nickvonklemp/Masters-Report/thesis.tex

%=====================================================================
%	UCT MECHATRONICS GROUP TEMPLATE
%---------------------------------------------------------------------
%	Template made by:		R.A. Verrinder
% 	Written  by:	N.R. Von Klemperer
%	Date Modified:	June 2016
%---------------------------------------------------------------------
%	Compile with:	TexMaker 
%=====================================================================
%	Document properties:
%---------------------------------------------------------------------
%	Paper size:			A4
%	Margins:			1 inch margins(top,bottom,left,right)
%	Printing:			Double sided (twoside book)
%	Base font size:		11pt
%	Line spacing:		
%	Paragraph spacing:	10pt
%	Paragraph indent:	0pt
%=====================================================================

\documentclass[a4paper, 11pt, oneside, openright, parskip=full]{book}
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
\newcommand{\city}{Rondebosch, Cape Town}				% City
\newcommand{\country}{South Africa}						% Country
\newcommand{\degre}{Masters of Science}				% Degree (Doctor of Philosophy 
														% or Master of Science)
\newcommand{\degreeabv}{MSc}							% Degree abbreviation (PhD or MSc.)			
\newcommand{\aemail}{Nicholas.VonKlemperer@alumni.uct.ac.za}			% Author email address
\newcommand{\supervisor}{Supervisor}					% Supervisor
\newcommand{\hod}{Prof. E. Boje}						% Head of Department

\newcommand{\logo}										% UCT Logo
{	
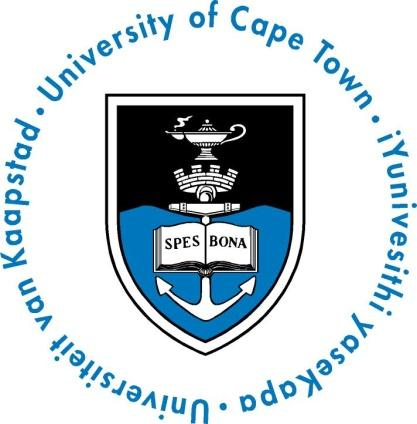
[picture p1: figs/uctLogo.png]
	
}

\newdateformat{mydate}{\monthname[\THEMONTH] \THEYEAR} % Month Year date
\newcommand{\key}{Nonlinear Control, Control Allocation, Quadrotor, UAV}					   % Keywords (add logical keywords)
\newcommand{\norm}[1]{\left\lVert#1\right\rVert}
%---------------------------------------------------------------------
%	MACROS
%---------------------------------------------------------------------
% Signature box
%---------------------------------------------------------------------
\newcommand*{\signature}[1]
{
	\par\noindent\makebox [5cm]{\hrulefill}
	\par\noindent\makebox [5cm][1]{#1}
}
\newtheorem{theorem}{Theorem}[section]
\newtheorem{corollary}{Corollary}[theorem]
\newtheorem{axiom}{Axiom}[theorem]
\newtheorem{lemma}[theorem]{Lemma}
%---------------------------------------------------------------------
% Macro to select font style
% phv = helvetica (sans serif)
% pcr = courier	  (typewritter font)
%---------------------------------------------------------------------
\def\nfont#1#2
{
	{\fontfamily{#1}\selectfont #2}
}					
%---------------------------------------------------------------------
% Creates an block for a block diagram
%---------------------------------------------------------------------
\tikzstyle{arrow}=[->,shorten <=1pt,>=stealth',semithick]
%---------------------------------------------------------------------
%block 1
%---------------------------------------------------------------------
\tikzstyle{block}=[rectangle,
				   draw=black,
				   fill=gray!10,
				   thick, 
				   minimum height = 2cm, 
				   text width=0.15*\columnwidth,]
\tikzstyle{input}  		= [coordinate]
\tikzstyle{output} 		= [coordinate]
\tikzstyle{pinstyle} 	= [pin edge={to-,thin,black}]
\tikzstyle{sum} 		= [draw, fill=blue!20, circle, node distance=1cm]
%---------------------------------------------------------------------
%block 2
%---------------------------------------------------------------------
\tikzstyle{block2}=[rectangle,
				   draw=black,
				   fill=gray!10,
				   thick, 
				   minimum height = 1.8cm, 
				   text width=0.1*\columnwidth,]
\tikzstyle{input}  		= [coordinate]
\tikzstyle{output} 		= [coordinate]
\tikzstyle{pinstyle} 	= [pin edge={to-,thin,black}]
\tikzstyle{sum} 		= [draw, fill=blue!20, circle, node distance=1cm]
%---------------------------------------------------------------------
%flow charts
%---------------------------------------------------------------------
\tikzstyle{state}     = 	[rectangle, 
							 text width=0.15*\columnwidth=2cm, 
							 minimum  height=1.5cm, 
							 text centered, 
							 draw=black]
							 
\tikzstyle{statement}  = 	[rectangle, 
							 text width=0.15*\columnwidth=2cm, 
							 minimum  height=0.5cm, 
							 text centered, 
							 draw=black]							 
							 
\tikzstyle{condition}  = 	[rectangle, 
							 text width=0.15*\columnwidth=2cm, 
							 minimum  height=1cm, 
							 rounded corners =10pt,
							 text centered, 
							 draw=black]
\tikzstyle{decision}  = 	[diamond, 
			                 minimum width=2cm, 
			                 minimum height=1cm, 
			                 text centered, 
			                 draw=black]
\tikzstyle{line} = [draw, -latex']

\definecolor{purp}{HTML}{6C42AA}
\definecolor{brn}{HTML}{939125}
%=====================================================================
%	Start of the document
%---------------------------------------------------------------------
\begin{document}
\setcounter{MaxMatrixCols}{20}
%=====================================================================
%	TITLE PAGE
%=====================================================================
\begin{titlepage}
	\centering
	\vspace*{1cm}

%---------------------------------------------------------------------
% Title
%---------------------------------------------------------------------	
	\begin{Huge}					
		\bfseries\titl\par
		\vskip 5mm
		%\hrule
		%\vskip 1.2cm
	\end{Huge}
%---------------------------------------------------------------------
% Subtitle	(optional)
%---------------------------------------------------------------------
	\begin{Large}					
		\subtitle\\*
		\vskip 3cm
	\end{Large}
%---------------------------------------------------------------------
% UCT logo
%---------------------------------------------------------------------	
	\logo							
	\vskip 1.5cm	
%---------------------------------------------------------------------
% Author	
%---------------------------------------------------------------------	
	\begin{Large}					
		\bfseries\auth\\
	\end{Large}
%---------------------------------------------------------------------
% Author's address	
%---------------------------------------------------------------------		
	\begin{normalsize}				
		\vskip 2mm	
		\dept\\*
		\uni\\*
		\city\\*
		\country\\*
		
		\vskip 15mm	
	\end{normalsize}
%---------------------------------------------------------------------
% Supervisor (optional)	
%---------------------------------------------------------------------		
%	\begin{large}					
%		{\itshape Supervisor: \\*}
%		\supervisor\\
%		\vskip 5mm
%	\end{large}
%---------------------------------------------------------------------
% Date	
%---------------------------------------------------------------------
	\begin{Large}					
		{\bfseries \mydate\today}
		\vskip 15mm	
	\end{Large}
%---------------------------------------------------------------------
% Degree	
%---------------------------------------------------------------------		
		\degreeabv\ dissertation submitted in fulfillment of the requirements for the degree of \degre\ in the \dept\ at the \uni
		
		\vskip 15mm	
%---------------------------------------------------------------------
% Keywords	
%---------------------------------------------------------------------		
	\begin{normalsize}				
		{\itshape Keywords:}
		\key			
	\end{normalsize}	
\end{titlepage}
\afterpage{\null\newpage}
%=====================================================================
%	FRONT MATTER
%=====================================================================
\frontmatter
\begin{center}
\begin{minipage}{0.7\textwidth}
\centering
``\emph{We're gonna have a superconductor turned up full blast and pointed at you for the duration of this next test. I'll be honest, we're throwing science at the wall here to see what sticks. No idea what it'll do. Probably nothing. Best-case scenario, you might get some superpowers\ldots}"
\\
Cave Johnson -Founder \& CEO of Aperture Science
\end{minipage}
\end{center}
%---------------------------------------------------------------------
%	Declaration
%---------------------------------------------------------------------
\chapter{Declaration}				
\label{ch:decl}
% Change name
I, \auth,  hereby:

\begin{enumerate}
	\item		grant the \uni\  free license to reproduce the above dissertation in whole or in part, for the purpose of research only;
	\item		declare that:
	
	\begin{enumerate}
		\item		This dissertation is my own unaided work, both in concept and execution, and apart from the normal guidance from my supervisor, I have received no assistance except as stated below:
				% Note any exceptions
		\item		Neither the substance nor any part of the above dissertation has been submitted in the past, or is being, or is to be submitted for a degree at this University or at any other university, except as stated below.
		\item		Unless otherwise stated or cited, any and all illustrations or diagrams demonstrated in this work are my own productions.
				% Note any exceptions
		\item 		All the content used to compile this report and complete the investigation revolving around the whole project is collectively hosted on the following GIT repositories:
		\begin{itemize}
			\item \LaTeX report: \url{https://github.com/nickvonklemp/Masters-Report}
			\item STM32F303 projects: \url{https://github.com/nickvonklemp/Code}
			\item Hardware Schematics: \url{https://github.com/nickvonklemp/visio} \&
			\item EagleCad Schematics \url{https://github.com/nickvonklemp/Eagle}
			\item MatLab Simulink Code: \url{https://github.com/nickvonklemp/Simulink}
			\item Results \& Simulation Data: \url{https://github.com/nickvonklemp/results}
			\item All CAD design files \& assemblies: \url{https://grabcad.com/nick.vk-1}
		\end{itemize}
	\end{enumerate}	
\end{enumerate}

\begin{flushright}	% Signature field
	\vskip 2cm
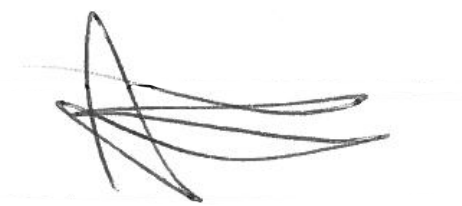
[picture p2: figs/sign.png]
	\noindent 
	\vspace{-20pt}
	\noindent \signature{x}
	\noindent \auth \\*
	\vskip 2mm
	\noindent \dept \\*
	\noindent \uni \\*
	\vskip 2mm
	\noindent \today
\end{flushright}
%---------------------------------------------------------------------
%	Abstract
%---------------------------------------------------------------------
\chapter{Abstract}				
\label{ch:abs}
%---------------------------------------------------------------------
\begin{center}
	\textbf{\Large \titl}\\
			\vskip 0.2cm
			\auth\\
			\vskip 0.2cm
	\textit{\footnotesize\today}
			\vskip 1cm
\end{center}
%---------------------------------------------------------------------
This dissertation aims to apply non-zero attitude and position setpoint tracking to a quadrotor aircraft, achieved by solving the problem of a quadrotor's inherent underactuation. The introduction of extra actuation aims to mechanically accommodate for stable tracking of non-zero state trajectories. The requirement of the project is to design, model, simulate and control a novel quadrotor platform which can articulate all six degrees of rotational and translational freedom (6-\emph{DOF}) by redirecting and vectoring each propeller's individually produced thrust. 
\par
Considering the extended articulation, the proposal is to add an additional two axes (degrees) of actuation to each propeller on a traditional quadrotor frame. Each lift propeller can be independently pitched or rolled relative to the body frame. Such an adaptation, to what is an otherwise well understood aircraft, produces an over-actuated control problem. Being first and foremost a control engineering project, the focus of this work is plant model identification and control solution of the proposed aircraft design. A higher-level setpoint tracking control loop designs a generalized plant input (net forces and torques) to act on the vehicle. An allocation rule then distributes that \emph{virtual} input in solving for explicit actuator servo positions and rotational propeller speeds.
\par
The dissertation is structured as follows: First a schedule of relevant existing works is reviewed in Ch:\ref{ch:intro} following an introduction to the project. Thereafter the prototype's design is detailed in Ch:\ref{ch:proto}, however only the final outcome of the design stage is presented. Following that, kinematics associated with generalized rigid body motion are derived in Ch:\ref{ch:dynamics} and subsequently expanded to incorporate any aerodynamic and multibody nonlinearities which may arise as a result of the aircraft's configuration (changes). Higher-level state tracking control design is applied in Ch:\ref{ch:control} whilst lower-level control allocation rules are then proposed in Ch:\ref{ch:allocation}. Next, a comprehensive simulation is constructed in Ch:\ref{ch:simulation}, based on the plant dynamics derived in order to test and compare the proposed controller techniques. Finally a conclusion on the design(s) proposed and results achieved is presented in Ch:\ref{ch:conclusion}.
\par
Throughout the research, physical tests and simulations are used to corroborate proposed models or theorems. It was decided to omit flight tests of the platform due to time constraints, those aspects of the project remain open to further investigation. The subsequent embedded systems design stemming from the proposed control plant is outlined in the latter of Ch:\ref{ch:proto}, Sec:\ref{sec:proto.layout}. Such implementations are not investigated here but design proposals are suggested. The primary outcome of the investigation is ascertaining the practicality and feasibility of such a design, most importantly whether or not the complexity of the mechanical design is an acceptable compromise for the additional degrees of control actuation introduced. Control derivations and the prototype design presented here are by no means optimal nor the most exhaustive solutions, focus is placed on the whole system and not just a single aspect of it.
\par
%---------------------------------------------------------------------
%	Acknowledgements
%---------------------------------------------------------------------
\chapter{Acknowledgements}		
\label{ch:ack}
%---------------------------------------------------------------------
Firstly, I would like to thank Prof Edward Boje for the supervision he provided throughout this research. Secondly, without the support of everyone in the Mechatronics Lab (Room 6.00) at the University of Cape Town, this project would not have been possible. And last, but certainly not least, I would like to thank my parents who supported and guided me throughout the tenure of my studies. 
%---------------------------------------------------------------------
%	Nomenclature
%---------------------------------------------------------------------
\chapter{Nomenclature}
\label{ch:nom}
%---------------------------------------------------------------------
\underline{In order of appearance:}
\par
3-D : Three-dimensional vector components in Cartesian XYZ axial
4-DOF : 4 Degrees of freedom, reduced attitude control\\
6-DOF : 6 Degrees of freedom, full attitude and position states\\
ABC - Adaptive backstepping control\\
BLDC : Brushless-DC, motor\\
BEM : Blade element theory, calculation for produced thrust from propeller\\
CMG : Control moment gyroscope, satellite actuator\\
CH: Channel, number of PWM lines or RC channels \\
DIY : Do it yourself, quadcopter assembly kit in context example\\
dOAT : Dual-axis opposed active tilting, two-axis birotor rotation\\
ESC : Electronic speed controller\\
FTC : Fault tolerant control\\
GCS : Ground control station, supplements onboard control loops for UAVs\\
IBC - Ideal backstepping control\\
IMU : Inertial measurement unit, an MEM 9-DOF accelerometer/gyroscope/magnetometer\\
ITAE : Integral time absolute error, cost function used for optimization\\
KV : Kilo-volt, thousand RPM per V applied, BLDC motor rating\\
LQR : Linear quadratic regulator control structure\\
LCF : Lyapunov candidate function\\
MPC : Model predictive control\\
MEMS : Micro-electromechanical system, accelerometer or gyroscopes\\
OAT : Opposed active tilting, single-axis birotor rotation\\
PD : Proportional + derivative controller\\
P.D : Positive definite\\
PWM : Pulse width modulation\\
PID : Proportional + integral + derivative controller\\
PSO : Particle swarm optimization\\
QFT : Quantitative feedback theory\\
RPM : Revolution per minute, units for propeller rotational 
velocity\\
RPS : Revolution per second, units for propeller speed when calculating BEM thrust\\
Rx : Receiver channel, comms line input\\
S.bus : Serial.Bus, proprietary encoding of UART comms\\
SISO : Single input single output, typical control loop\\
STP : Standard temperature and pressure\\
TSK : Takagi-Sugeno-Kang, fuzzy logic paradigm\\
Tx : Transmitter channel, comms line output
$\mu$C : Micro-controller\\
UAV : Unmanned aerial vehicle, any autonomous aircraft\\
USART : Universal synchronous/asynchronous receiver transmitter, 2 wire comms\\
VTOL : Vertical takeoff/landing. Helicopter or quad/bi-rotor\\
 directions\\
%---------------------------------------------------------------------
%	Symbols
%---------------------------------------------------------------------
\chapter{Symbols}
\label{ch:symbol}
%---------------------------------------------------------------------
An arrowed overbar implies vector quantity (column vector)\\
A vector with an $T$ superscript refers to that vector's transpose\\
A subscript $\mu$ denotes a control input quantity\\
A subscript $i$ refers to a quantity associated with the $i^{\text{th}}$ motor module\\
Any subscript numbered $1\rightarrow 4$ refer to quantities associated with a particular motor module\\
Axes are referred to with hat accents and described as an axis in context\\
Estimated quantities are also denoted with a hat accent but are similarly described as an estimate in context\\
Lowercase axis quantities are unit vectors in a particular axial direction\\
Uppercase axis quantities refer to the axes themselves\\
Bold faced vectors are lumped state variables\\
Dot accents denote derivatives of vectors or quantities\\
Subscripts $M_i$ imply reference to the $i^{\text{th}}$ motor module's frame\\
The frame $\mathcal{F}^i$ refers to the $i^{\text{th}}$ reference frame\\
An origin of a frame is given by $\vec{\mathbf{O}}_i$\\
Lowercase body vectors imply state trajectories\\
Uppercase bold vectors represent Euler-Lagrange generalized forces acting as a result of the same case's lowercase trajectory
\par
Where possible, typical conventions for quantities and notations have been adhered to
\par
$\alpha_i$ motor module rotation about the $\hat{Y}_{M_i'}$ axis\\
$\delta (\varepsilon)$ stable trajectory's maximum bound\\
$\varepsilon$ stable trajectory initial bounding manifold\\
$\vec{\eta}=[\phi~\theta~\psi]^T~~\in\mathcal{F}^{I,v_1,v_2}$ Euler angle set\\
$\vec{\eta}_b \in\mathcal{F}^b$ transformed Euler angles in common shared body frame\\
$\theta$ pitch rotation about $\hat{Y}$ axis in [rad] \\
$\lambda_i$ motor module rotation about the $\hat{X}_{M_i}$ axis\\
$\vec{\nu}_d=[\vec{F}_d~\vec{\tau}_d\hspace{2pt}]^T\in\mathcal{F}^b$ generalized virtual control input\\
$\vec{\xi}$ generalized position coordinate\\
$\rho$ STP airdensity\\
$\sigma_i$ motor module rotation about the $\hat{Z}_{M_i''}$ axis\\
$\vec{\tau}_\mu = [\tau_\phi~\tau_\theta~\tau_\psi]^T~~\in\mathcal{F}^b$ input torque in [Nm]\\
$\vec{\tau}_d = h(\vec{\eta}_e,~\dot{\vec{\eta}}_e,~t)~~\in\mathcal{F}^b$ attitude controller generated torque input in [Nm]\\
$\phi$ roll rotation about $\hat{X}$ axis in [rad] \\
$\psi$ yaw rotation about $\hat{Z}$ axis in [rad]\\
$\vec{\omega}_b=[p~q~r]^T~~\in\mathcal{F}^b$ angular velocity in body frame with units $[\text{rad.s}^{-1}]$\\
$\Omega_i$ rotational velocity of $i^{\text{th}}$ propeller, in [RPM] or [RPS] specified\\
\par
$\mathbf{AS}$ asymptotic stability\\
$b$ subscript for net multibody assembly\\
$c$ propeller chord length\\
$\vec{C}_x$ center of mass for body x, relative to origin $\vec{\mathbf{O}}_b$\\
$C_T(J)$ aerodynamic thrust coefficient, varies as function of the advance ratio\\
$C_P(J)$ aerodynamic power coefficient, varies as function of the advance ratio\\
$D$ propeller diameter\\
$\vec{D}(\vec{v}_b)$ aerodynamic drag as a function of the vehicle's net translational velocity\\
$\vec{\mathcal{E}}_I=[x~y~z]^T~~\in\mathcal{F}^{I}$ inertial position in [m]\\
$\mathbf{ES}$ exponential stability\\
$\vec{F}_d=g(\vec{\mathcal{E}}_e,~\dot{\vec{\mathcal{E}}}_e,~t)~~\in\mathcal{F}^b$ position controller generated force input in [N]\\
$\vec{F}_\mu=[F_x~F_y~F_z]^T~~\in\mathcal{F}^b$ input force in [N]\\
$\mathbf{GUAS}$ global uniform asymptotic stability\\
$\mathbf{GUES}$ global uniform exponential stability\\
$\vec{H}$ generalized attitude coordinate\\
$in$ subscript for inner ring assembly \emph{without} rotor body contribution\\
$J$ aerodynamic advance ratio, inflow velocity relative to propeller's rotational speed\\
$J_x$ moment of inertia for body x, relative to the frame provided in context measured in $[\text{kg.m}^{2}]$\\
$\vec{L}_i$ vector arm length from $\vec{\mathbf{O}}_b$ origin in $[\text{m}]$\\
$\mathcal{L}_x$ Lagrangian scalar with respect to body x\\
$m$ subscript for middle ring assembly\\
$m_x$ mass for body x in $[\text{kg}]$\\
$\vec{\mathbf{M}}_i$ $i^\text{th}$ motor module center of rotation\\
$n$ subscript for inner ring assembly\\
$\vec{\mathbf{O}}_b$ body frame origin of motion\\
$p$ subscript for net motor module assembly\\
$q_0$ and vector $\vec{q}$ components\\
$Q_b=[q_0~\vec{q}\hspace{2pt}]^T$ attitude quaternion with scalar 
$r$ subscript for rotor body\\
$\vec{r}(t)$ generalized path trajectory for Euler-Lagrange equation\\
$\mathbf{S}$ general stability\\
$T$ Kinetic energy\\
$T(\Omega_i)$ scalar propeller thrust as a function of rotational speed\\
$\vec{u}=[\Omega_1~...~\alpha_4]^T$ actuator plant input matrix, $\in\mathbb{R}^{12}$\\
$U$ Potential energy
$\mathbf{UAS}$ uniform asymptotic stability\\
$\mathbf{US}$ uniform stability\\
$\vec{v}_b=[u~v~w]^T~~\in\mathcal{F}^b$ translational velocity in body frame with units $[\text{m.s}^{-1}]$\\
$V(\vec{\mathbf{r}})$ Lyapunov function of some trajectory $\vec{\mathbf{r}}(t)$\\
$x$ translational position in the $\hat{X}_I$ axis direction\\
$\vec{\mathbf{x}}_b$ full 6-DOF state for combined attitude and position\\
$\vec{\mathbf{x}}_d$ desired state setpoint\\
$\vec{\mathbf{x}}_e$ error state, not necessarily subtractive, quaternion errors are multiplicative\\
$y$ subscript for constant body frame structure\\
$y$ translational position in the $\hat{Y}_I$ axis direction\\
$z$ translational height in the $\hat{Z}_I$ axis direction\\

%---------------------------------------------------------------------
%	Dedication (optional)
%---------------------------------------------------------------------
%\begin{flushright}
%	\vspace*{10cm}
%	{\itshape dedication .....}
%\end{flushright}
%---------------------------------------------------------------------
%	Table of Contents
%---------------------------------------------------------------------
\tableofcontents

%---------------------------------------------------------------------
%	List of Figures
%---------------------------------------------------------------------
\listoffigures

%---------------------------------------------------------------------
%	List of Tables
%---------------------------------------------------------------------
\listoftables

%---------------------------------------------------------------------
%	List of Symbols/Document conventions (optional)
%---------------------------------------------------------------------

%---------------------------------------------------------------------
%	Glossary (optional)
%---------------------------------------------------------------------

%=====================================================================
%	MAIN MATTER
%=====================================================================
% Create a separate file for each chapter. You may chose to rename these
% chapters as needed.
%---------------------------------------------------------------------
\mainmatter
\include{ch1}
\include{ch2}
\include{ch3}
\include{ch4}
\include{ch5}
\include{ch6}
\include{ch7}
\include{appendix}

%=====================================================================
%	BACK MATTER
%=====================================================================

\backmatter

%---------------------------------------------------------------------
%	BIBLIOGRAPHY
%---------------------------------------------------------------------

\raggedright
\bibliographystyle{plain}
\bibliography{thesis}

%---------------------------------------------------------------------
\end{document}
%---------------------------------------------------------------------
%	End of the document
%=====================================================================
