nickvonklemp/Masters-Report/ch6.tex

%====================================================
%	CHAPTER 6 - Control & Simulations
%====================================================
\chapter{Simulations and  Discussion of Results}
\label{ch:simulation}
%====================================================
\section{Simulator description}
\label{sec:simulation.block}
%====================================================
The proposed attitude and position control laws, together with the system's equations of motion including each actuator's transfer function, were all tested in simulation to determine a particular controller's efficacy. The rigid-body equations of motion from Sec:\ref{subsec:dynamics.rigidbody.lagrange}, with nonlinearities from Sec:\ref{sec:dynamics.aero} and multibody responses from Sec:\ref{sec:dynamics.nonlinearities}, were incorporated into a high-fidelity simulation environment. Closely matching the dynamics of the physical quadrotor prototype proposed in Sec:\ref{sec:proto.design}, where measurement data produced by tests in Sec:\ref{subsec:dynamics.nonlinearities.torque-tests} provides a degree of confidence in the simulation's accuracy. The consolidated quaternion dynamics in Sec:\ref{sec:dynamics.model} formed the basis of the simulation, building a loop extended from the control structure in Fig:\ref{fig:control-block}. Each control law is optimized first without the effect of the servo's $180$\textdegree ~saturation limit. Limiting the servos was a conscious design decision, and so its effects are investigated in Sec:\ref{sec:simulation.saturation}. For now, the servos are treated as continuous rotational actuators without saturation limits.
\par
\begin{figure}[htbp]
\centering
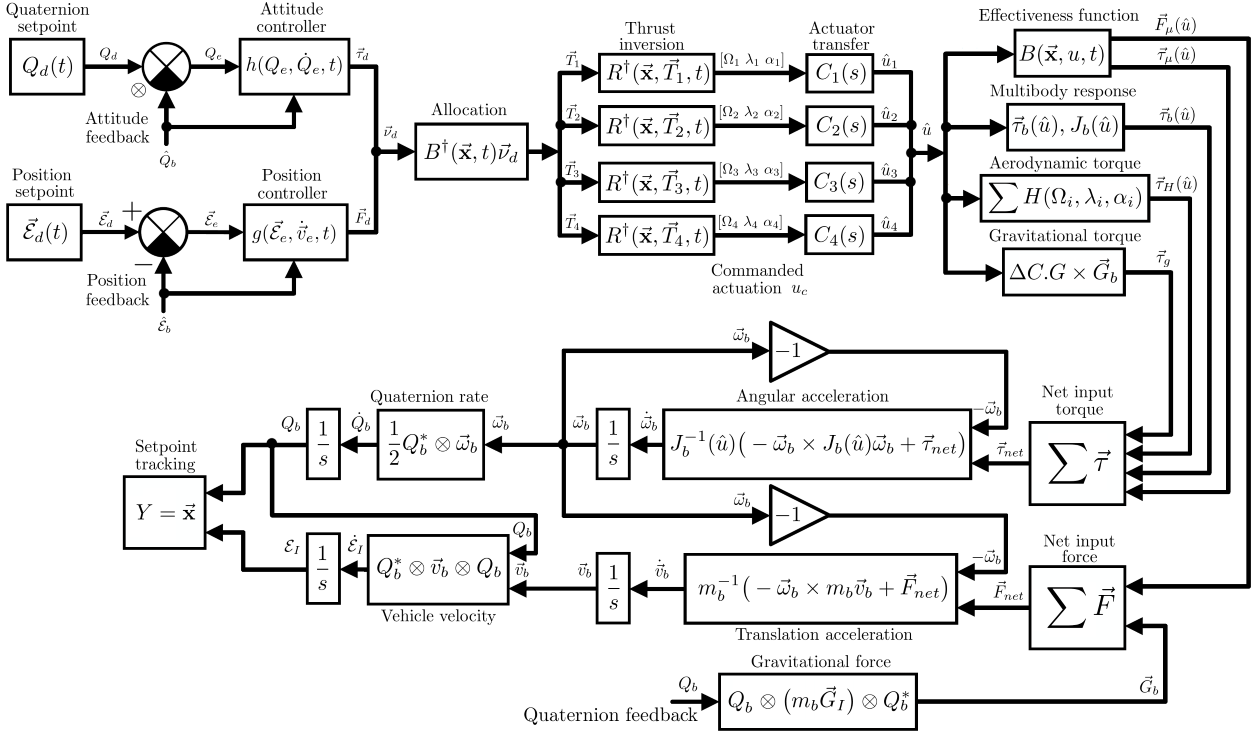
[picture p115: figs/simulation-block.png]

\vspace{-10pt}
\caption{Simulation loop}
\label{fig:simulation-block}
\end{figure}
\par
An abstracted simulation loop is illustrated in Fig:\ref{fig:simulation-block}, incorporating both attitude and position control loops together with the additive nonlinearities. Certain feedback elements were omitted to retain clarity in the diagram, both Coriolis and gyroscopic nonlinear cross-products were included to highlight the inherent coupling between attitude and position. Not shown, but implied, is some form of state-estimation or discretization between the state-tracking output $y=\vec{\mathbf{x}}=[\vec{\mathcal{E}}_I~Q_b\hspace{2pt}]^T$ and the feedback state estimate $\hat{\mathbf{x}}$ used for setpoint tracking. Discretized effects of state-estimators are discussed later in Sec:\ref{sec:simulation.state}. Initial conditions for each state's integrator, both position $\vec{\mathcal{E}}_I(0)$ and attitude $Q_b(0)$ origins, for their velocities $\dot{\mathcal{E}}_b$ and $\dot{Q}_b$ (and accelerations $\dot{\vec{v}}_b$ and $\dot{\vec{\omega}}_b$ in the body frame $\mathcal{F}^b$) are not illustrated but implied. Obviously starting conditions are important for each trajectory's simulation, but are specifically defined for each simulation in question. Actuator transfer functions from Sec:\ref{subsec:proto.design.transfer} are combined into a bundled $C_{i}(S)$ block, accounting for transfer functions and nonlinear saturation limits of each motor module. Each bundled input $\vec{u}_{[1:4]}$ is similarly the projected actuator matrix:
\begin{equation}
\vec{u}_i = \begin{bmatrix}
\Omega_i & \lambda_i & \alpha_i
\end{bmatrix}~~~~\text{for}~i\in[1:4]
\end{equation}
The resultant thrust vector $\vec{T}_i$ produced by each motor module has a net transfer function as a result of the propeller speed and servo rotation dynamics. Lastly, setpoints for both attitude and position states are either stepped or produced from an orbital trajectory. The former is used for controller optimization, whilst the latter is used for setpoint tracking performance evaluation. To discuss the question of non-zero setpoint tracking, an orbital trajectory with an increasing orbital (\emph{chirp}) frequency generates attitude and position setpoints, illustrated in Fig:\ref{fig:trajectory}.
\begin{figure}[htbp]
\vspace{-10pt}
\centering
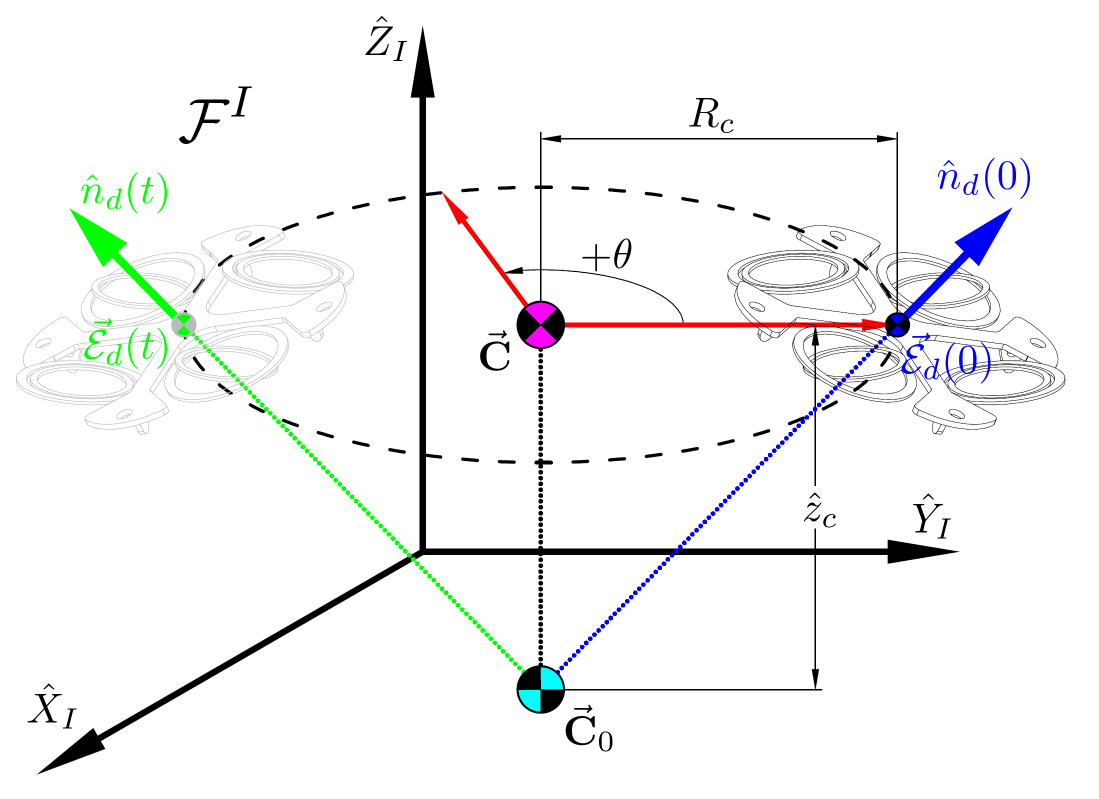
[picture p116: figs/trajectory.png]

\vspace{-12pt}
\caption{Orbital trajectory}
\label{fig:trajectory}
\vspace{-20pt}
\end{figure}
\par
The trajectory generates only first-order attitude and position setpoints. Furthermore, the trajectory setpoint is a body's attitude and inertial position, no actuator values for the aircraft's configuration are commanded by a trajectory. For a central point in the inertial frame $\vec{C}_0\in\mathcal{F}^I$, the trajectory orbits with a \emph{chirpiness} (frequency rate) of $\dot{\omega}~[\text{Hz.s}^{-1}]$ around that center. The orbit is at a height of $\hat{z}_c~[\text{m}]$ and at a radius $R_c~[\text{m}]$ from the center $\vec{C}$. The position setpoint then follows:
\begin{subequations}
\begin{equation}\label{eq:position-trajectory}
\vec{\mathcal{E}}_{d}(t)=\begin{bmatrix}
C_{0x}+R_c\cos\big(\dot{\omega}(t^2)\big)\\
C_{0y}+R_c\sin\big(\dot{\omega}(t^2)\big)\\
\hat{z}_c
\end{bmatrix}~~~~\in\mathcal{F}^I
\end{equation}
{\emph{\color{Gray}The frequency rate $\dot{\omega}$ used in Eq:\ref{eq:position-trajectory} describes the rate at which a chirp generated trajectory increases. It is not the same as a body's angular velocity $\vec{\omega}_b$. By convention, a signal's frequency is annotated by $\omega$.}}
\par
The time varying trajectory's attitude setpoint is aligned with a normal vector $\hat{n}_d(t)$, banking the vehicle away from the center point $\vec{C}_0$:
\begin{equation}
\hat{n}_d(t)\triangleq\frac{\vec{\mathcal{E}}_d(t)-\vec{C}_0}{\sqrt{\hat{z}_c^2+R_c^2}}
\end{equation}
The normal $\hat{n}_d$ is used to construct a quaternion setpoint $Q_d(t)$ which varies together with the orbital trajectory:
\begin{equation}
Q_d(t)=\begin{bmatrix}
\sin \frac{\theta(t)}{2} & \cos \frac{\theta(t)}{2}\hat{n}_d(t)
\end{bmatrix}^T
\end{equation}
\end{subequations}
Whilst the trajectory equation itself may have a non-zero time derivative, both attitude and position controllers still apply the respective rate setpoints to the state variables $\dot{\vec{\mathcal{E}}}_d(t)=\vec{0}$ and $\dot{Q}_d(t)=\vec{0}$ throughout the entire trajectory, as per Eq:\ref{eq:4.85a} and Eq:\ref{eq:4.27c}. The plot in Fig:\ref{fig:Trajectory_Plot} shows a chirp quaternion and attitude trajectory, $Q_d(t)$ and $\vec{\mathcal{E}}_d(t)$ respectively, over a time period of $240~[\text{s}]$. The trajectory starts at $\vec{\mathcal{E}}_d(t_0)=[6~6~5]^T~[\text{m}]$, which produces a non-zero starting attitude $Q_d(t_0)=[0.38~0.42~0.24~0.7]^T$, Eq:\ref{fig:Position_Trajectory}.
\begin{figure}[htbp]
\vspace{-6pt}
\centering
\begin{subfigure}{\textwidth}
\centering
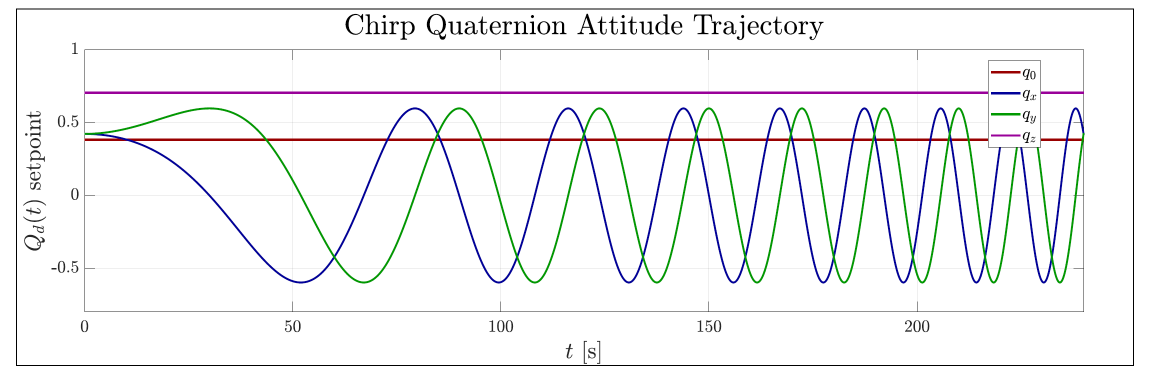
[picture p117: graphs/Attitude_Trajectory.png]

\vspace{-6pt}
\caption{Quaternion setpoints}
\label{fig:Attitude_Trajectory}
\end{subfigure}
\begin{subfigure}{\textwidth}
\centering
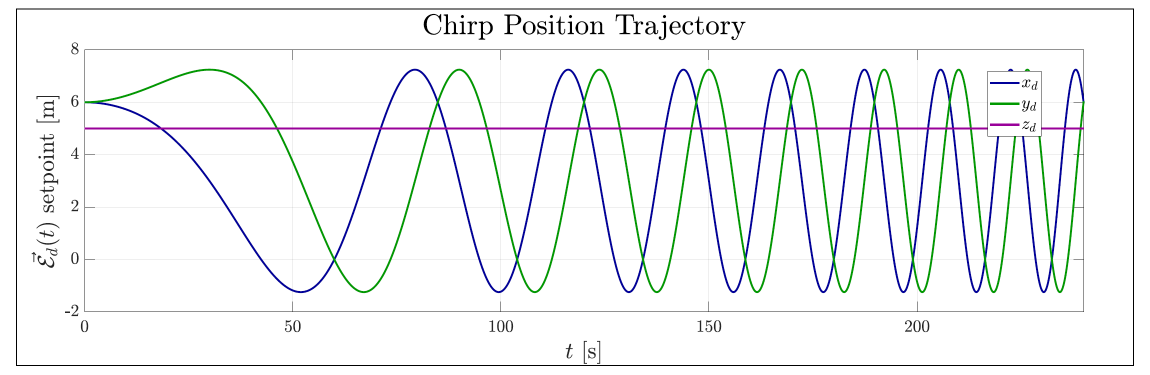
[picture p118: graphs/Position_Trajectory.png]

\vspace{-6pt}
\caption{Position setpoints}
\label{fig:Position_Trajectory}
\end{subfigure}
\vspace{-8pt}
\caption{Chirp trajectory plots}
\label{fig:Trajectory_Plot}
\vspace{-12pt}
\end{figure}
%====================================================
\section{Controller Tuning}
\label{sec:simulation.tuning}
%====================================================
Each proposed control law's proven stability (in Sec:\ref{sec:control.attitude} and Sec:\ref{sec:control.position} for attitude and postition controllers respectively) demonstrates only a control law's setpoint tracking (error stability) for a time $t\rightarrow\infty$. The caveat to Lyapunov's stability theorem is that a trajectory is shown to be stabilizing, however no further insight into the controller coefficient design is provided. Often at the coefficient selection stage, a \emph{Monte Carlo} approach is applied to select and optimize the controller coefficients.
%====================================================
\subsection{Particle Swarm Optimization Algorithm}
\label{subsec:simulation.tuning.pso}
%====================================================
Particle swarm based optimization (\emph{PSO}) has been shown in both \cite{adaptivepso} and \cite{autopilotPSO}, amongst others, to be an effective controller coefficient design tool. The algorithm treats a potential set of controller coefficients as a single \emph{particle} which exists within some defined search space. The collection or \emph{swarm} of possible particles explores the search space directed by both the swarm's previous performance as well as the relative performance of the swarm between each particle. In \cite{particletrajectories} the statistical nature of the swarm's trajectory is discussed, however such investigations are beyond the scope of this work.
\par
In general, the PSO algorithm applies a \emph{gradient-free} based search of solutions for a given optimization problem. The lack of a specified cost function gradient is an important distinction which differentiates PSO from other algorithms (note the swarm does update as per a pseudo-velocity function). Often a predefined cost function gradient is required to direct the optimization search at each interval, MatLab's fmincon\cite{fmincon} or Interior-Point optimizer\cite{ipopt} algorithms for example. Interval gradient calculations can be computationally exhaustive and reduce the rate of execution for the entire process. An optimizer's performance is directly proportional to the number of complete iterations it executes, and if an iteration has a high degree of complexity (simulation \emph{stiffness}) its solution time is then adversely affected. The PSO algorithm is defined as follows: if there exists a set $\vec{x}$ of $k$ variables, $\vec{x}\in\mathbb{R}^{k\times 1}$ to be optimized, the swarm of particles (starting at particle $\vec{x}_0$) has an $n^{\text{th}}$ interval position $\vec{x}_n$ which progresses through the search space as per a velocity $\vec{v}_n$:
\begin{subequations}
\begin{equation}
\vec{x}_{n+1}=\vec{v}_{n}+x_{n}
\end{equation}
\vspace{-18pt}
\begin{equation}\label{eq:swarm-velocity}
\vec{v}_{n+1}\triangleq w\ast \vec{v}_n+c_1\ast r_1\big(\vec{P}_{best}-\vec{x}_n\big)+c_2\ast r_2\big(\vec{G}_{best}-\vec{x}_n\big)
\end{equation}
\end{subequations}
where each $\ast$ operator in Eq:\ref{eq:swarm-velocity} applies an element-by-element matrix coefficient multiplication. Both $\vec{P}_{best}$ and $\vec{G}_{best}$ are previous swarm positions where local and global optima were respectively achieved. Performance of the swarm's current interval is evaluated as per some cost function, responding to a system's dynamics. Finally $r_1$ and $r_2$ are random seeded $\mathbb{R}^{1\times k}$ exploratory matrices which progress the search direction, biased by the two weighting coefficients $c_1$ and $c_2$. The search is prejudiced toward local optima by $c_1$, whilst $c_2$ directs the swarm toward global optima. Fig:\ref{fig:swarm-trajectory} illustrates how positions of both local and global optima influence subsequent velocities.
\begin{figure}[hbtp]
\centering
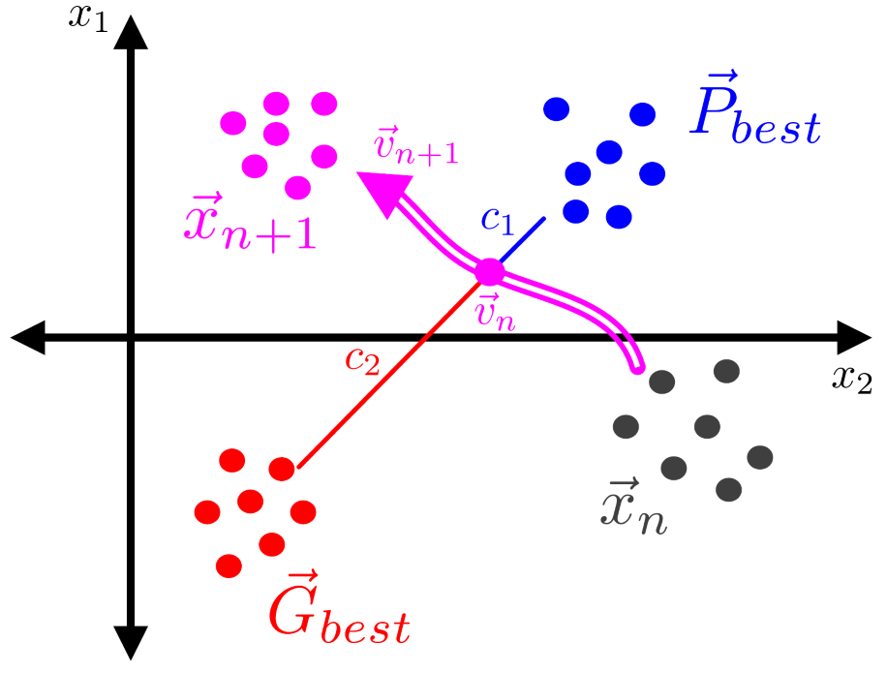
[picture p119: figs/swarm-trajectory.png]

\vspace{-10pt}
\caption{Swarm trajectory's velocity direction}
\label{fig:swarm-trajectory}
\vspace{-8pt}
\end{figure}
\par
The swarm's interval performance is evaluated by the response of some modelled system to the swarm's position, typically an error deviation away from some desired state. Here, the simulation described in Fig:\ref{fig:simulation-block}, is parsed a swarm of controller coefficients as an argument and the plant's setpoint response is simulated over a series of step tests. Particulars with regards to attitude controller optimization are discussed in Sec:\ref{sec:simulation.attitude}, thereafter position controller optimization is detailed in Sec:\ref{sec:simulation.position}. The objective is for zero-error setpoint tracking so each particle's coefficient performance metric calculates an integral-time-absolute-error (\emph{ITAE}) cost function, \cite{ITAE}.
\begin{equation}
\vec{\zeta}\triangleq\int_{t_0}^{t_\infty}t||\vec{e}(t)||_2.dt
\end{equation}
with an error $\vec{e}(t)$ deviating from the plant's given setpoint. The ITAE integral $\vec{\zeta}$ is calculated over the entire simulation time, or an effective $t_\infty$. The time multiplier ensures setpoint error \emph{and} settling time optimality, punishing overshoot and under-damped or oscillatory-like behavior. Generally a PSO algorithm progresses as in the flow diagram in Fig:\ref{fig:particle-diagram}. Seeing that each controller was empirically proven to be stable irrespective of its trajectory, the controller will settle irrespective of the proposed interval coefficient values. A consequence of this is that starting conditions $\vec{x}_0$ were chosen to be a rounded set of unity.
\\
\emph{\color{Gray} Note that $\vec{\mathbf{x}}$ is a state variable in the particle swarm flow diagram Fig:\ref{fig:particle-diagram}, $\vec{j}_n$ was chosen to represent the swarm of particles acted on by the optimization algorithm in order to differentiate between the two.}
\\
\begin{figure}[htbp]
\centering
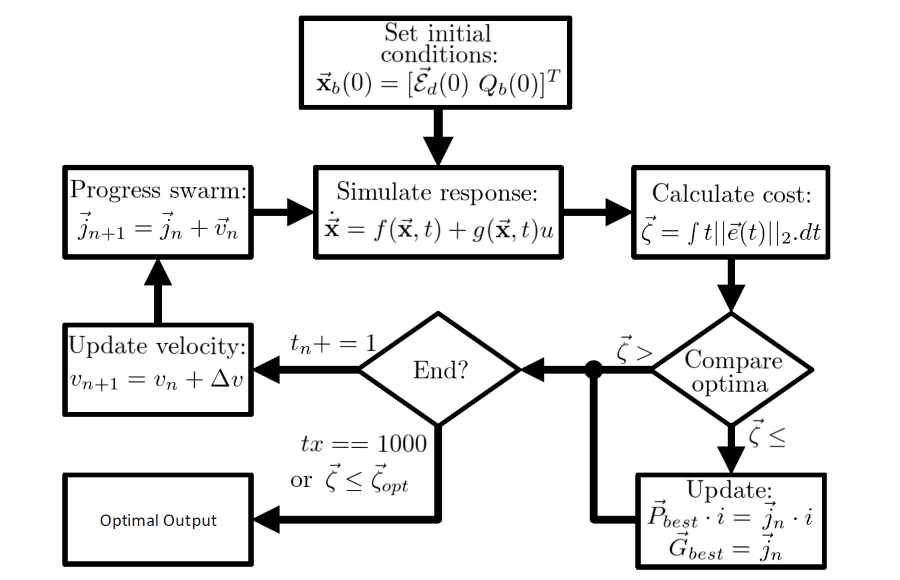
[picture p120: figs/particle-diagram.png]
\vspace{-12pt}
\caption{Particle swarm flow diagram}
\label{fig:particle-diagram}
\vspace{-18pt}
\end{figure}
\par
Termination conditions for the iterative optimization loop either limit the number of iteration cycles performed or break from the process once a result is regarded as sufficiently close to optimal. Each optimization loop was terminated only after a limited $tx=1000$ iterations, testing and evaluating one thousand different swarm values for a series of stepped setpoints. With control coefficients, it is difficult to quantify how close to optimal a particular proposed set of coefficients is. As the optimizer progressed through iterations, it adapted its bias coefficients $c_1$ and $c_2$ from focusing on global optima to local optima using fractions of the iteration number, refining the way in which it searched for potential controller coefficients.
\begin{equation}
\vec{v}_{n+1}=\vec{v}_n+\frac{tx}{1000}\ast r_1(\vec{P}_{best}-\vec{x}_n)+\frac{1000-tx}{1000}\ast r_2(\vec{G}_{best}-\vec{x}_n)~~~~\text{for}~~tx\in[1:1000]
\end{equation}
Each particle's progression was constrained such that it never violated the Lyapunov stability conditions of its respective control laws, ensuring that the coefficient matrices were kept positive definite and symmetrical.
%====================================================
\section{Attitude Controllers}
\label{sec:simulation.attitude}
%====================================================
Attitude controllers derived in Sec:\ref{sec:control.attitude} were optimized first because of their lack of coupling with the position loop. The position control loop was left in open loop with only a constant hovering force condition applied to control input $\vec{F}_d$ for each test. Pseudo-inverse allocation, Sec:\ref{subsec:allocation.allocators.inverse}, was applied to the control loop when testing each attitude controller. To evaluate an individual particle's performance, a number of step tests were performed. Each attitude setpoint was first defined in the Euler angle parametrization, being conceptually easier to visualize. Thereafter the attitude setpoints were converted to a desired quaternion attitude and applied to the simulation.
\begin{equation}
\vec{\eta}_d(t)\triangleq \begin{bmatrix}
\phi_d(t)&
\theta_d(t)&
\psi_d(t)
\end{bmatrix}^T\underset{Q}{\iff}Q_d(t)
\end{equation}
Each of the three Euler angles were stepped in the range $[-90\text{\textdegree}:+90\text{\textdegree}]$ at intervals of $30\text{\textdegree}$. This resulted in a test of three hundred and forty three possible attitude setpoints, making a test-space sphere as illustrated in Fig:\ref{fig:attitude-setpoint}. Each attitude step was simulated for $t=15~[\text{s}]$ to allow its settling point, with an initial attitude position always set to the origin $Q_b(t_0)=[1~\vec{0}\hspace{2pt}]$, with a \emph{positive} quaternion scalar. The quaternion error's scalar component was limited to $q_0\in[0:1]$, detailed in Eq:\ref{eq:constrained-quaternion-error} of Sec:\ref{subsec:control.attitude.problem}, to ensure positive definite compatibility of the proposed Lyapunov candidate functions in the control proofs. The effect of an unconstrained, negative quaternion error scalar is illustrated in Fig:\ref{fig:PD_Quaternion_Step}. 
\par
Performance for each attitude step test was evaluated by an ITAE integral for the quaternion error vector and angular velocity error. Note that each gain coefficient in a particle has its own local and global error, so the performance metric $\vec{\zeta}_{q}$ is a \emph{vector}, not a scalar quantity:
\begin{equation}\label{eq:attitude-performance}
\vec{\zeta}_{Q}=\int_{t=0}^{15}C_Q*t*q_0*||\vec{q}_e(t)||.dt+\int_{t=0}^{15}C_\omega*t*||\vec{\omega}_e(t)||.dt~~~~\in\mathbb{R}^{3}
\end{equation}
Weighting coefficients $C_Q$ and $Q_\omega$ balance priority of either quaternion or angular velocity tracking. However, tracking both were equally important and so those weights were kept at unit with respective scalar units. The cost integral in Eq:\ref{eq:attitude-performance} was averaged over all three hundred and forty three possible attitude steps to determine the overall performance of a proposed swarm of controller coefficients.
\begin{figure}[htbp]
\vspace{-6pt}
\centering
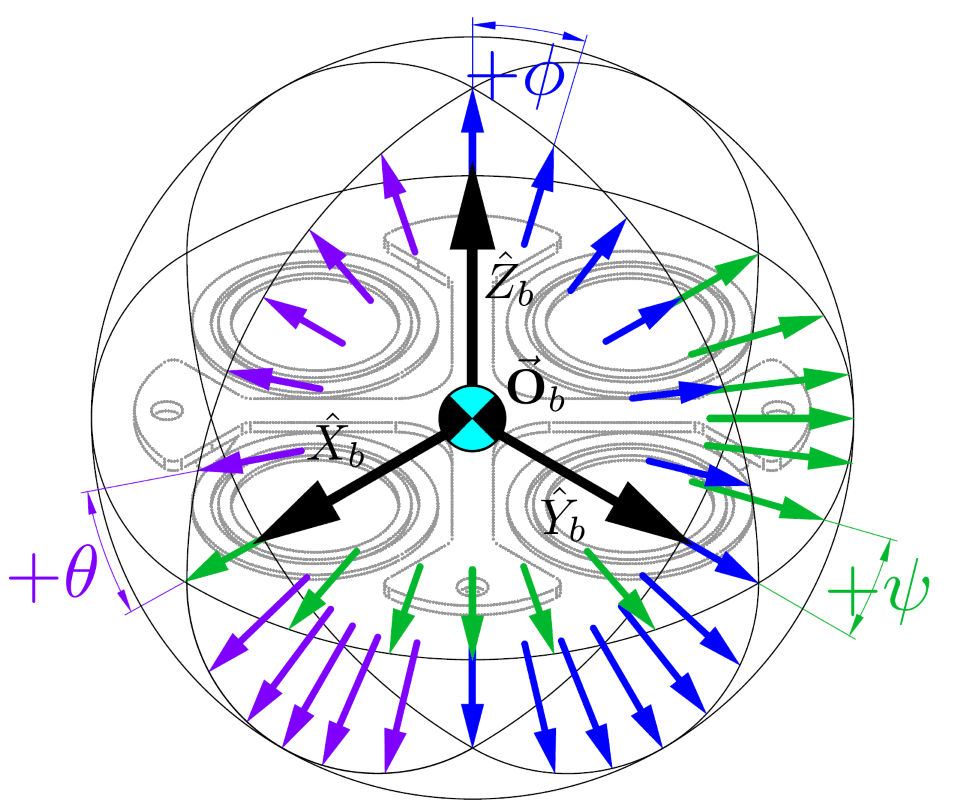
[picture p121: figs/attitude-setpoint.png]

\vspace{-6pt}
\caption{Attitude setpoint working space}
\vspace{-14pt}
\label{fig:attitude-setpoint}
\end{figure}
\par
The integral in Eq:\ref{eq:attitude-performance} produces a $\mathbb{R}^{3}$ vector result. Each coefficient in a particular controller contributes towards a local error in one of the $\hat{X},\hat{Y},\hat{Z}$ components, or in certain cases, a pair of axial components if the control coefficient is an off-diagonal element. A global error for the performance of each controller is simply the magnitude $||\vec{\zeta}_Q||$. The same global error is applicable to all controllers. 
\par
To compare the relative performance and effectiveness of each optimized control structure, a single attitude step was investigated. That attitude change was chosen to be a sizeable step in all three Euler angles to demonstrate the effect of the actuator's dynamics:
\begin{equation}\label{eq:attitude-step-position}
\vec{\eta}_d\triangleq\begin{bmatrix}
\phi_d\\
\theta_d\\
\psi_d\\
\end{bmatrix}
=
\begin{bmatrix*}[r]
-142\text{\textdegree}\\
167\text{\textdegree}\\
-45\text{\textdegree}
\end{bmatrix*}
\underset{Q}{\iff}
\begin{bmatrix}
-0.3254&
0.2226&
-0.2579&
0.8821
\end{bmatrix}^T
\end{equation}
Then each controller's settling time to $95$\% of its final value $t_{95}$ and its relative angular velocity (the setpoint $\vec{\omega}_d=\vec{0}$) for such a step is calculated. Settling time, overshoot and setpoint error are all factors to consider when discussing a controller's efficacy. Lastly, the commanded (virtual) and applied input torque to the actuator set are discussed too. A feasible controller should not induce torque saturation or unachievable input rate changes.
%====================================================
\subsection{PD}
\label{subsec:simulation.attitude.pd}
%====================================================
The first controller evaluated, the Proportional-Derivative structure, is investigated under three different circumstances. Before discussing each of the different scenarios, it is worth recalling that control structure from Sec:\ref{subsubsec:control.attitude.controllers.pd}. Control torque is designed by two coefficient matrices $K_p$ and $K_d$:
\begin{equation}\label{eq:simulation-attitde-pd}
\vec{\tau}_{_{PD}}=\underbrace{J_b(\hat{u})\big(K_p\vec{q}_e+K_d\vec{\omega}_e\big)}_{Independent}+\underbrace{\hat{\omega}_b\times J_b(\hat{u})\hat{\omega}_b+\vec{\tau}_b(\hat{u})-\vec{\tau}_g-\vec{\tau}_H}_{Compensation}~~~~\in\mathcal{F}^{b}
\end{equation}
The first two tests regard both coefficient matrices as purely diagonal, with no skew elements, testing the effect inclusion of plant-dependent compensation has on the controller's performance. Finally, a plant-dependent compensating PD controller is tested \emph{with} symmetrical coefficient matrices. The diagonal coefficient matrices are defined as follows:
\begin{equation}\label{eq:simulation-attitde-pd-diagonal-coefficients}
K_p\triangleq \begin{bmatrix}
K_p(1) & 0 & 0\\
0 & K_p(2) & 0\\
0 & 0 & K_p(3)
\end{bmatrix}
~~\text{and}~~K_d\triangleq \begin{bmatrix}
K_d(1) & 0 & 0\\
0 & K_d(2) & 0\\
0 & 0 & K_d(3)
\end{bmatrix}
\end{equation}
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
