nickvonklemp/Masters-Report/figs/body-frame.jpg

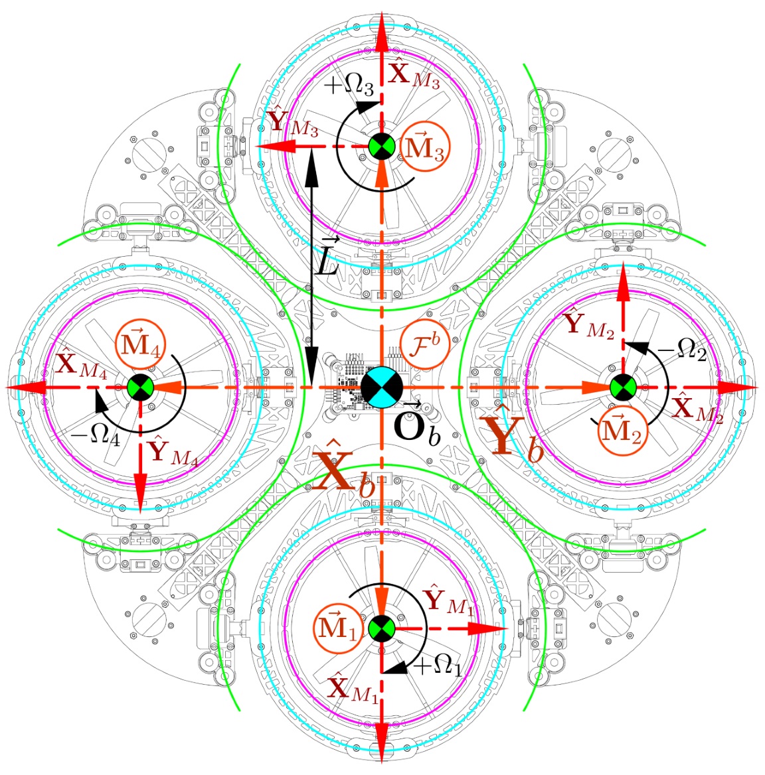
figs/body-frame.jpg
