nickvonklemp/Masters-Report/figs/cobra-motor.jpg

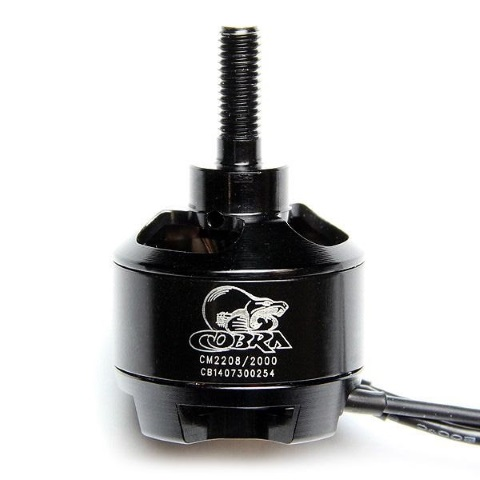
figs/cobra-motor.jpg
