nickvonklemp/Masters-Report/figs/gasco-mech.jpg

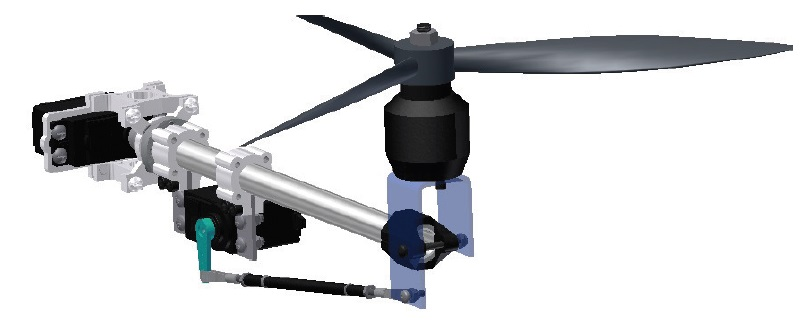
figs/gasco-mech.jpg
