nickvonklemp/Masters-Report/figs/gimbal-lock.jpg

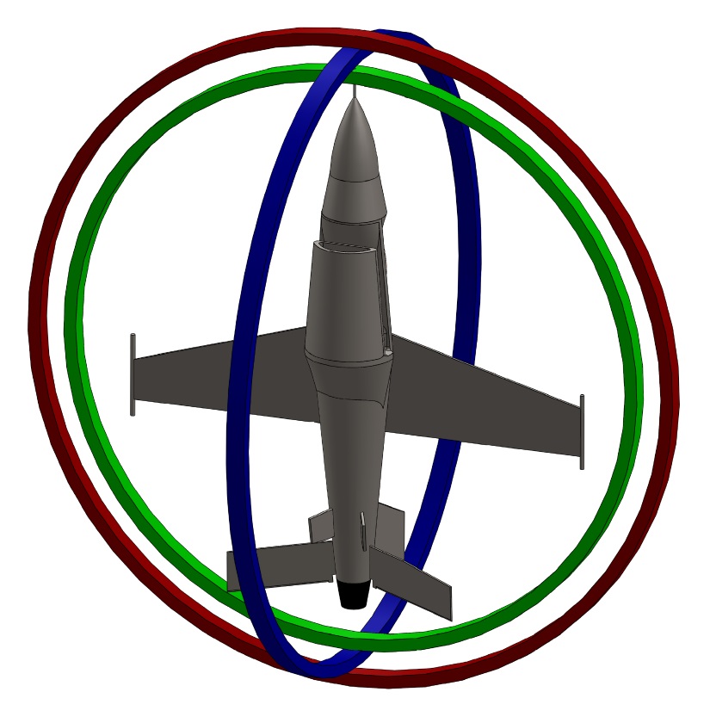
figs/gimbal-lock.jpg
