nickvonklemp/Masters-Report/figs/gimbal.jpg

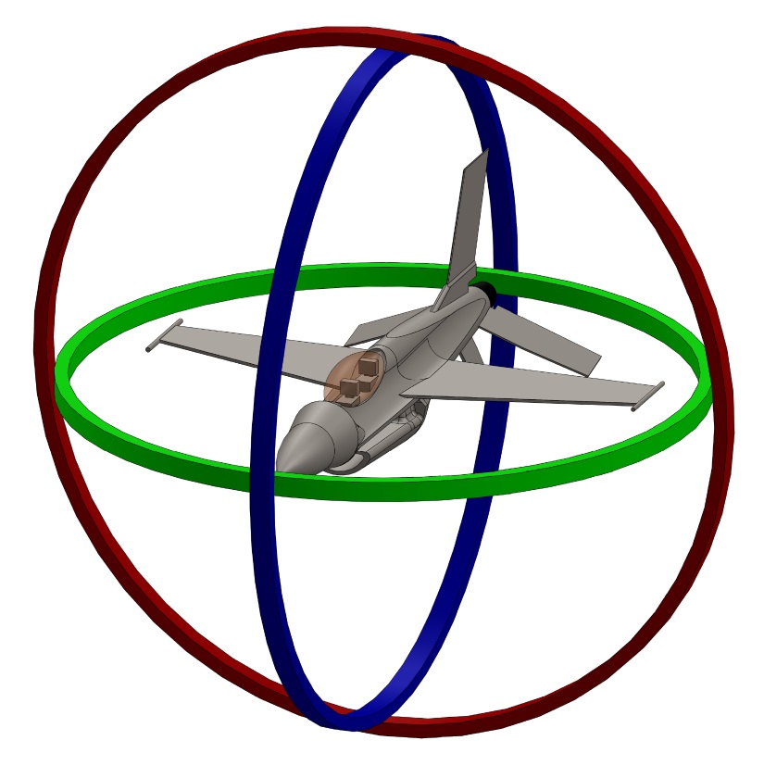
figs/gimbal.jpg
