nickvonklemp/Masters-Report/figs/hover-body.jpg

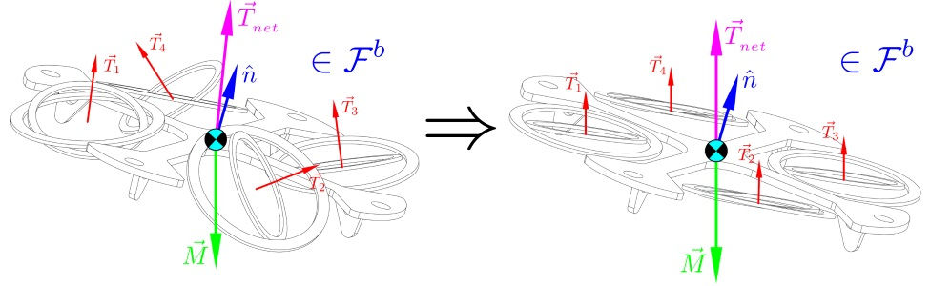
figs/hover-body.jpg
