nickvonklemp/Masters-Report/figs/hover-inertial.jpg

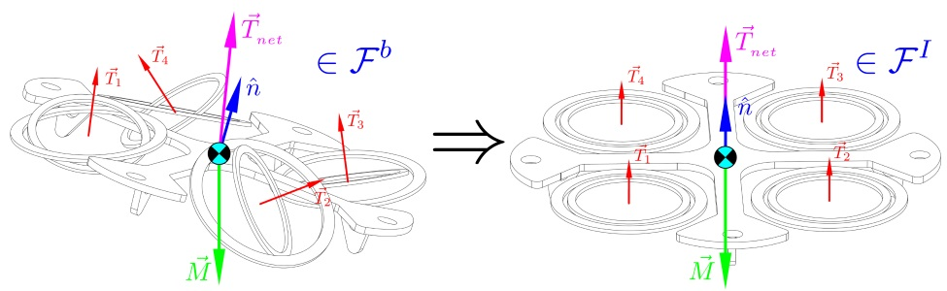
figs/hover-inertial.jpg
