nickvonklemp/Masters-Report/figs/inertia-center.jpg

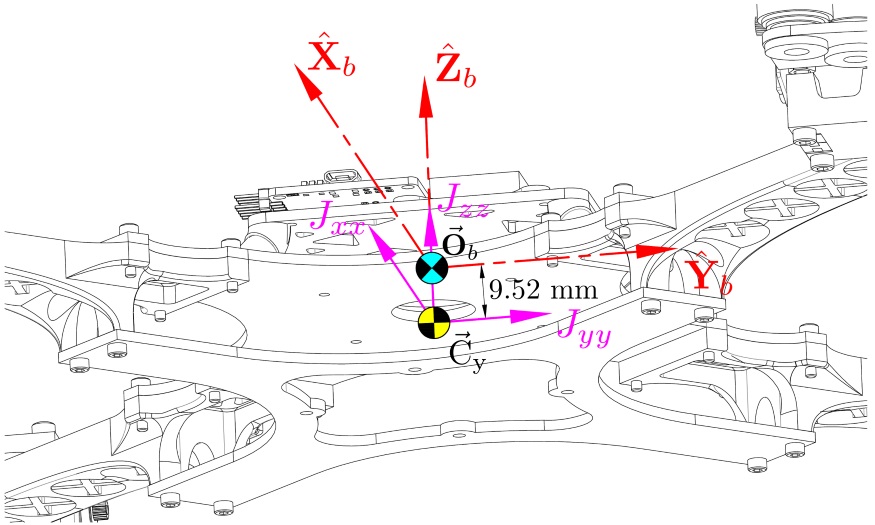
figs/inertia-center.jpg
