nickvonklemp/Masters-Report/figs/inertia-damping.jpg

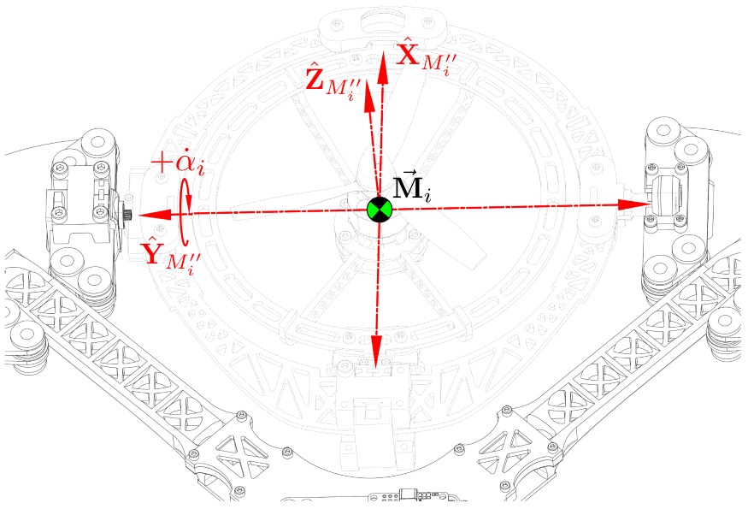
figs/inertia-damping.jpg
