nickvonklemp/Masters-Report/figs/inertia-frame.jpg

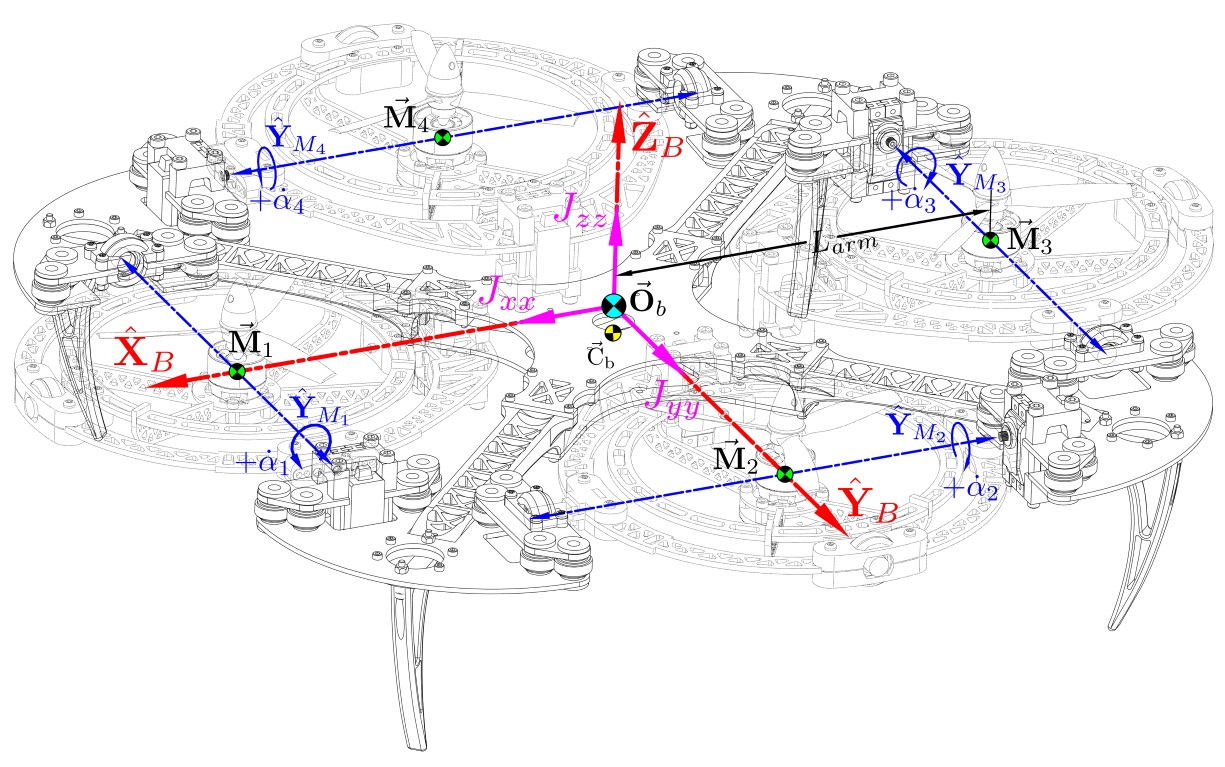
figs/inertia-frame.jpg
