nickvonklemp/Masters-Report/figs/inertia-inner.jpg

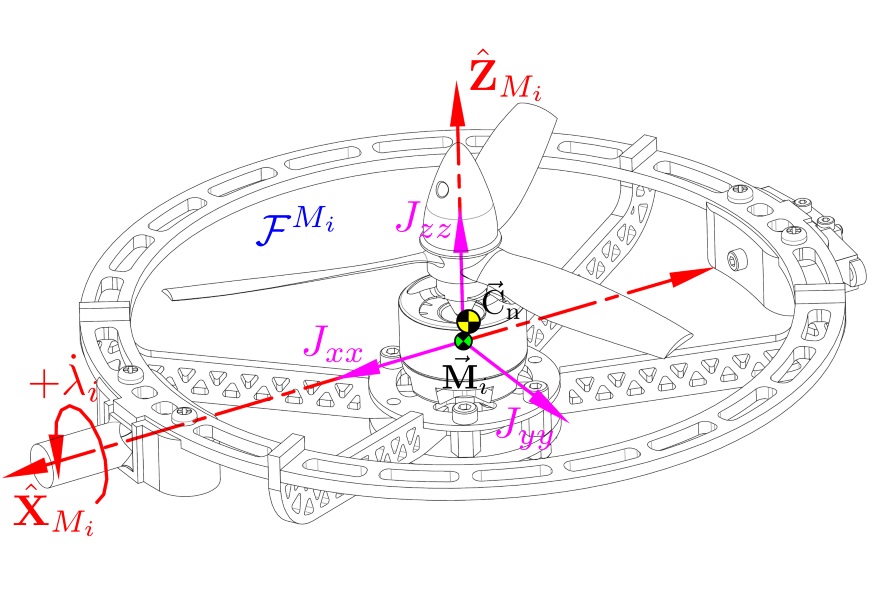
figs/inertia-inner.jpg
