nickvonklemp/Masters-Report/figs/inertia-middle.jpg

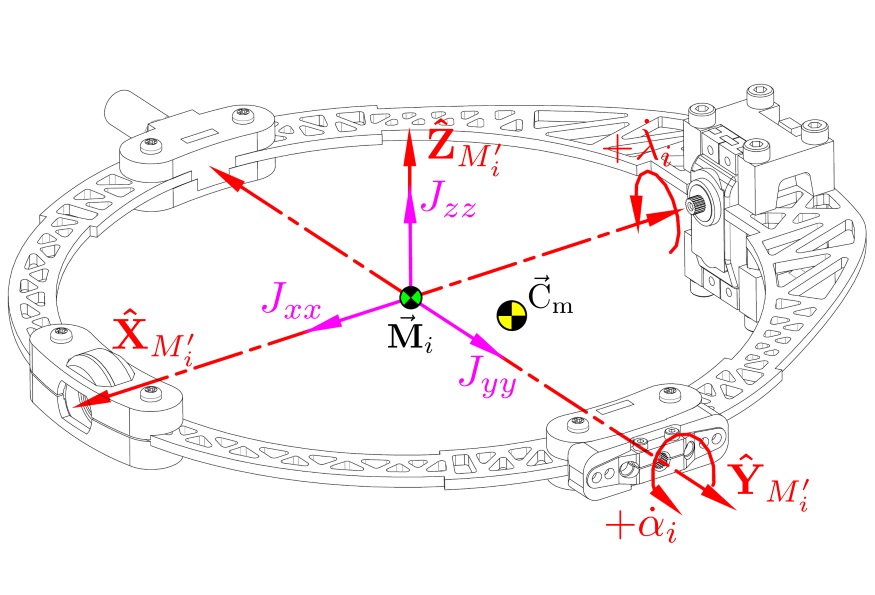
figs/inertia-middle.jpg
