nickvonklemp/Masters-Report/figs/inertia-module.jpg

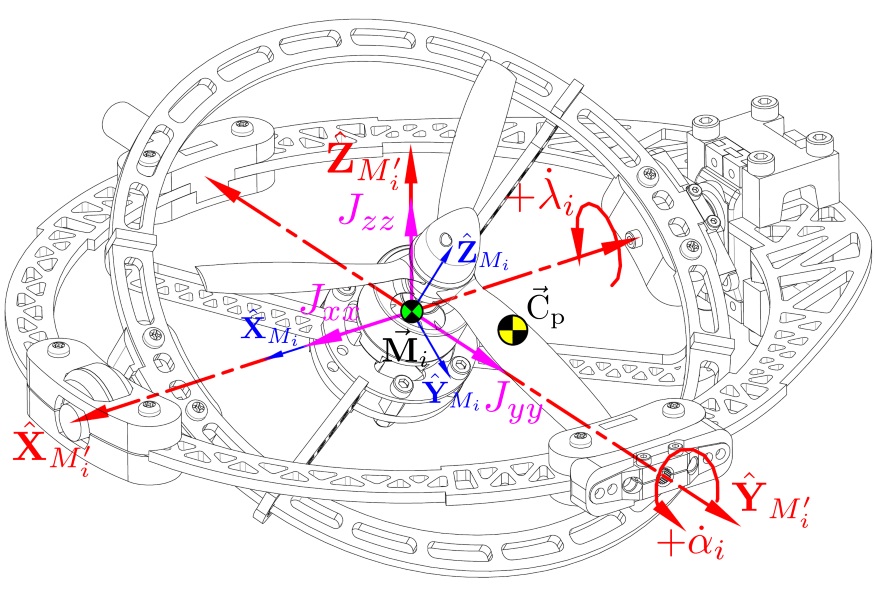
figs/inertia-module.jpg
