nickvonklemp/Masters-Report/figs/motor-axes.jpg

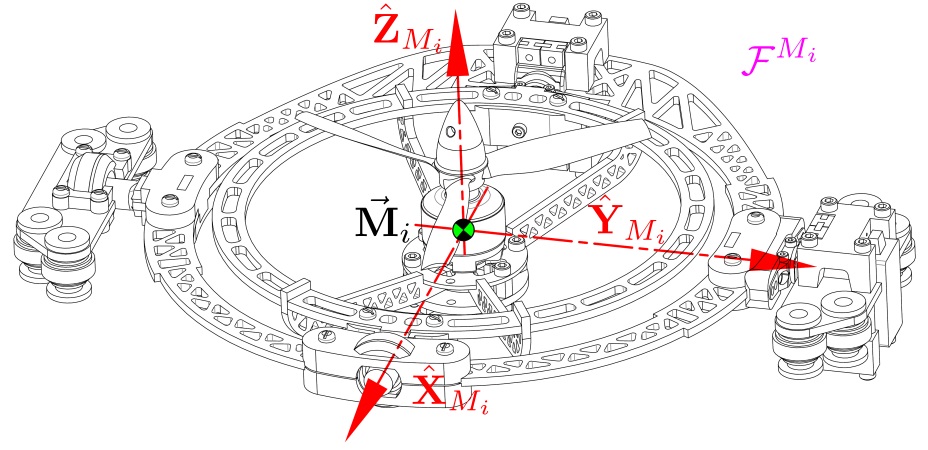
figs/motor-axes.jpg
