nickvonklemp/Masters-Report/figs/motor-prop.jpg

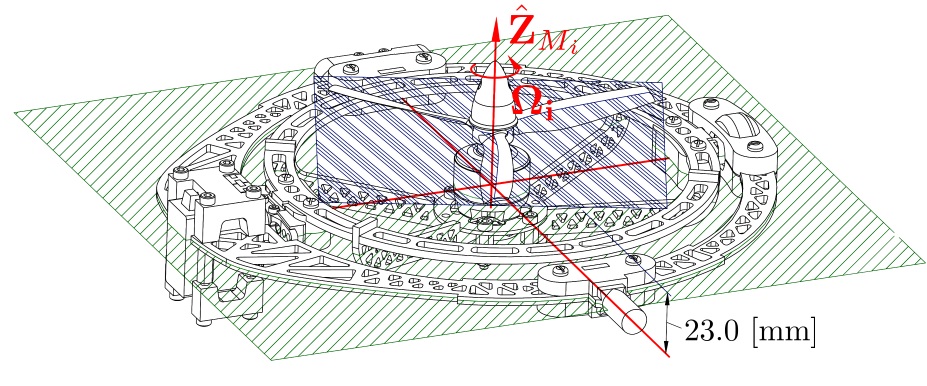
figs/motor-prop.jpg
