nickvonklemp/Masters-Report/figs/net-force.jpg

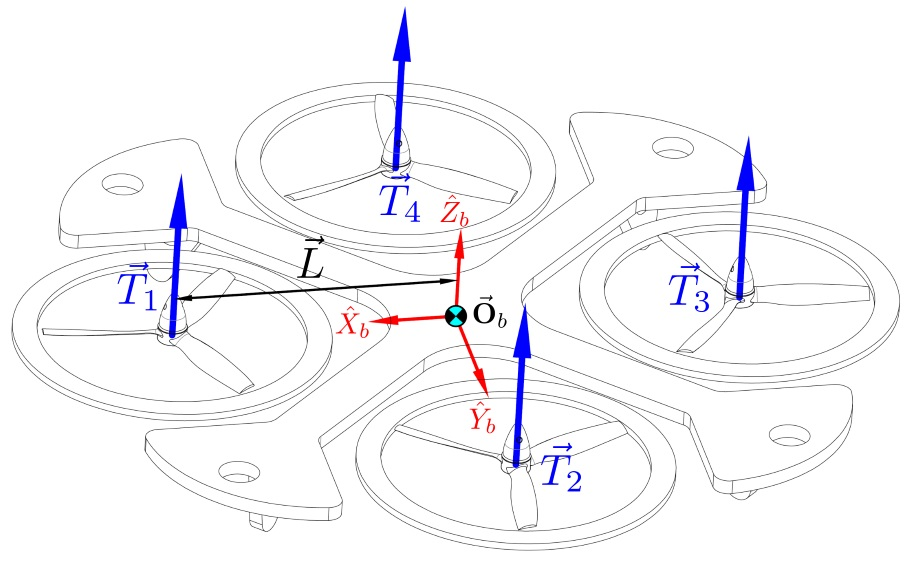
figs/net-force.jpg
