nickvonklemp/Masters-Report/figs/position-setpoint.jpg

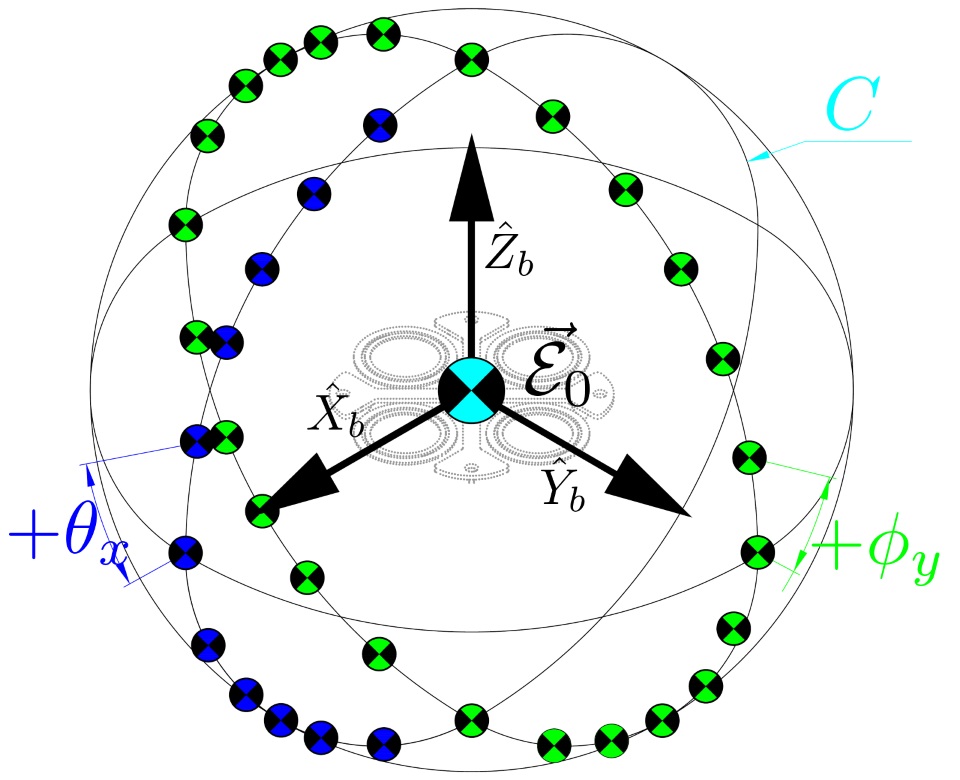
figs/position-setpoint.jpg
