nickvonklemp/Masters-Report/figs/reference-frame.jpg

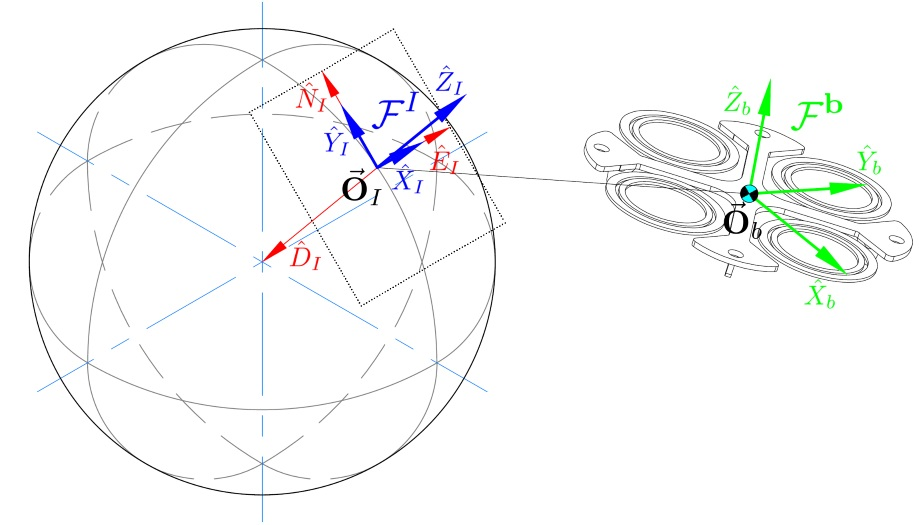
figs/reference-frame.jpg
