nickvonklemp/Masters-Report/figs/response-body.jpg

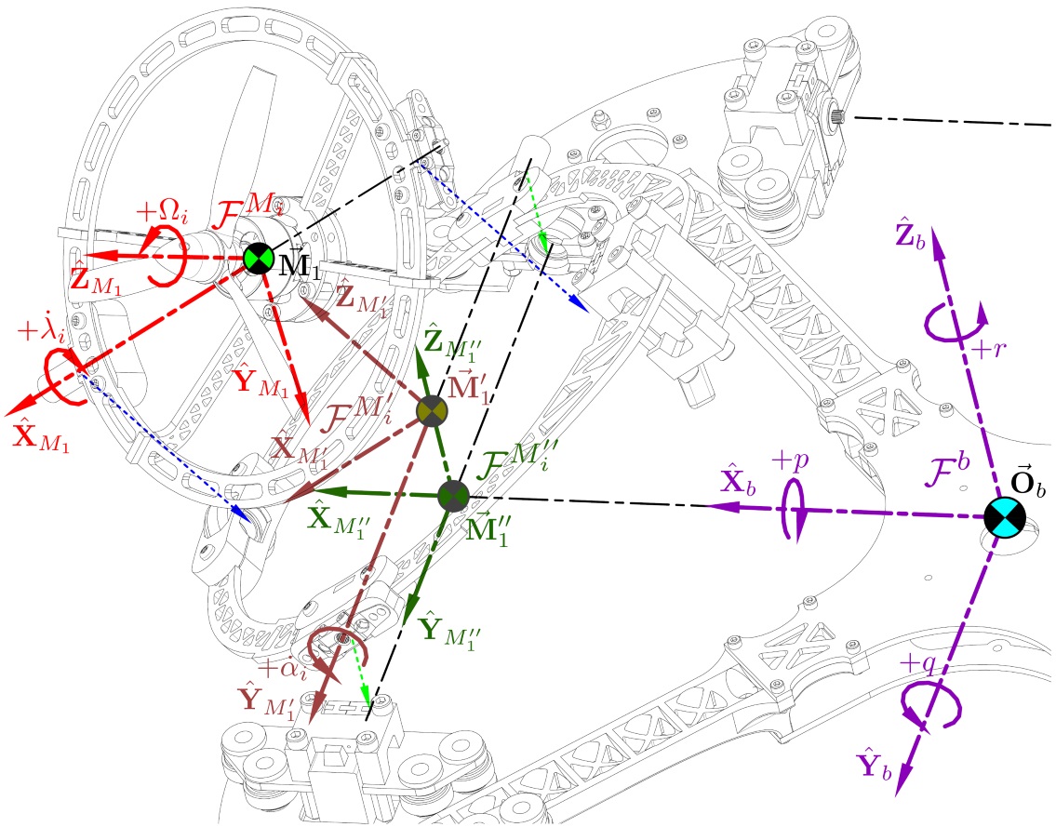
figs/response-body.jpg
