nickvonklemp/Masters-Report/figs/response-inner.jpg

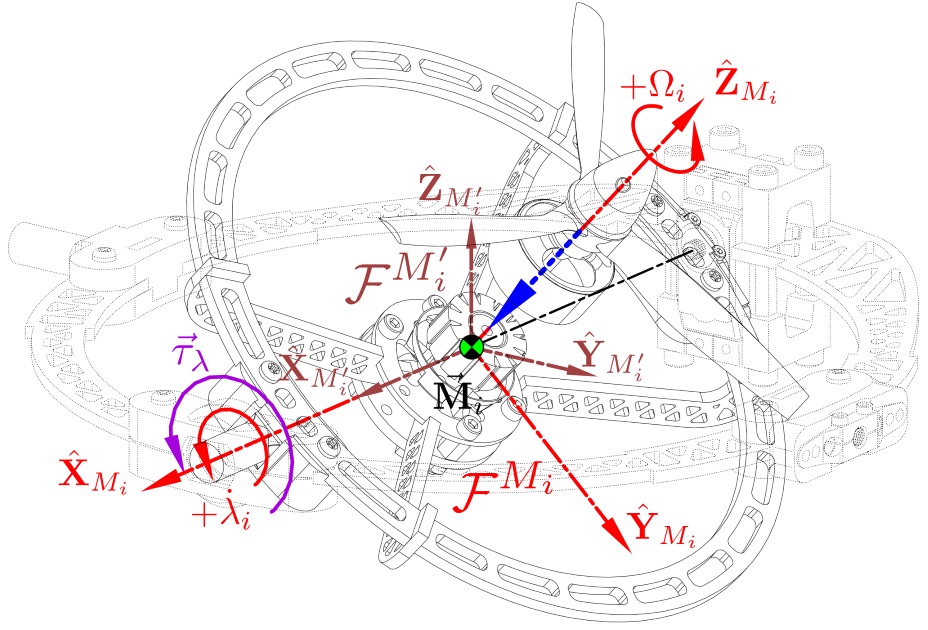
figs/response-inner.jpg
