nickvonklemp/Masters-Report/figs/response-middle.jpg

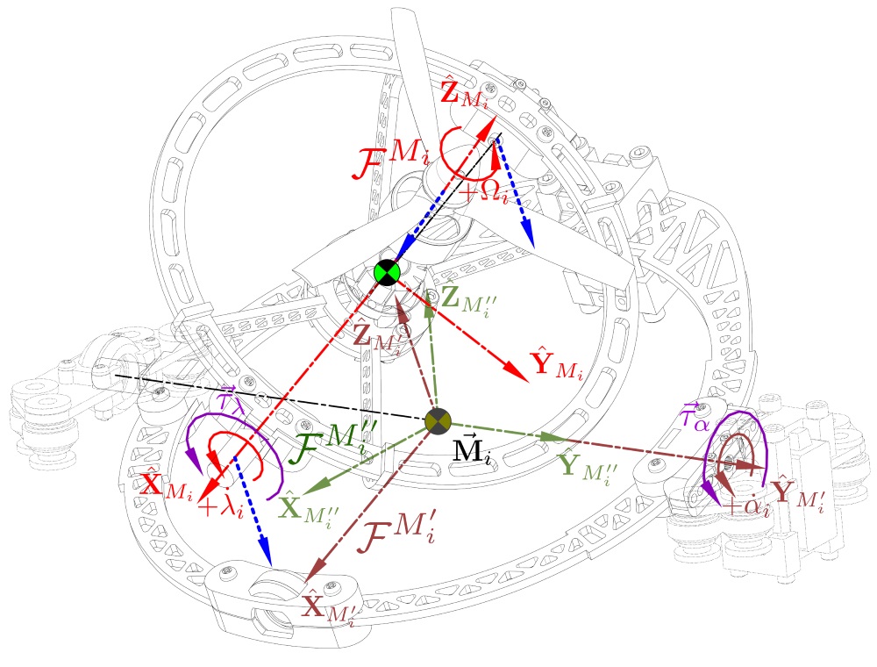
figs/response-middle.jpg
