nickvonklemp/Masters-Report/figs/torque-inner.jpg

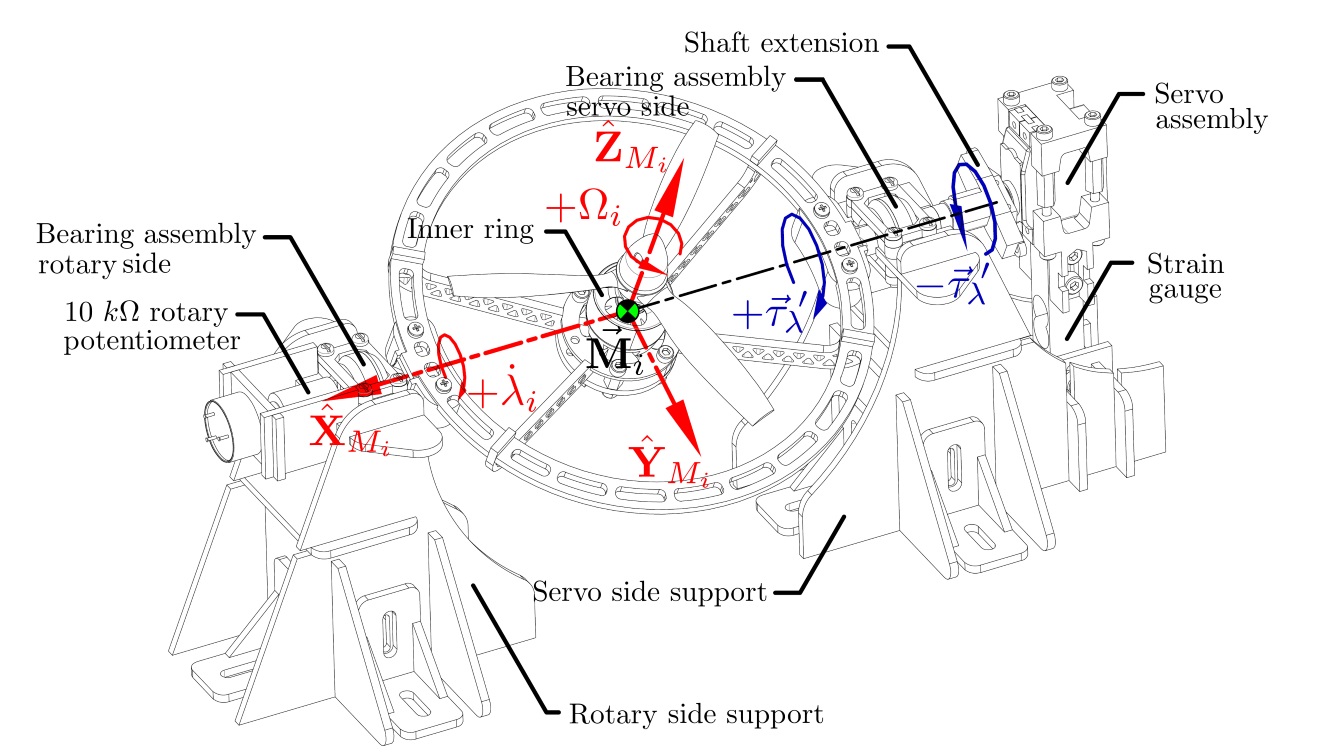
figs/torque-inner.jpg
