nickvonklemp/Masters-Report/figs/torque-middle.jpg

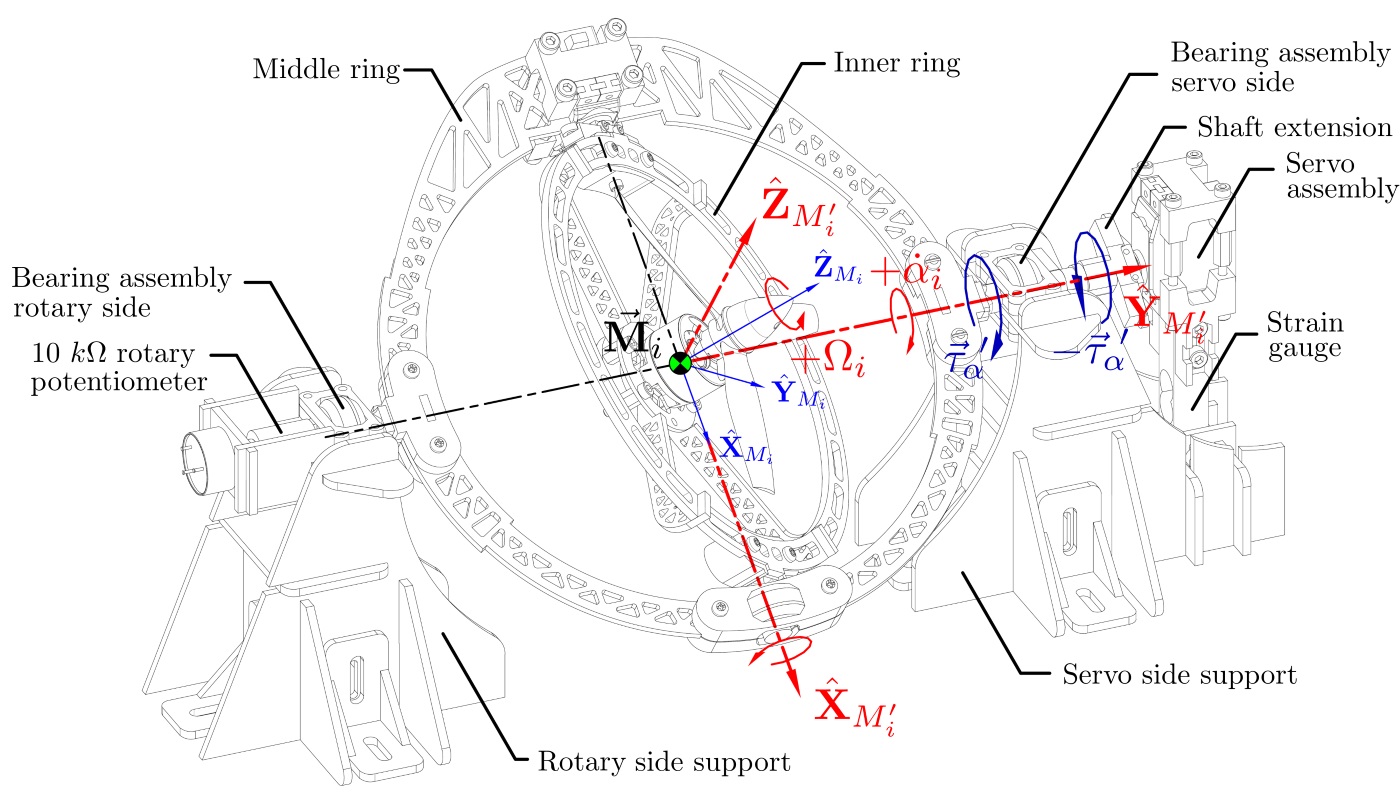
figs/torque-middle.jpg
