nickvonklemp/Masters-Report/figs/vector-diff.jpg

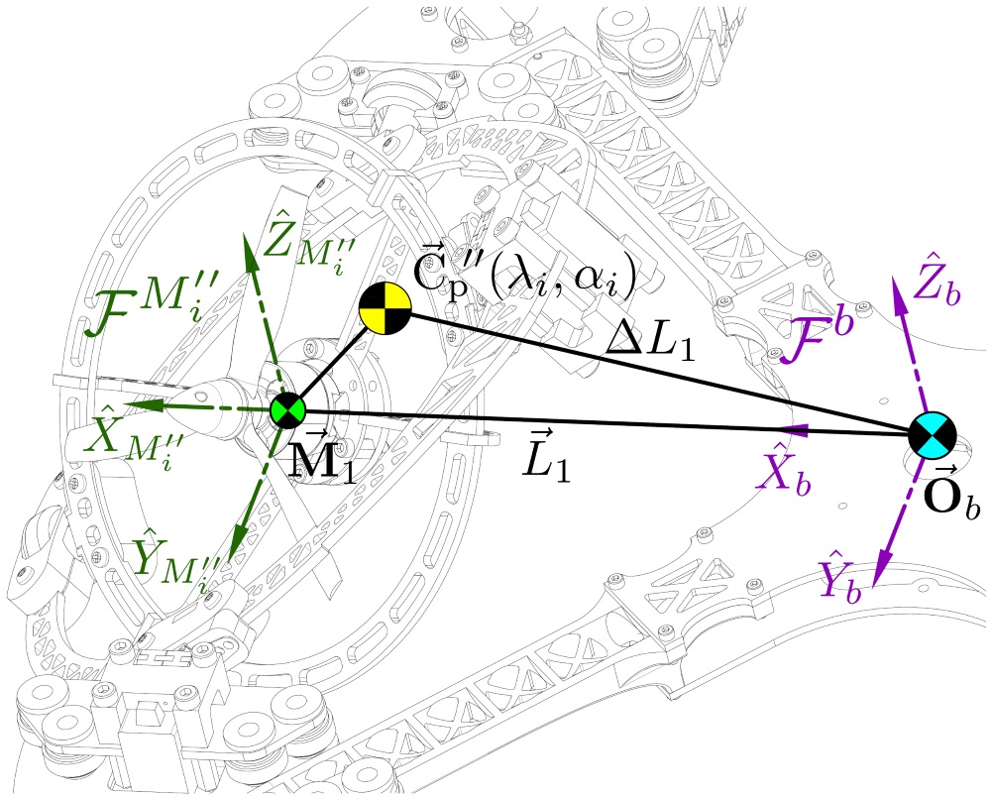
figs/vector-diff.jpg
