nickvonklemp/Masters-Report/graphs/ABC_Position_Trajectory.png

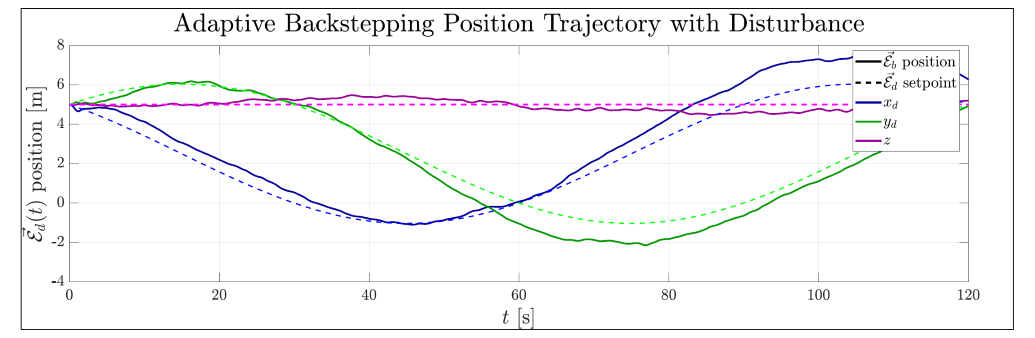
graphs/ABC_Position_Trajectory.png
