nickvonklemp/Masters-Report/graphs/ABC_Trajectory.png

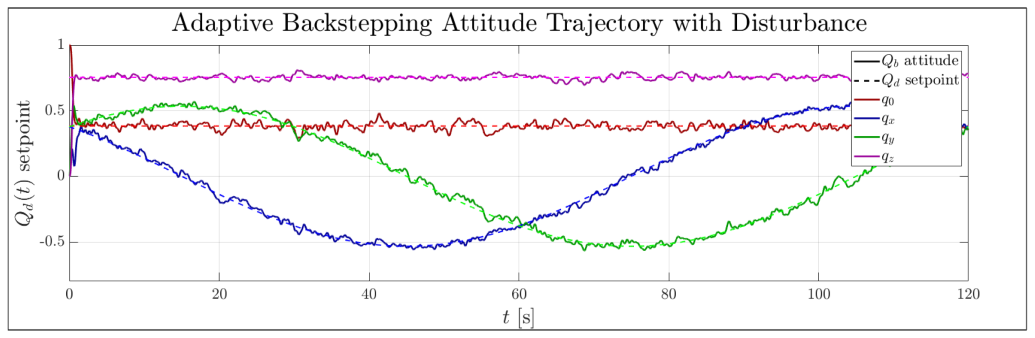
graphs/ABC_Trajectory.png
