nickvonklemp/Masters-Report/graphs/body_norm_attitude.png

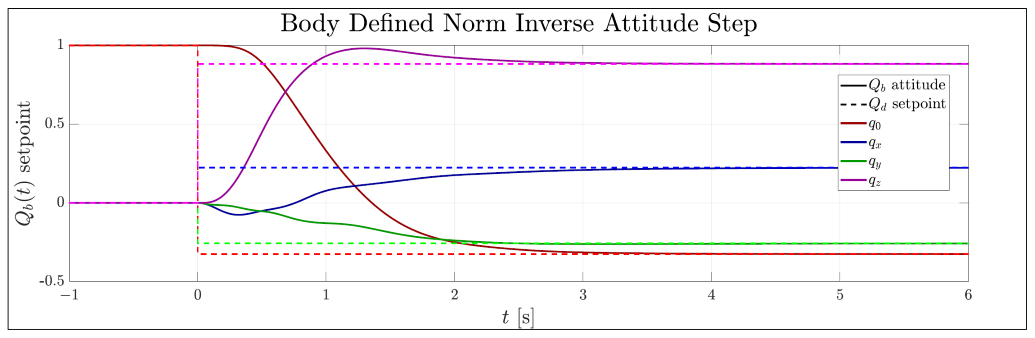
graphs/body_norm_attitude.png
