nickvonklemp/Masters-Report/graphs/body_norm_Input.png

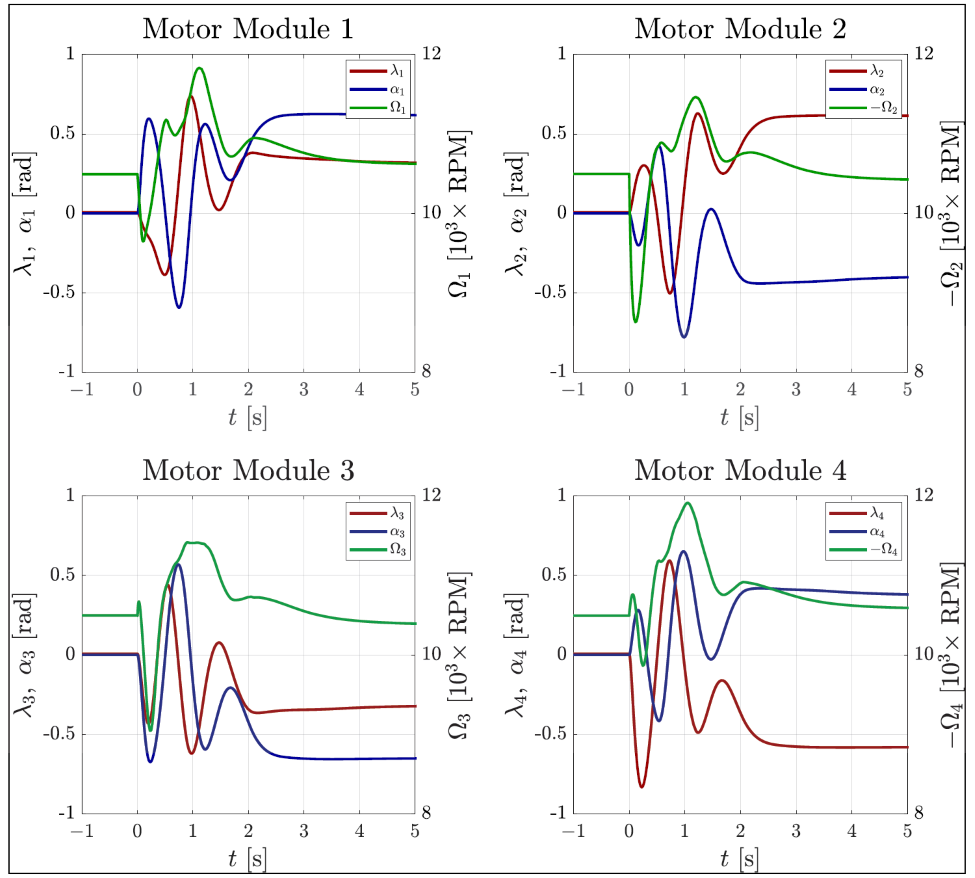
graphs/body_norm_Input.png
