nickvonklemp/Masters-Report/graphs/body_norm_position.png

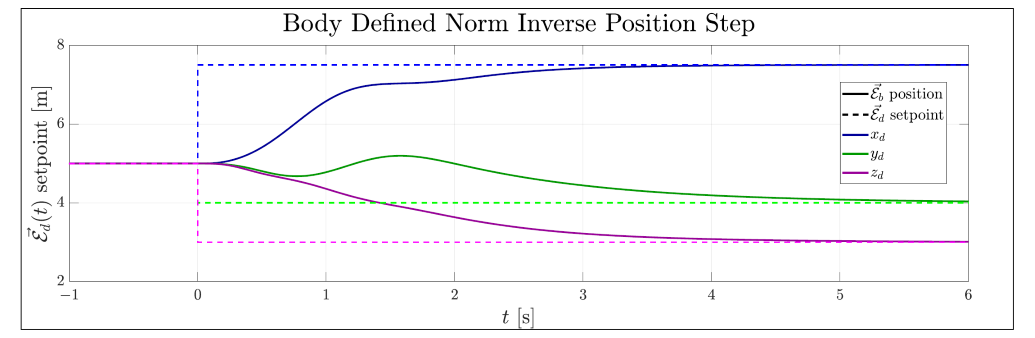
graphs/body_norm_position.png
