nickvonklemp/Masters-Report/graphs/force-observer.png

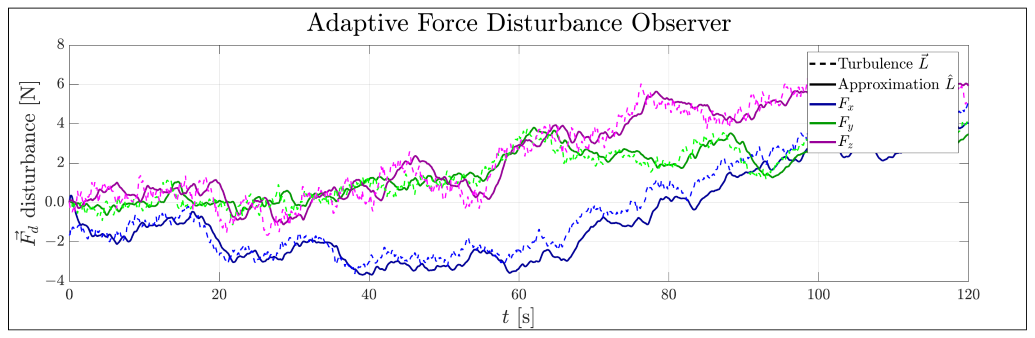
graphs/force-observer.png
