nickvonklemp/Masters-Report/graphs/IBC_Angular.png

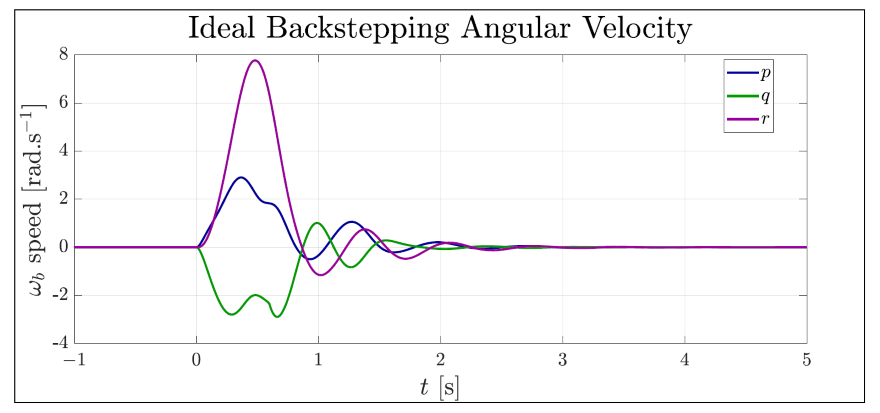
graphs/IBC_Angular.png
