nickvonklemp/Masters-Report/graphs/IBC_Error.png

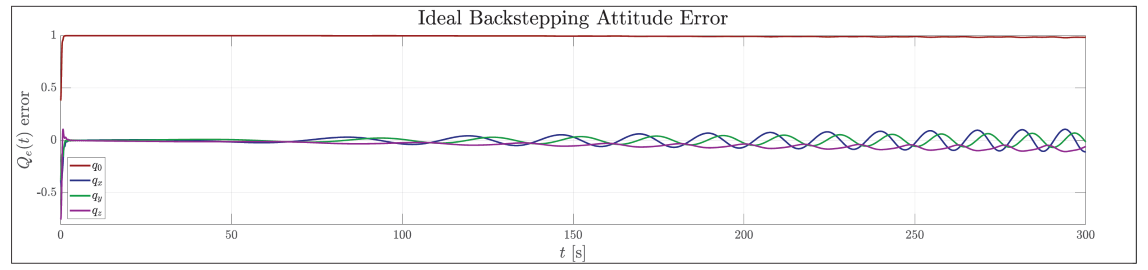
graphs/IBC_Error.png
