nickvonklemp/Masters-Report/graphs/IBC_Input.png

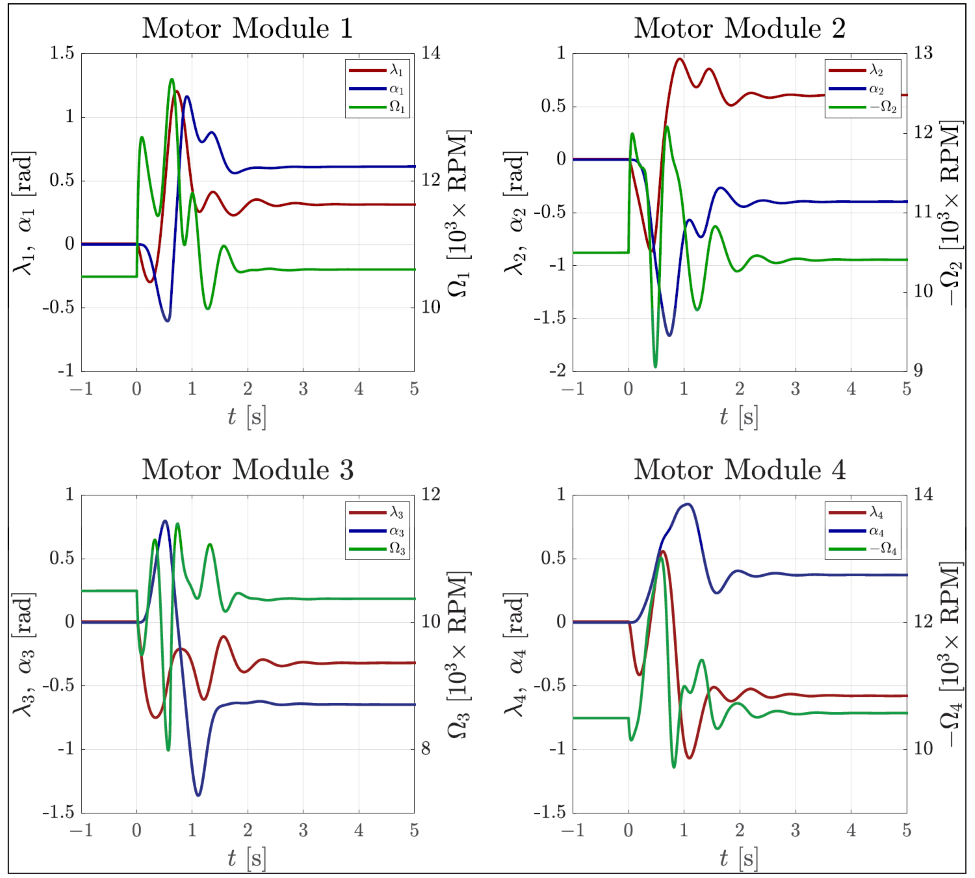
graphs/IBC_Input.png
