nickvonklemp/Masters-Report/graphs/IBC_Position_Error.png

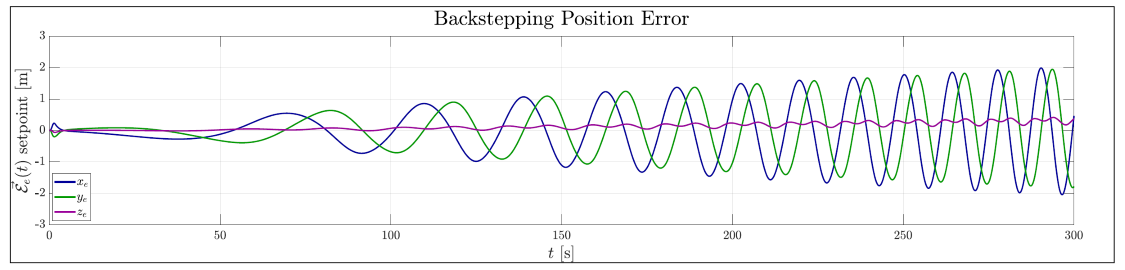
graphs/IBC_Position_Error.png
