nickvonklemp/Masters-Report/graphs/IBC_Position_Force.png

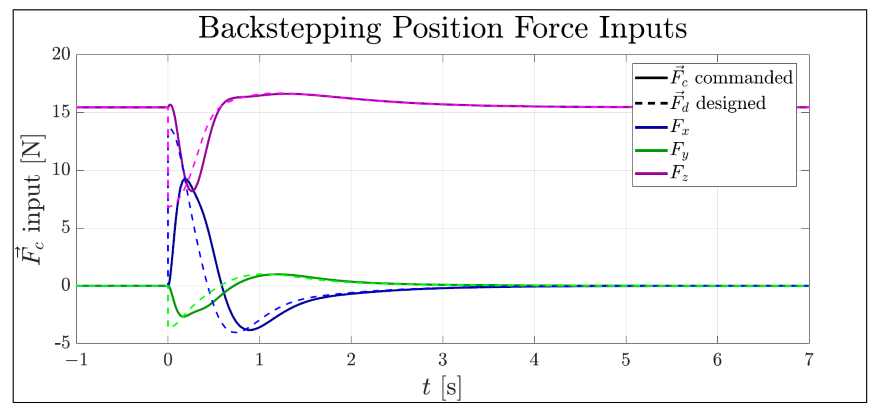
graphs/IBC_Position_Force.png
