nickvonklemp/Masters-Report/graphs/IBC_Position_Input.png

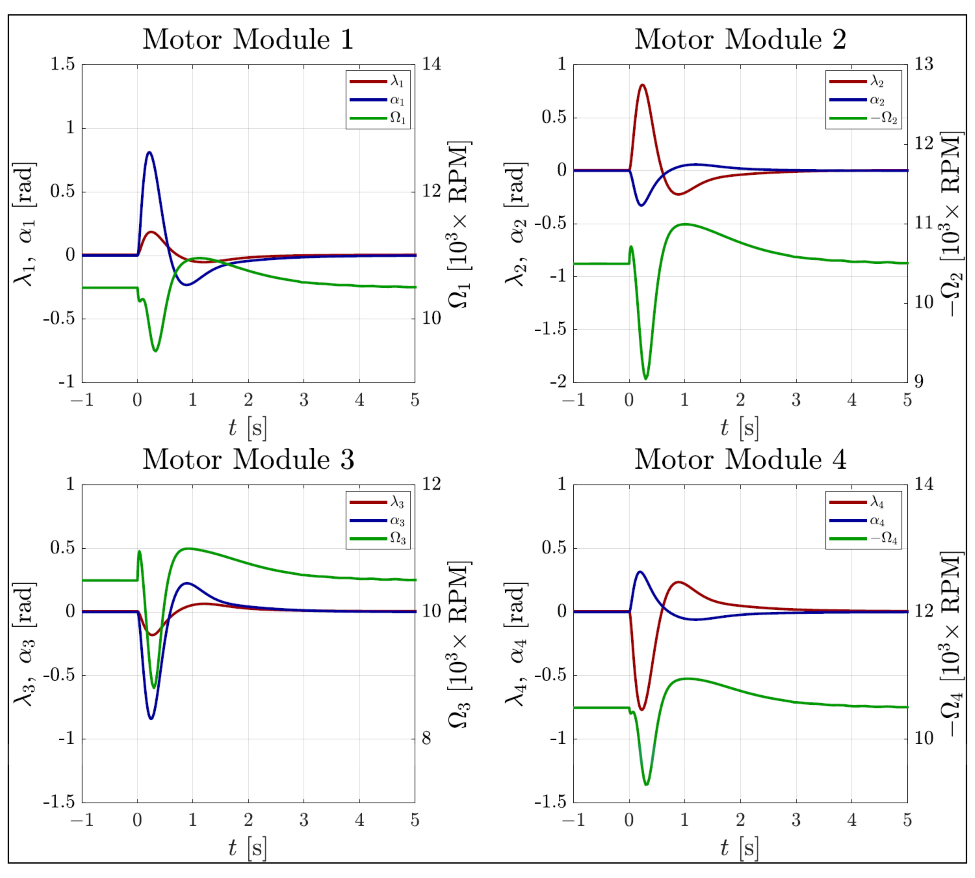
graphs/IBC_Position_Input.png
