nickvonklemp/Masters-Report/graphs/IBC_Position_Trajectory.png

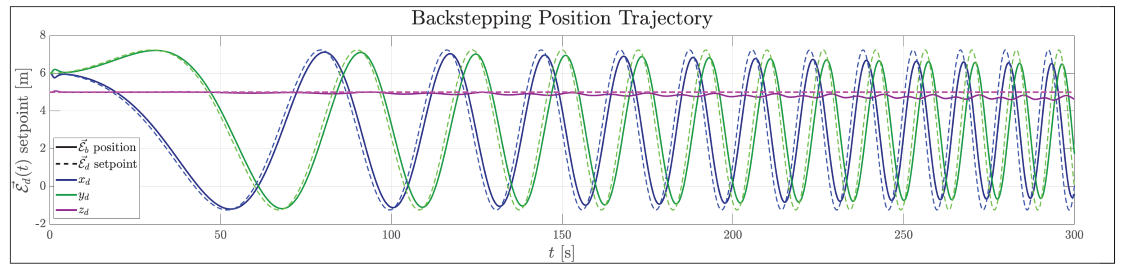
graphs/IBC_Position_Trajectory.png
