nickvonklemp/Masters-Report/graphs/IBC_Position_Velocity.png

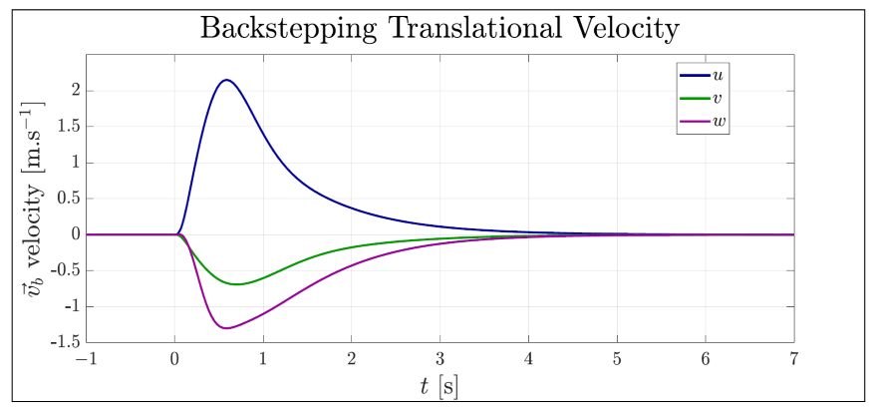
graphs/IBC_Position_Velocity.png
