nickvonklemp/Masters-Report/graphs/IBC_Torque.png

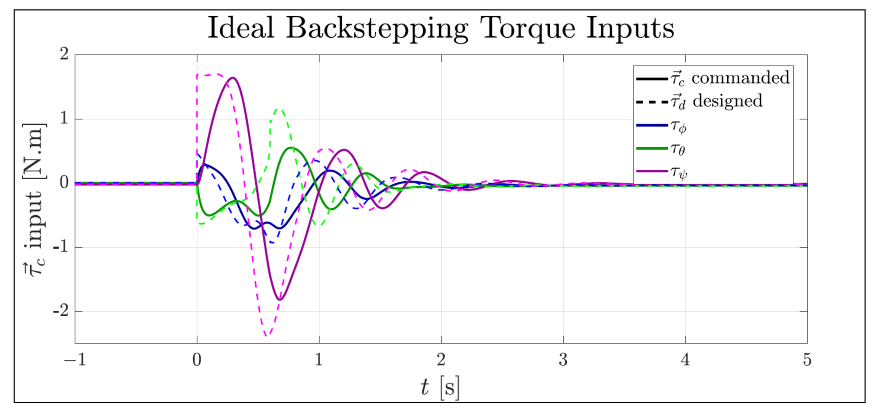
graphs/IBC_Torque.png
