nickvonklemp/Masters-Report/graphs/IBC_Trajectory.png

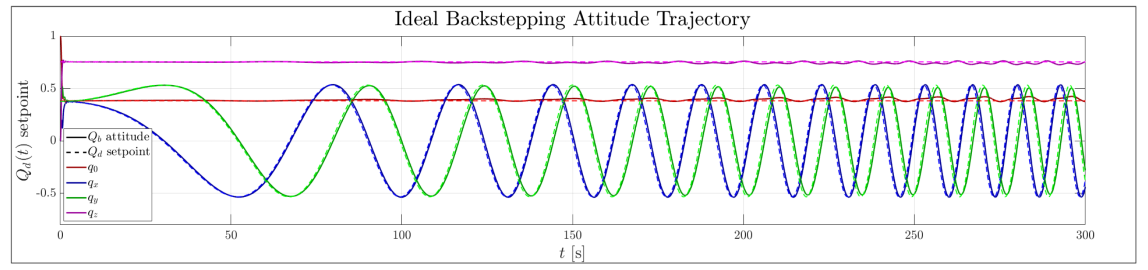
graphs/IBC_Trajectory.png
