nickvonklemp/Masters-Report/graphs/IBC_Trajectory_dist.jpg

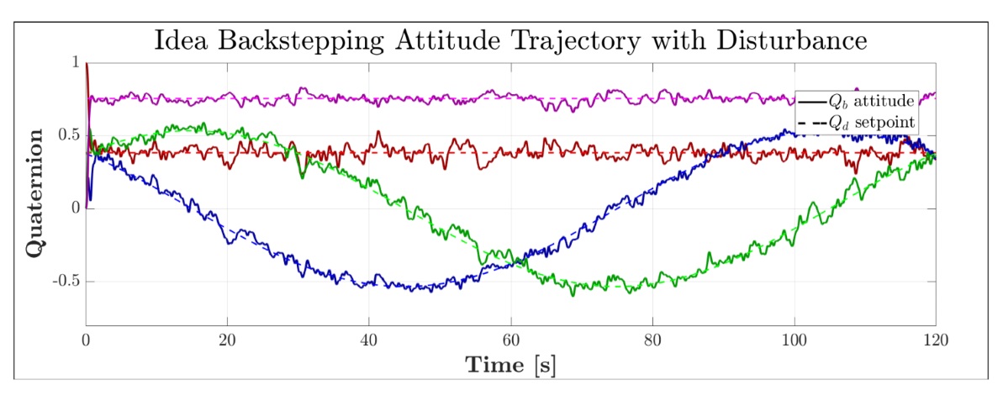
graphs/IBC_Trajectory_dist.jpg
