nickvonklemp/Masters-Report/graphs/inertial_norm_position.png

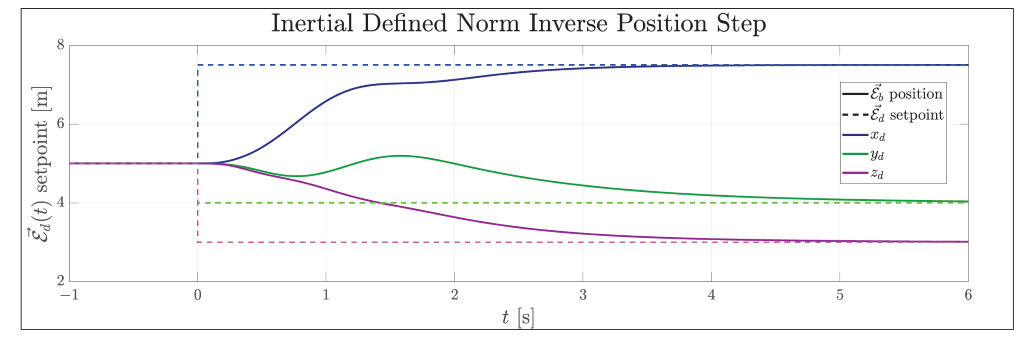
graphs/inertial_norm_position.png
