nickvonklemp/Masters-Report/graphs/PD_3x3_Dependent_Angular.png

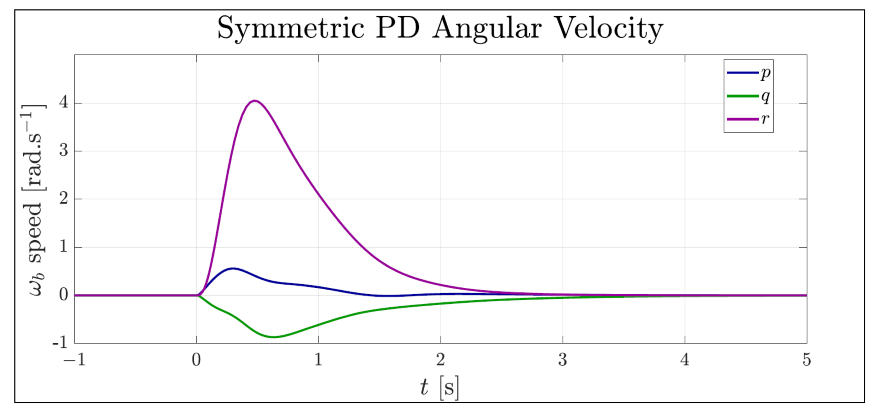
graphs/PD_3x3_Dependent_Angular.png
