nickvonklemp/Masters-Report/graphs/PD_3x3_Dependent_Input.png

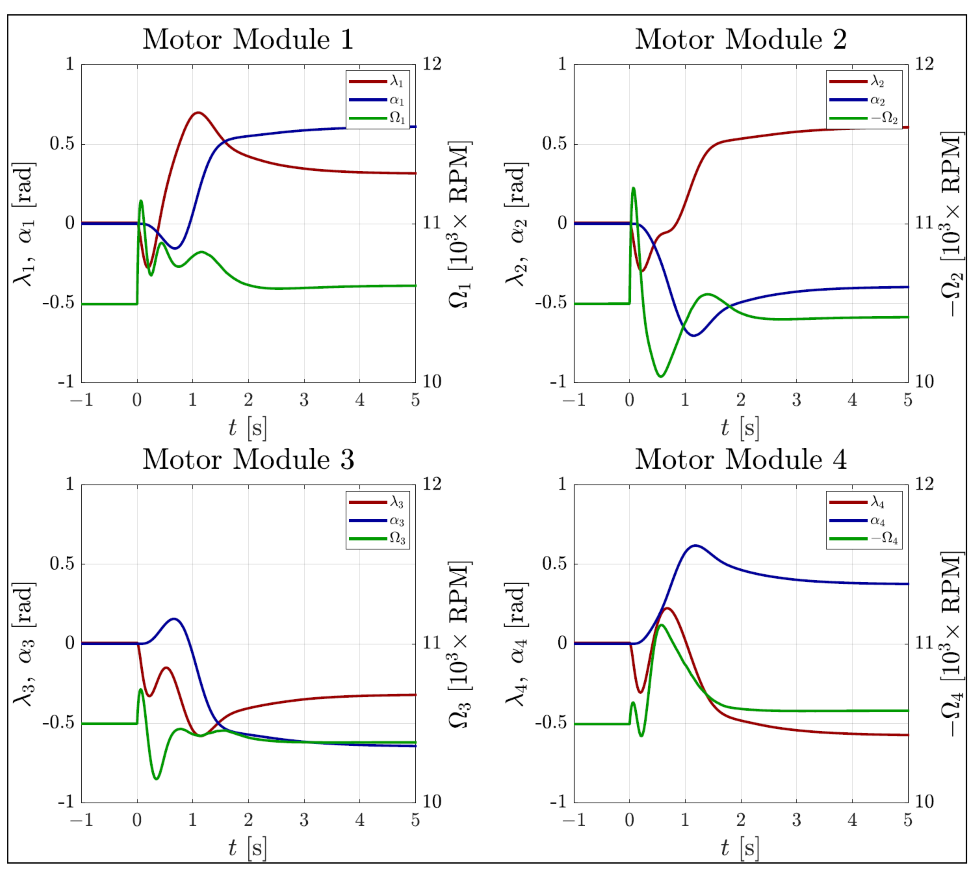
graphs/PD_3x3_Dependent_Input.png
