nickvonklemp/Masters-Report/graphs/PD_3x3_Dependent_Torque.png

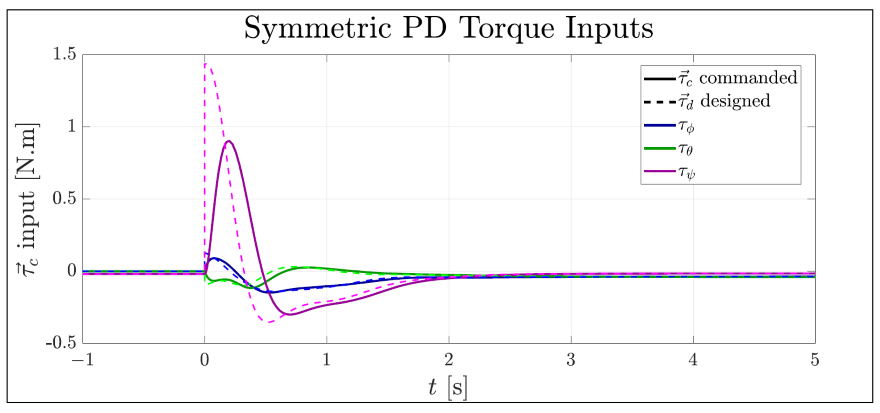
graphs/PD_3x3_Dependent_Torque.png
