nickvonklemp/Masters-Report/graphs/PD_Diagonal_Dependent_Angular.png

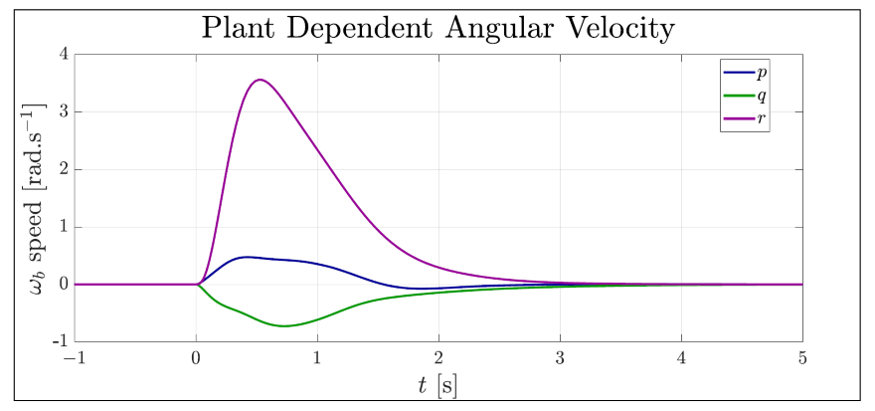
graphs/PD_Diagonal_Dependent_Angular.png
