nickvonklemp/Masters-Report/graphs/PD_Diagonal_Dependent_Error.png

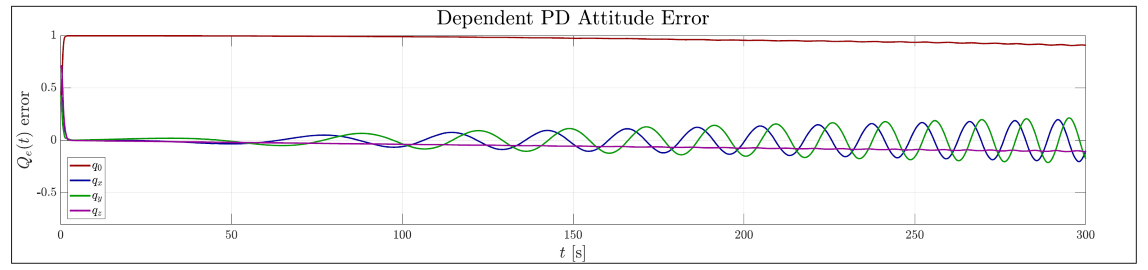
graphs/PD_Diagonal_Dependent_Error.png
