nickvonklemp/Masters-Report/graphs/PD_Diagonal_Dependent_Input.png

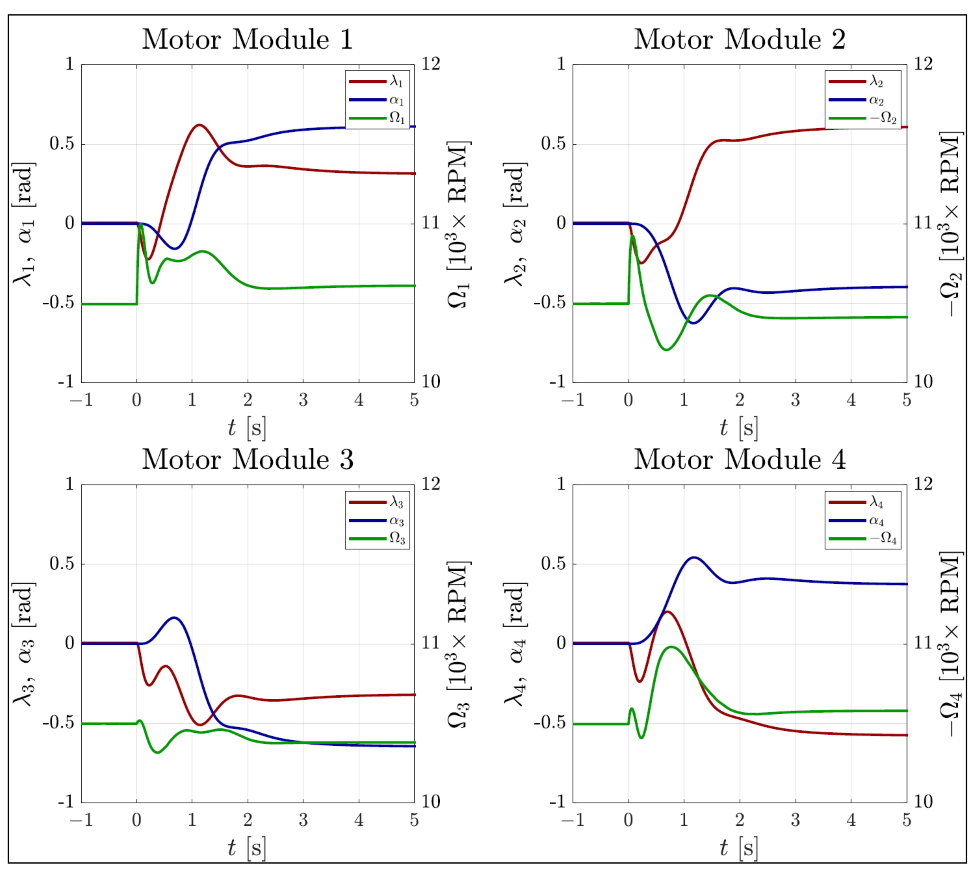
graphs/PD_Diagonal_Dependent_Input.png
