nickvonklemp/Masters-Report/graphs/PD_Diagonal_Dependent_Torque.png

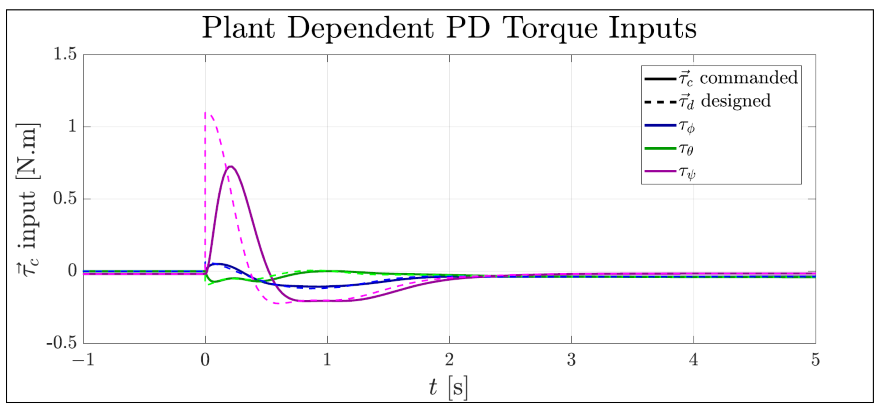
graphs/PD_Diagonal_Dependent_Torque.png
