nickvonklemp/Masters-Report/graphs/PD_Diagonal_Dependent_Trajectory.png

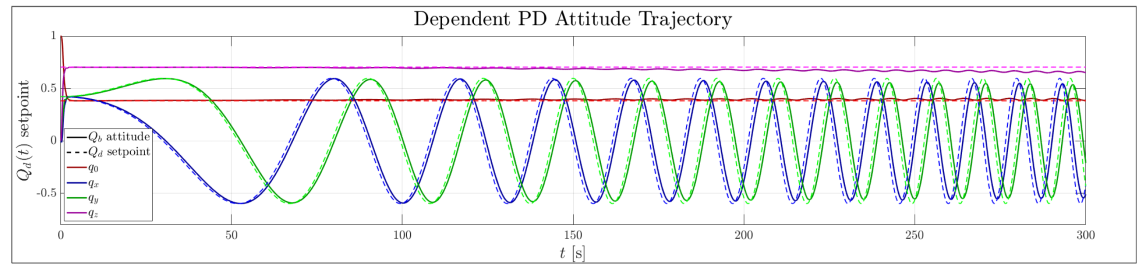
graphs/PD_Diagonal_Dependent_Trajectory.png
