nickvonklemp/Masters-Report/graphs/PD_Diagonal_Gain_Input.png

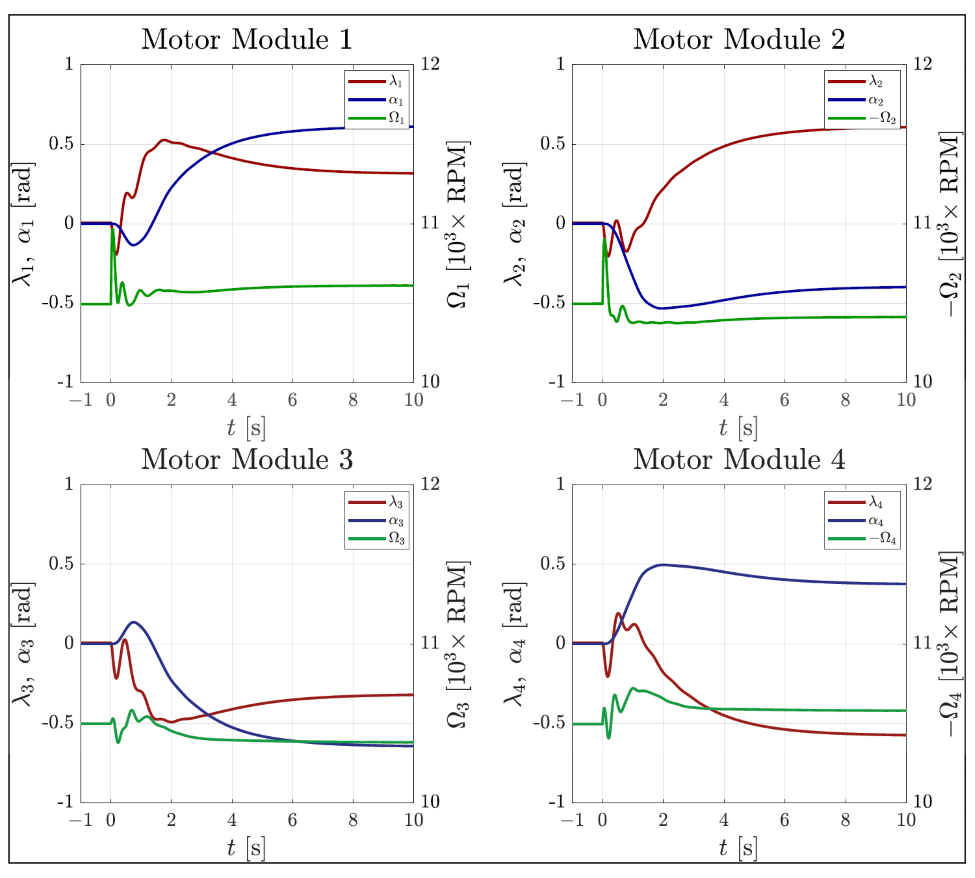
graphs/PD_Diagonal_Gain_Input.png
