nickvonklemp/Masters-Report/graphs/PD_Diagonal_Independent_Angular.png

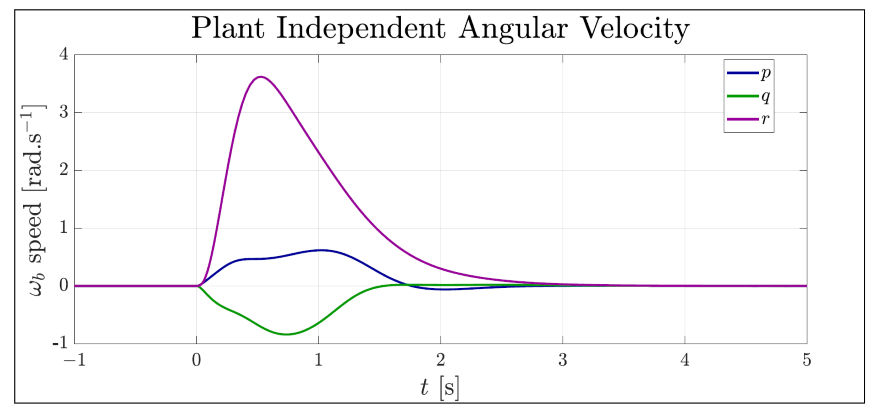
graphs/PD_Diagonal_Independent_Angular.png
