nickvonklemp/Masters-Report/graphs/PD_Diagonal_Independent_Error.png

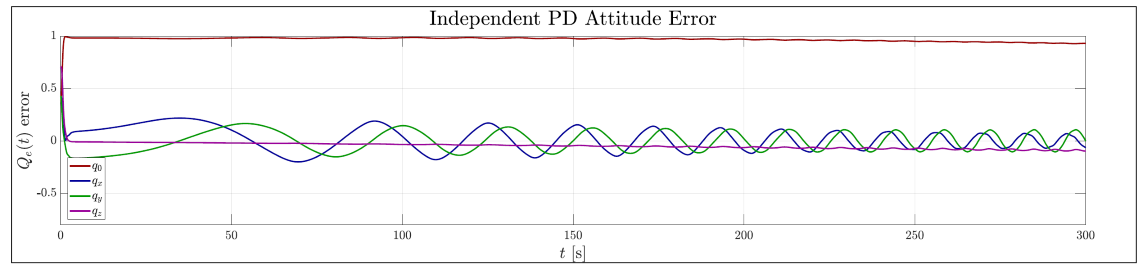
graphs/PD_Diagonal_Independent_Error.png
