nickvonklemp/Masters-Report/graphs/PD_Diagonal_Independent_Input.png

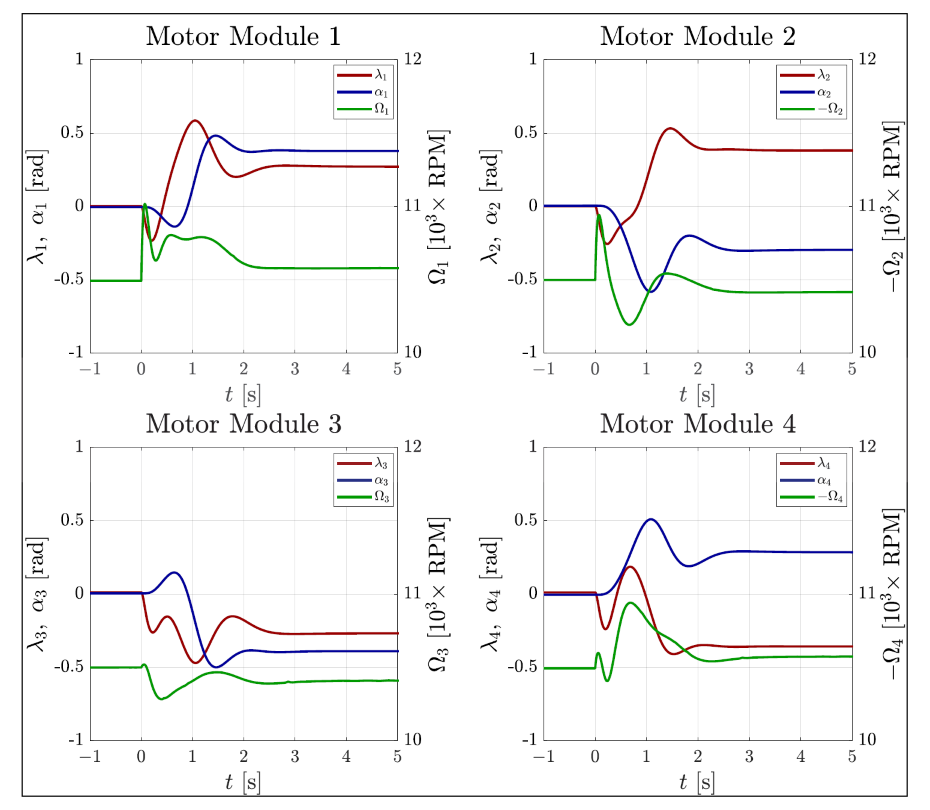
graphs/PD_Diagonal_Independent_Input.png
