nickvonklemp/Masters-Report/graphs/PD_Diagonal_Independent_Trajectory.png

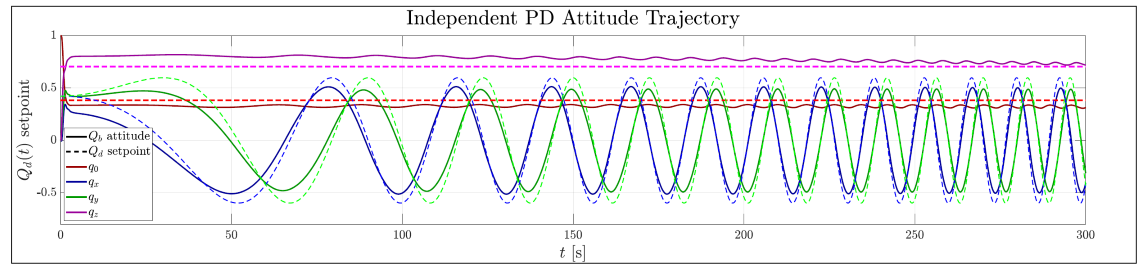
graphs/PD_Diagonal_Independent_Trajectory.png
