nickvonklemp/Masters-Report/graphs/PD_Position_Force.png

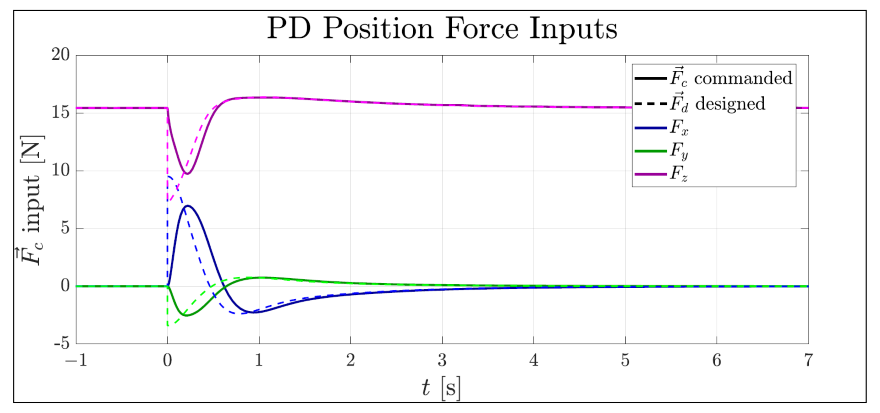
graphs/PD_Position_Force.png
