nickvonklemp/Masters-Report/graphs/PD_Position_Gain_Input.png

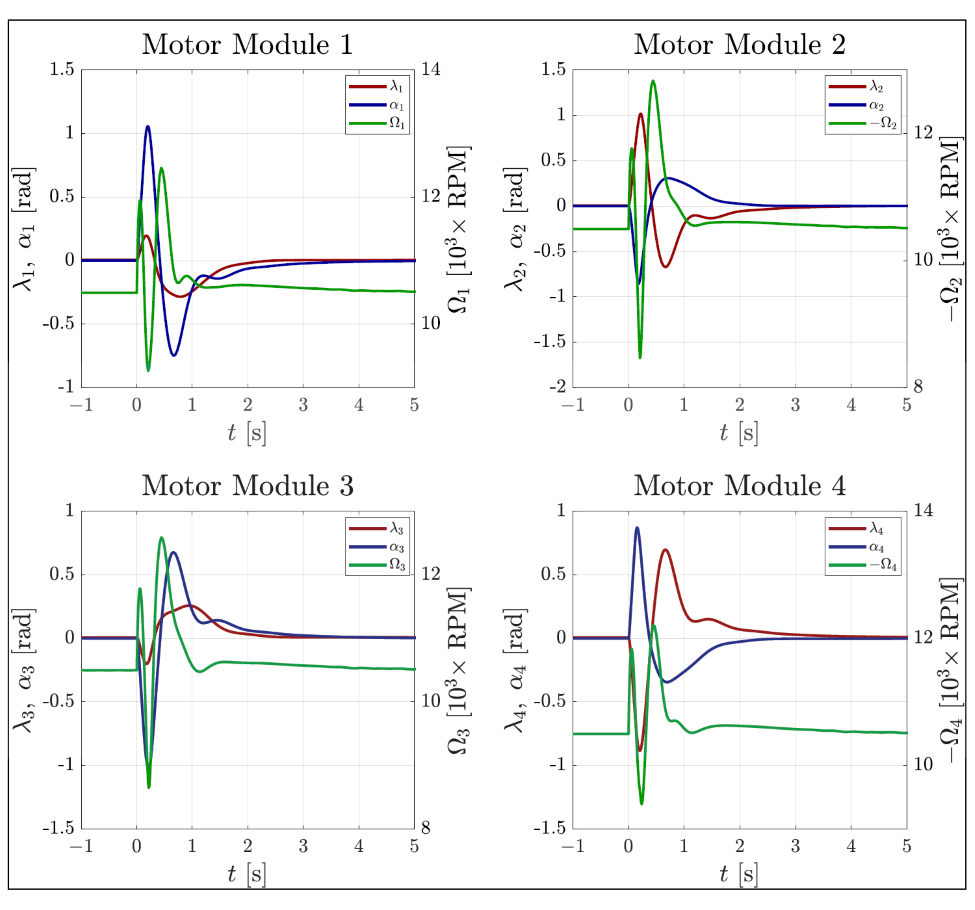
graphs/PD_Position_Gain_Input.png
