nickvonklemp/Masters-Report/graphs/PD_Position_Input.png

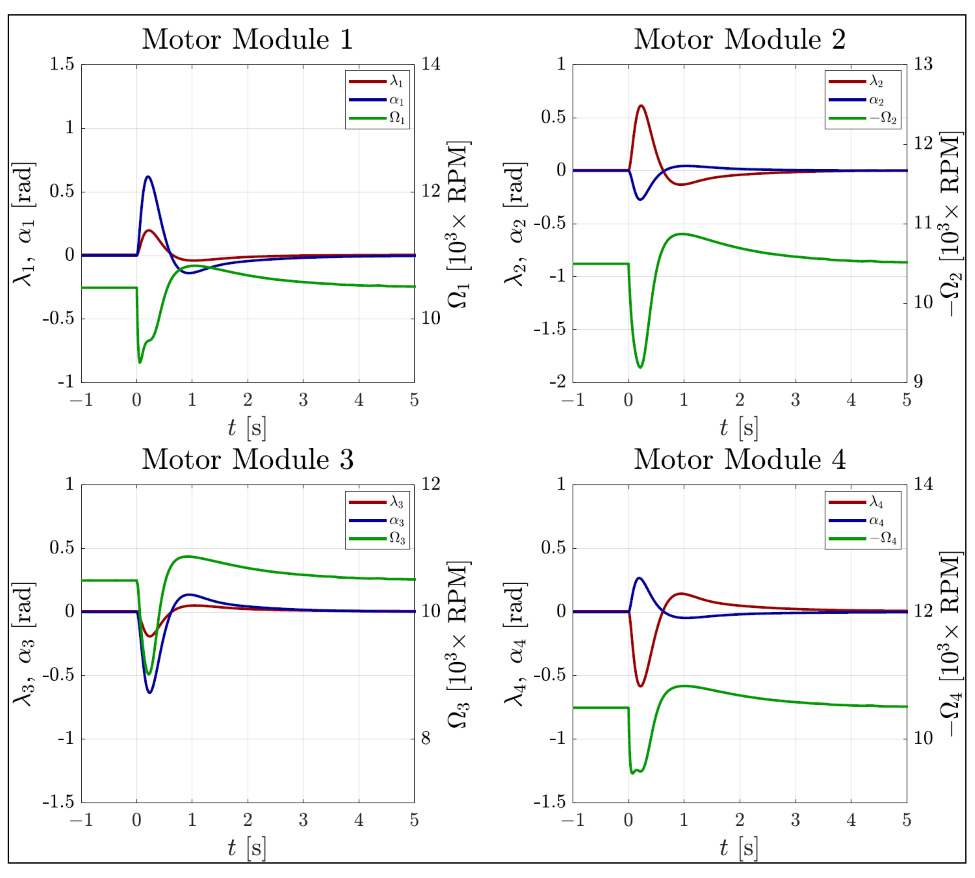
graphs/PD_Position_Input.png
