nickvonklemp/Masters-Report/graphs/PD_Position_Velocity.png

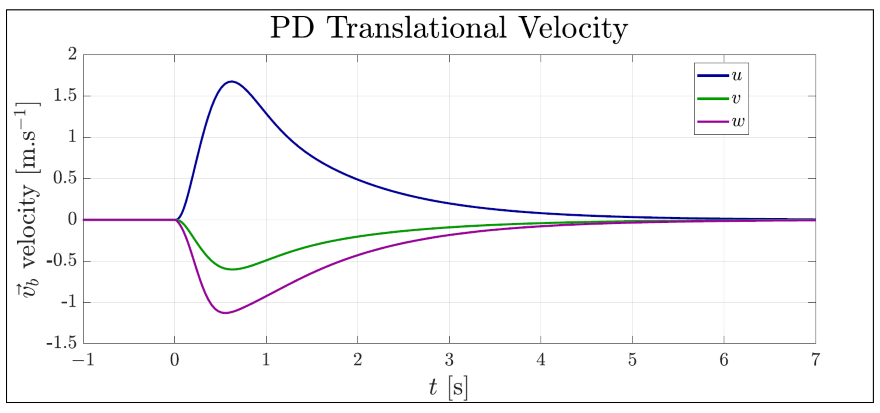
graphs/PD_Position_Velocity.png
