nickvonklemp/Masters-Report/graphs/propeller_differential.jpg

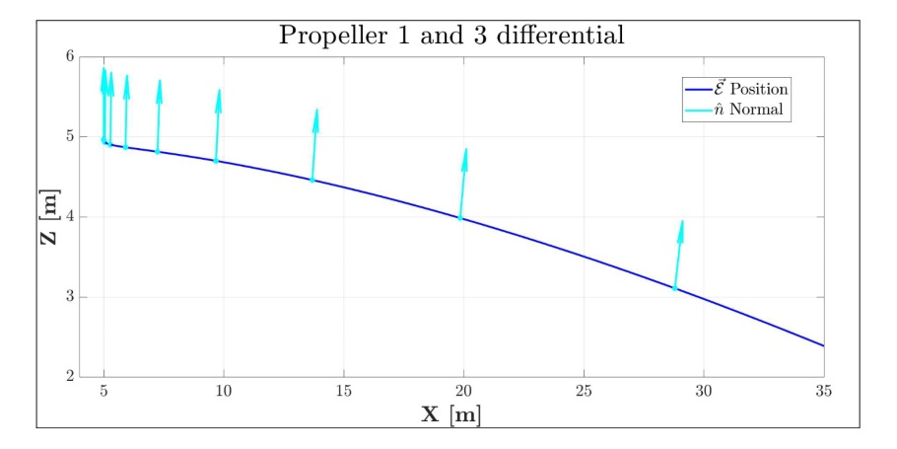
graphs/propeller_differential.jpg
