nickvonklemp/Masters-Report/graphs/pseudo_inverse_attitude.png

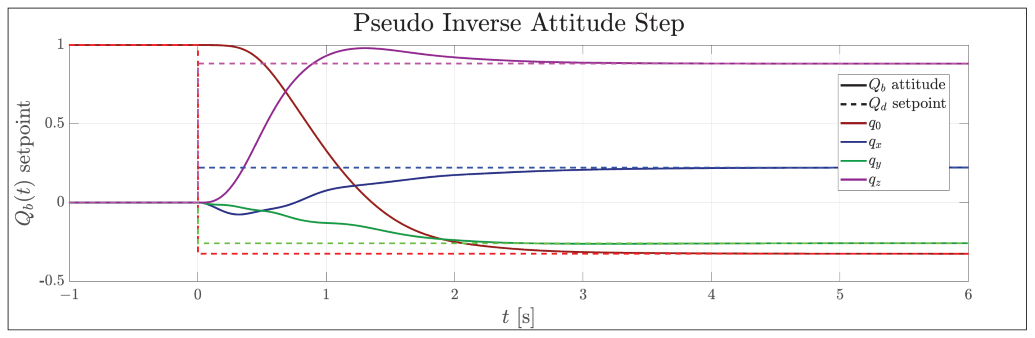
graphs/pseudo_inverse_attitude.png
