nickvonklemp/Masters-Report/graphs/saturated-servos.jpg

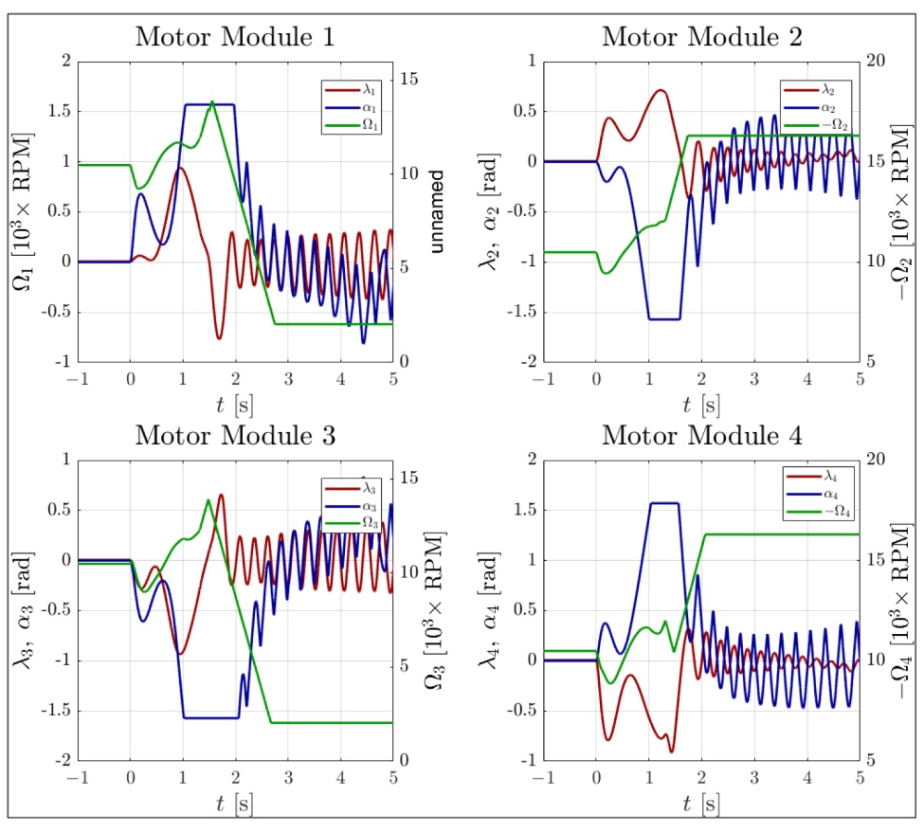
graphs/saturated-servos.jpg
