nickvonklemp/Masters-Report/graphs/spin_position.jpg

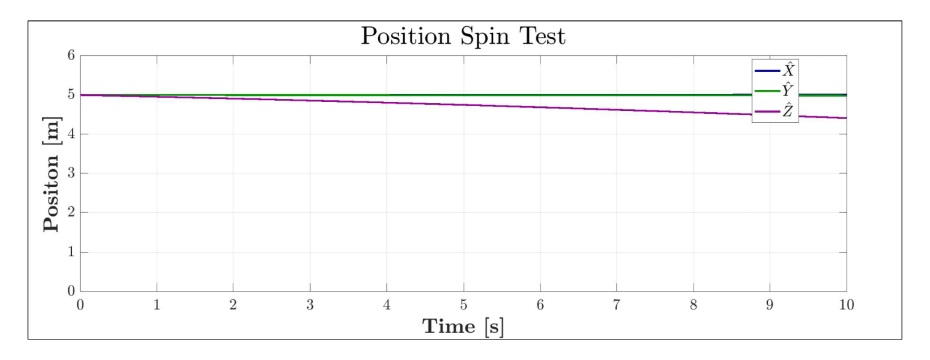
graphs/spin_position.jpg
