nickvonklemp/Masters-Report/graphs/spin_quaternion.jpg

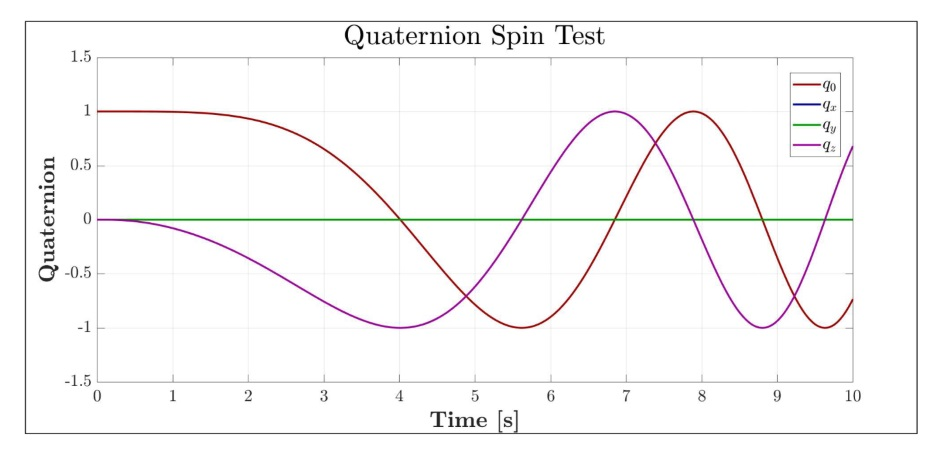
graphs/spin_quaternion.jpg
