nickvonklemp/Masters-Report/graphs/tau-alph-lam-r.jpg

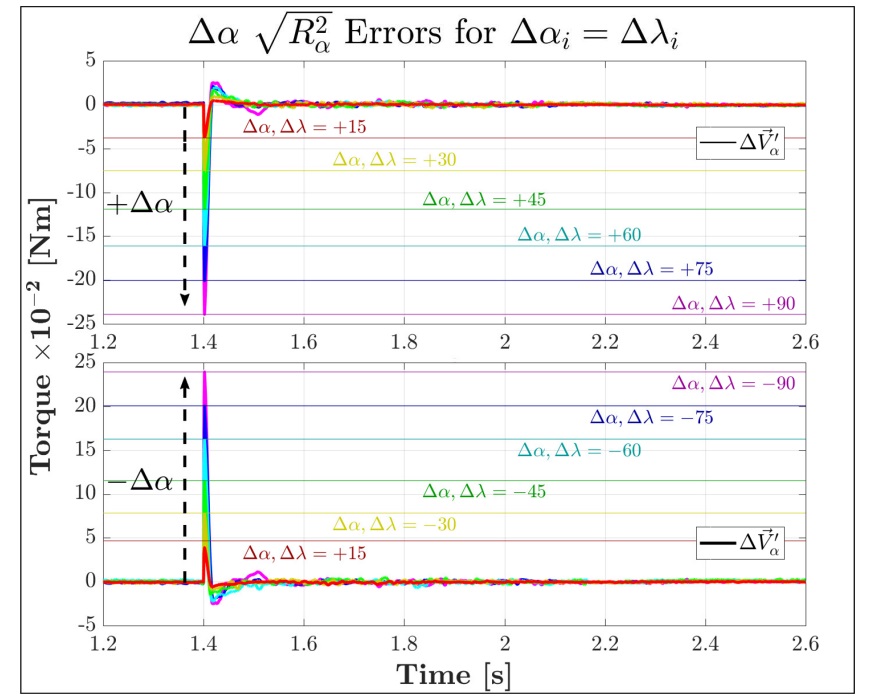
graphs/tau-alph-lam-r.jpg
