nickvonklemp/Masters-Report/graphs/tau-alph-lam.jpg

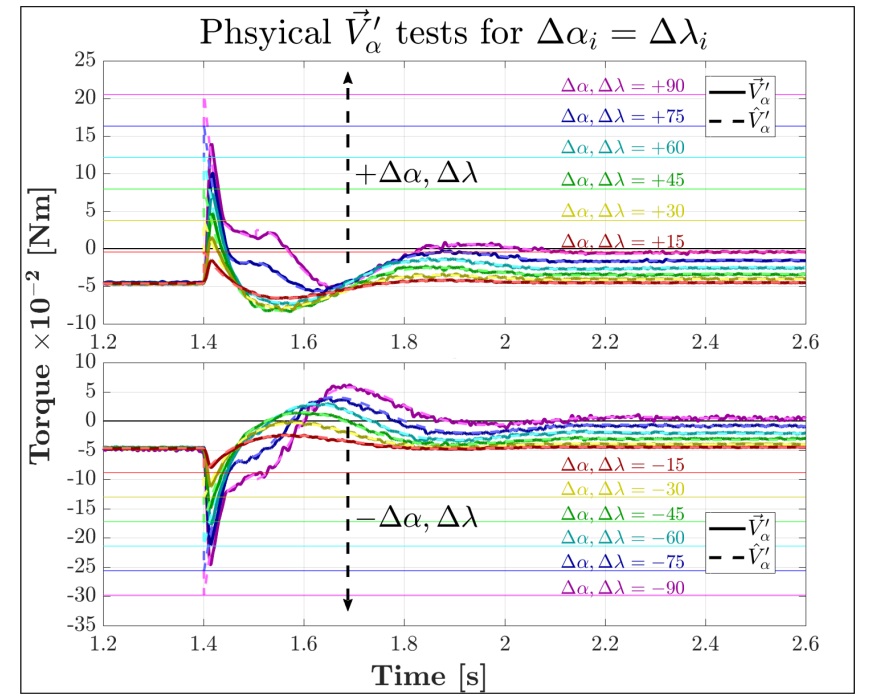
graphs/tau-alph-lam.jpg
