nickvonklemp/Masters-Report/graphs/tau-alpha-r.jpg

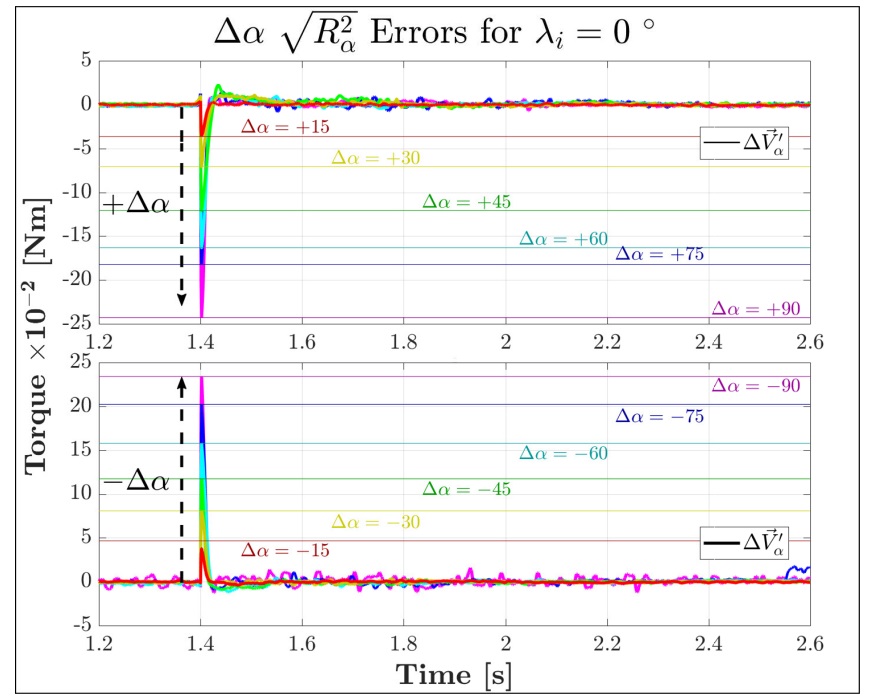
graphs/tau-alpha-r.jpg
