nickvonklemp/Masters-Report/graphs/tau-alpha.jpg

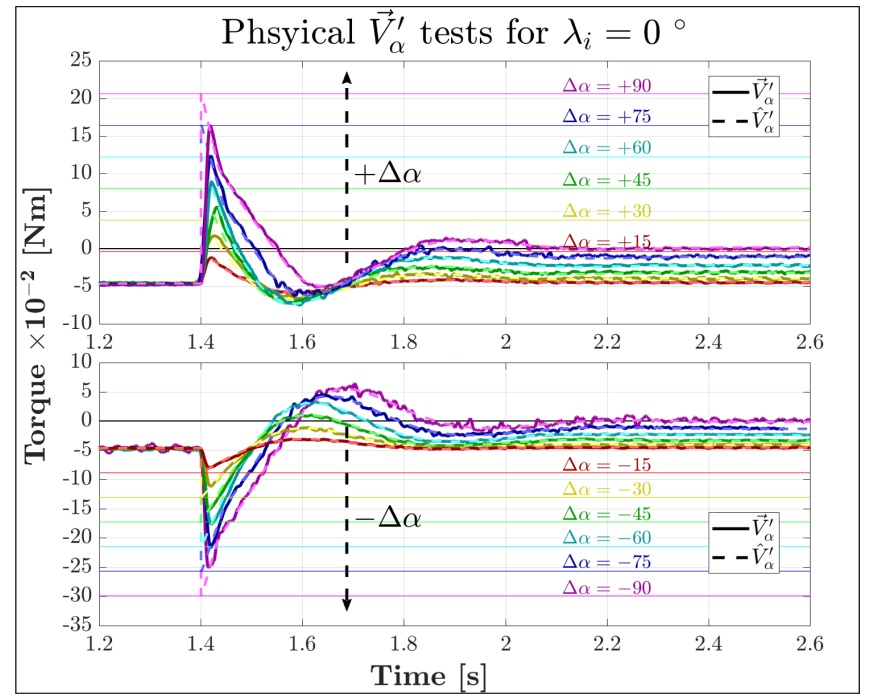
graphs/tau-alpha.jpg
