nickvonklemp/Masters-Report/graphs/tau-lambda-r.jpg

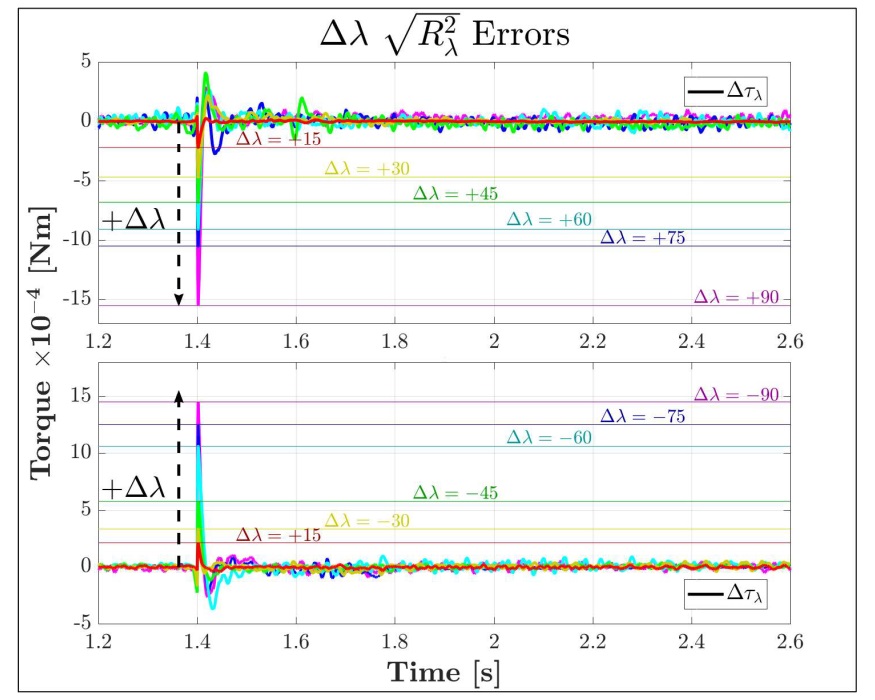
graphs/tau-lambda-r.jpg
