nickvonklemp/Masters-Report/graphs/torque-observer.jpg

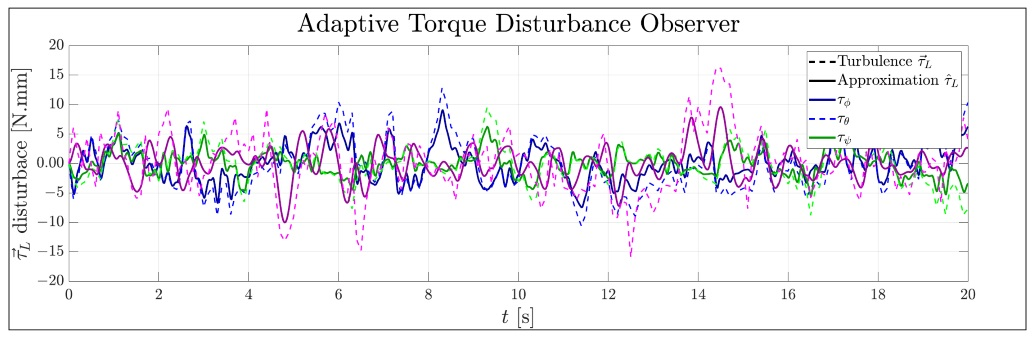
graphs/torque-observer.jpg
