nickvonklemp/Masters-Report/graphs/unsaturated-servos.png

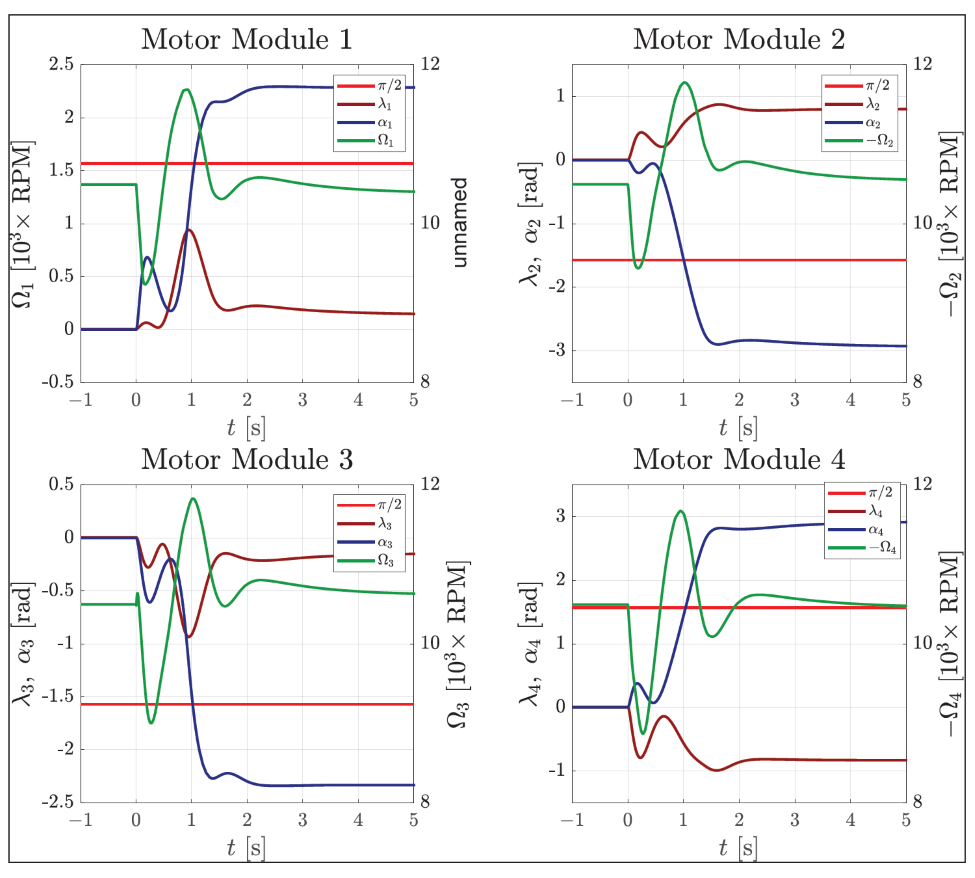
graphs/unsaturated-servos.png
