nickvonklemp/Masters-Report/graphs/upward_acceleration.jpg

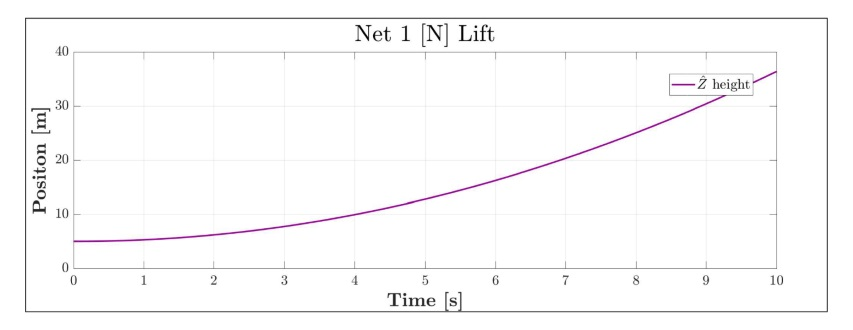
graphs/upward_acceleration.jpg
