nickvonklemp/Masters-Report/graphs/XPD_Angular.png

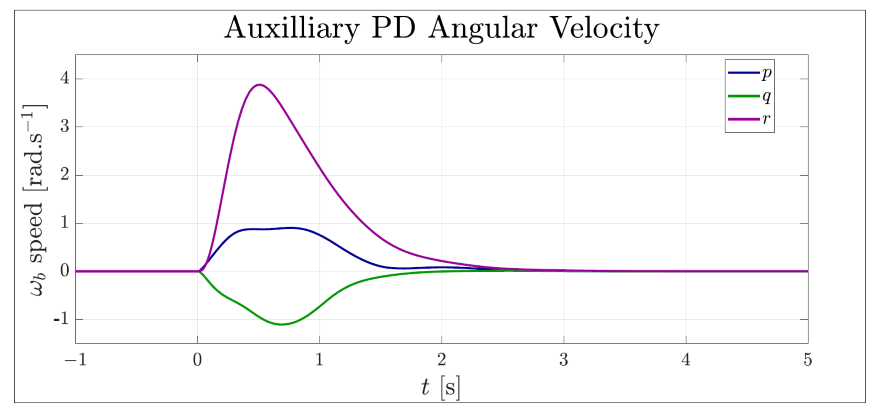
graphs/XPD_Angular.png
