nickvonklemp/Masters-Report/graphs/XPD_Torque.png

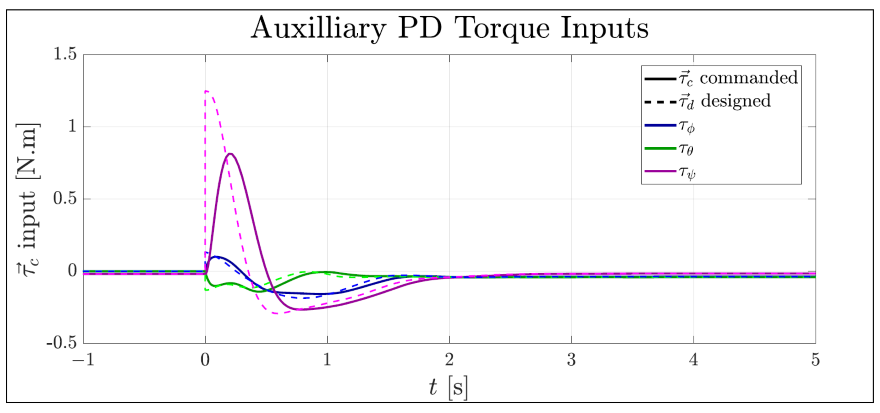
graphs/XPD_Torque.png
