nickvonklemp/Masters-Report/nomenclature and symbols.docx

# Nomenclature

- UAV: unmanned aerial vehicle, any autonomous aircraft
- 6-DOF: six degrees of freedom, full attitude and position states
- 4-DOF: four degrees of freedom, reduced attitude control
- SISO: single-input single-output typical control loop, mostly in frequency domain
- MEMs: Micro-electromechanical systems; accelerometers, gyroscopes and the like
- DIY: Do-it-yourself, in context example hobbyking SK450 kit
- VTOL: vertical take-off/landing aircraft. E.g: helicopter, osprey, quadrotor, bi-rotor
- 3-D: three dimensional vector with components in cartesian X-Y-Z axial directions
- MPC: model predictive control
- QFT: quantative feedback technology
- IMU: inertial measurement unit, either 6-DOF acc/gyro or 9-DOF acc/gyro/mag
- RPM: revolution per minute, typical units for propeller rotational velocity
- BLDC: Brushhless-DC motor, actually 3-phase with ESC operates like DC motor
- KV: Thousand RPM per V applied, rating unit for BLDC motor
- OAT: opposed active tilting, single axis rotation on bi-rotor
- dOAT: dual axis opposed active tilting
- PD: Controller structure proportional to error and error derivative
- PID: Proportional to error, error integral and error derivative
- PSO: Particle swarm optimization, gradient free optimization method
- ITAE: Integral-time absolute error, cost function used to evaluate setpoint tracking
- BEM: Blade-Element momentum theory, calculation of applied thrust from propeller
- FTC: Fault tolerant control (typically compensates for uncertainty/disturbances and incorporates redudency)
- LQR: linear quadratic regulator, control structure
- CMG: control moment gyroscope, satellite actuator
- GCS: ground control station, supplements onboard control loops for UAVs
- USART: Universal synchronous/asynchronous receiver transmitter, 2 wire comms standard
- CH: channel, number of PWM lines or RC channels
- PWM: pulse width modulation
- S.Bus: Serial.Bus, proprietary encoding of UART comms
- RX: receiver channel, comms line input
- TX: transmit channel, comms line output
- ESC: electronic speed controller, switches DC to 3-phase AC for BLDC motors speed control
- MCu: microcontroller
- STP: standard temperature and pressure
- LFC: Lyapunov function candidate

# Symbols

- ϕ pitch rotation about X axis, rad
- θ roll rotation about Y axis, rad
- ψ yaw rotation about Z axis, rad
- η=[ϕ, θ, ψ]∈F^(I,v_1 ,v_2) Euler angle set
- η_b ∈F^b transformed Euler angles in common shared body frame
- Q_b =[q_0 , q] attitude quaternion with scalar q_0 and vector q components
- ω_b =[p, q, r]∈F^b angular velocity in body frame, rad/s
- x translational position in the X axis direction
- y translational position in the Y axis direction
- z translational height in the Z axis direction
- E_I =[x, y, z]∈F^I inertial position, m
- v_b =[u, v, w]∈F^b translational velocity in body frame, m/s
- x_b full 6-DOF state for combined attitude and position
- x_d desired state setpoint
- x_e error state, not necessarily subtractive, quaternion errors are multiplicative
- Ω_i rotational velocity of ith propeller, units RPM or RPS specified
- T(Ω_i ) scalar propeller thrust as a function or rotational speed, from EQ:, N
- u actuator plant input matrix, consists of rotational positions for extra actuation servos and each motor module’s propeller speed, in R12
- λ_i motor module rotation about X axis, rad
- α_i motor module rotation about Y axis, rad
- τ_μ =[τ_ϕ , τ_θ , τ_ψ ]∈F^b input torque, Nm
- τ_d =h(η_e ,η_e ,t)∈F^b attitude controller designed torque input, Nm
- F_μ =[F_x , F_y , F_z ]∈F^b input force, N
- F_d =g(E_e ,E_e ,t)∈F^b position controller designed force input, N
- ν_d =[F_d t_u ]= H(x_e ,x_e ,t)∈F^b generalized virtual control input
- J_x body x rotational inertia in Kgm^2, relative frame in context
- m_b vehicle mass, Kg
- u=[Ω_1 , …, α_4 ]^T ∈U^12 actuator matrix
- O_b body frame origin
- M_i motor module center of rotation
- L_i vector arm length from O_b origin, m
- C_x body x center of mass
- m_x body x mass
- r for rotor body
- n for inner ring assembly
- m for middle ring assembly
- p for net motor module
- y for constant body frame
- L_x Lagrangian scalar with respect to body x
- T Kinetic energy
- U Potential energy
- r(t) generalized path trajectory for Euler-Lagrange
- ξ generalized position coordinate
- H generalized attitude coordinate
- ρ stp air desnity
- c propeller chord length
- D propeller diameter
- J aerodynamic advance ratio, inflow velocity relative to propeller’s rotational speed
- C_T (J) aerodynamic thust coefficient, varies as a function of the advance ratio
- C_P (J) aerodynamic power coefficient, varies as a function of the advance ratio
- D(v_b ) aerodynamic drag as a function of the vehicles translational velocity
- b for net multi-body assembly
- Underline implies vector quantity (column vector)
- \mu subscript denotes control inputs
- Subscripts 1-4 refer to quanities associated with each motor module
- Hat accent an axis quantity
- Lower case axis quanitities are unit vectors in the axial direction
- Upper case axiis quanitites refer to the axis itself
- Bold faced vectors are lumped state variables
- Dot accents denote derivates
- M_i subscripts imply reference to the i^th motor module’s frame
- F^i refers to the ith reference frame
- Vec{O}_i refers to the origin of motion used for the Ith frame
- Lowercase bold vectors imply state trajectories
- Uppercase bold vectors represent Euler-Lagrange generalized forces acting as a result of the same cases’ lowercase trajectory

Where possible, typical convention for quanitites and notation has been adhered to.
