nickvonklemp/Masters-Report/(list of files, cad)

Other CAD files:
Resources/CAD/Motor Layouts/ISO Motor Module Assembly.DWG
Resources/CAD/Design/Frame.DWG
Resources/CAD/Motor Layouts/Top View.DWG
Resources/CAD/Reference Frames.dwg
Resources/CAD/Reference Frames/Reference Frames.dwg
Resources/CAD/Motor Layouts/Motor Module Top View.DWG
