nickvonklemp/Masters-Report/graphs/discrete_attitude_step.png

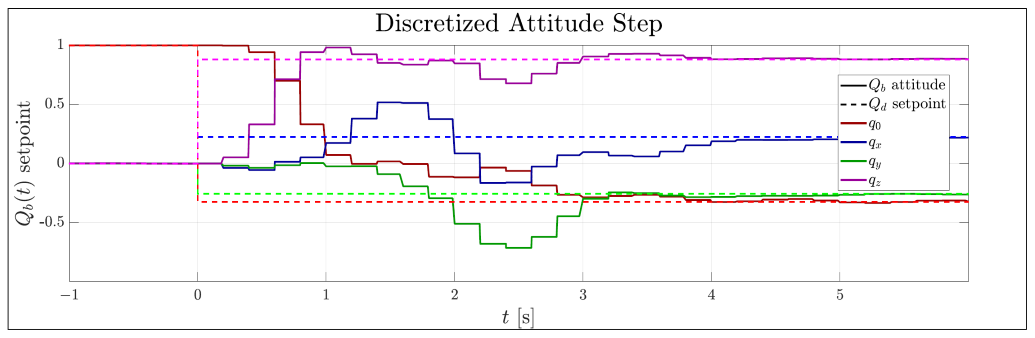
graphs/discrete_attitude_step.png
