nickvonklemp/Masters-Report/graphs/discrete_position_step.png

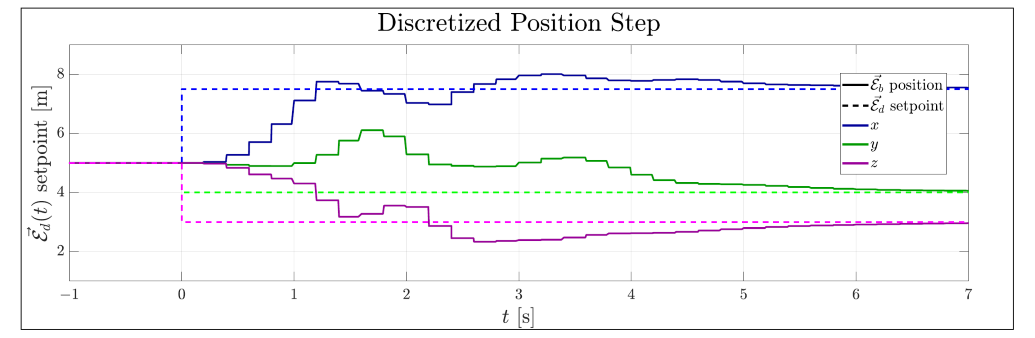
graphs/discrete_position_step.png
