nickvonklemp/Masters-Report/graphs/IBC_Position_Step.png

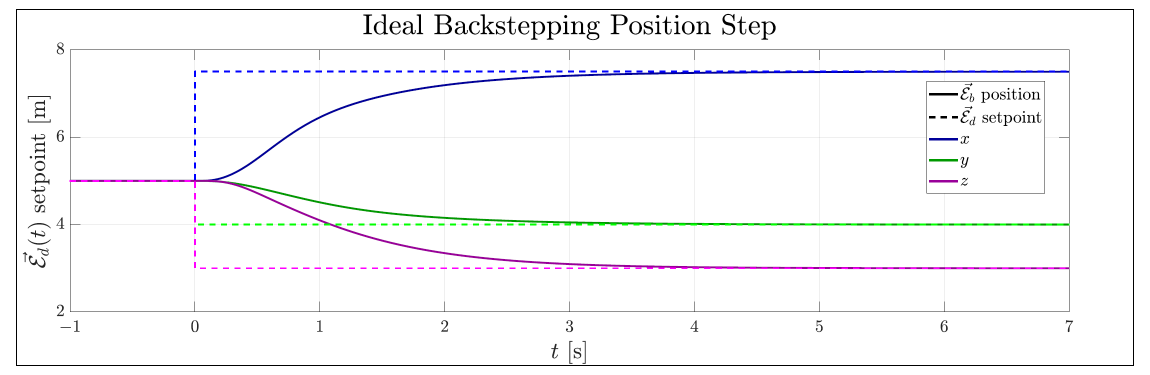
graphs/IBC_Position_Step.png
