nickvonklemp/Masters-Report/graphs/IBC_Step.png

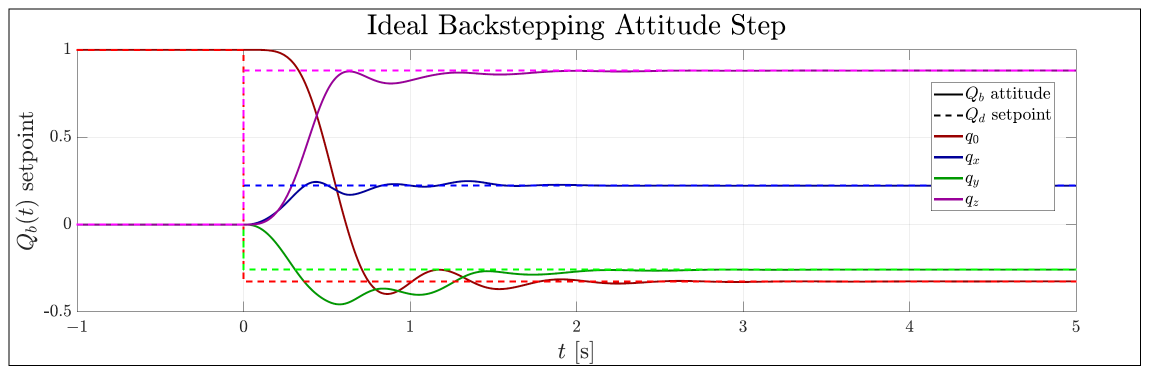
graphs/IBC_Step.png
