nickvonklemp/Masters-Report/graphs/PD_3x3_Dependent_Step.png

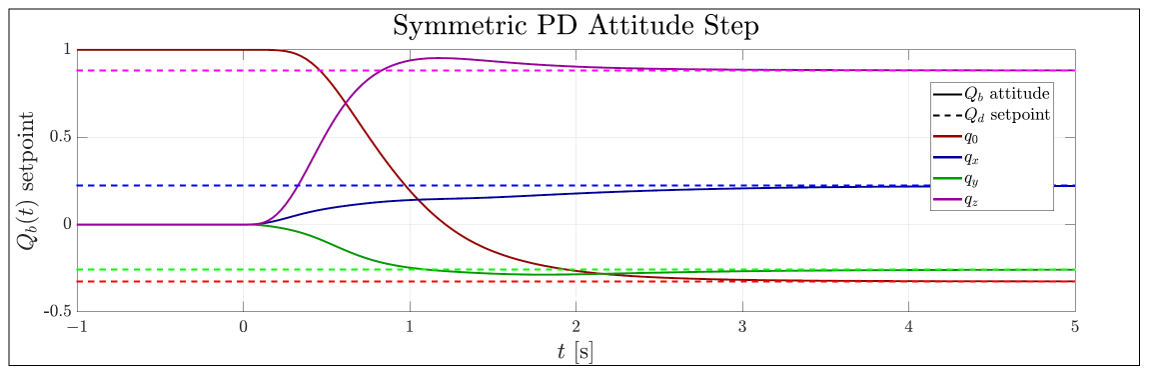
graphs/PD_3x3_Dependent_Step.png
