nickvonklemp/Masters-Report/graphs/PD_Diagonal_Dependent_Step.png

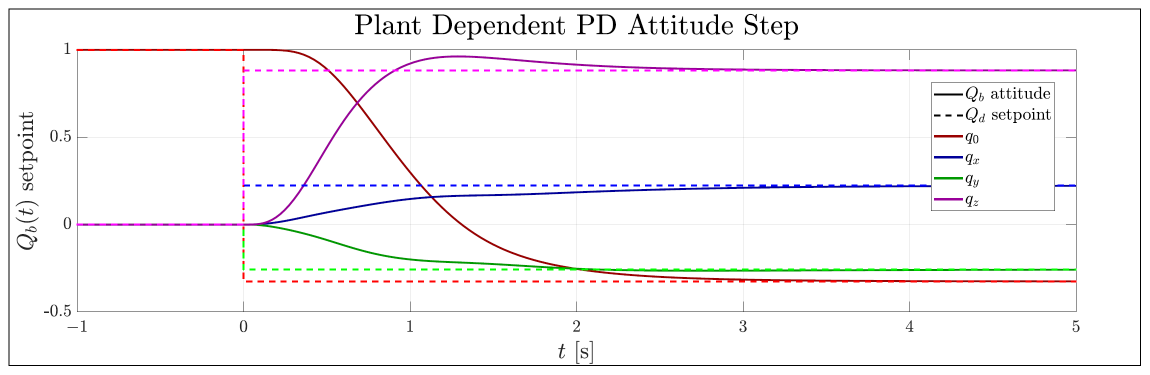
graphs/PD_Diagonal_Dependent_Step.png
