nickvonklemp/Masters-Report/graphs/PD_Diagonal_Gain_Step.png

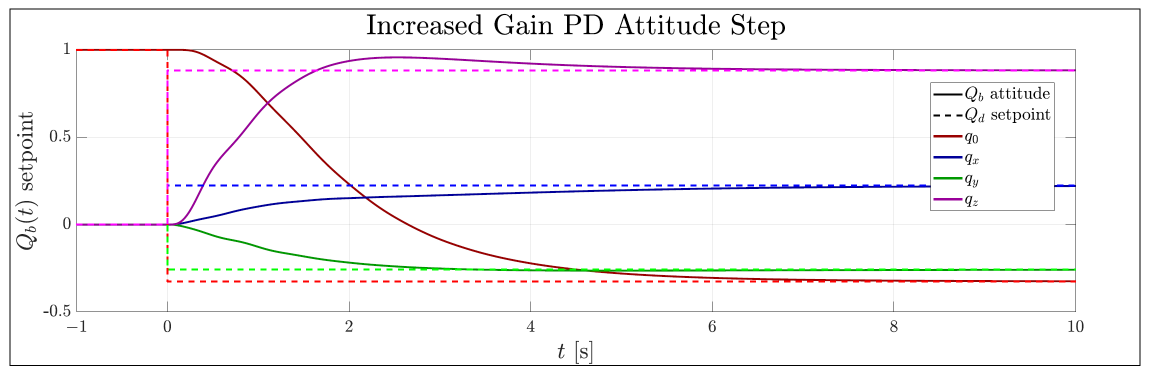
graphs/PD_Diagonal_Gain_Step.png
