nickvonklemp/Masters-Report/graphs/PD_Diagonal_Independent_Step.png

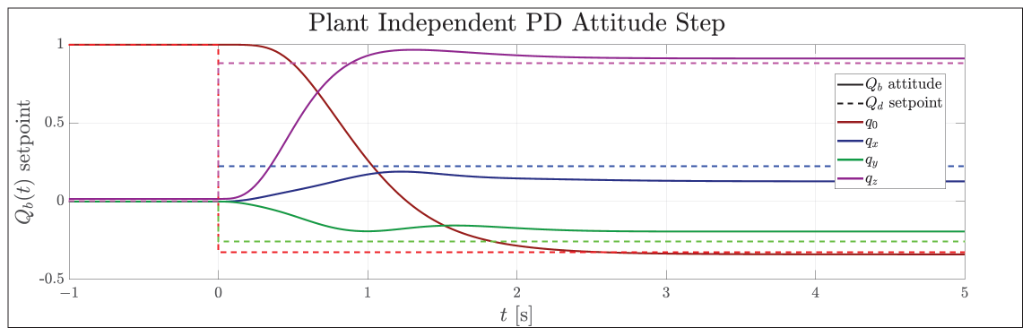
graphs/PD_Diagonal_Independent_Step.png
