nickvonklemp/Masters-Report/graphs/PD_Position_Gain_Step.png

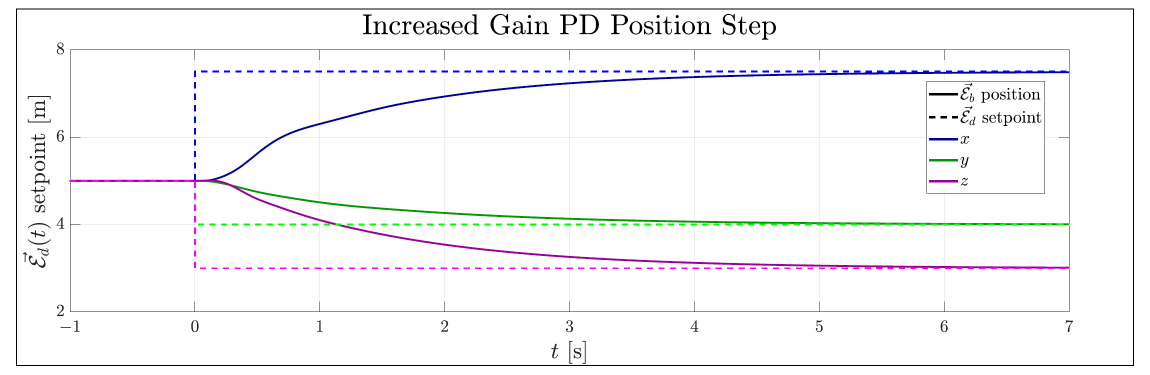
graphs/PD_Position_Gain_Step.png
