nickvonklemp/Masters-Report/graphs/PD_Position_Step.png

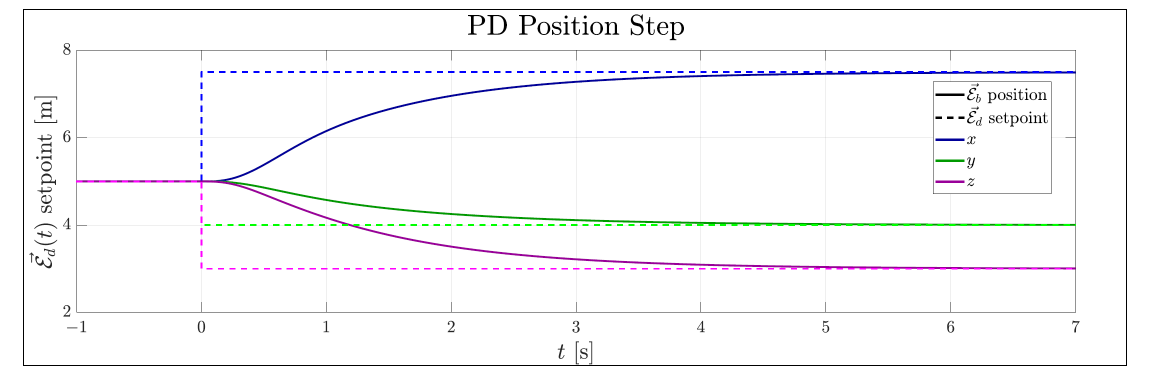
graphs/PD_Position_Step.png
