nickvonklemp/Masters-Report/graphs/PD_Unconstrained_Step.png

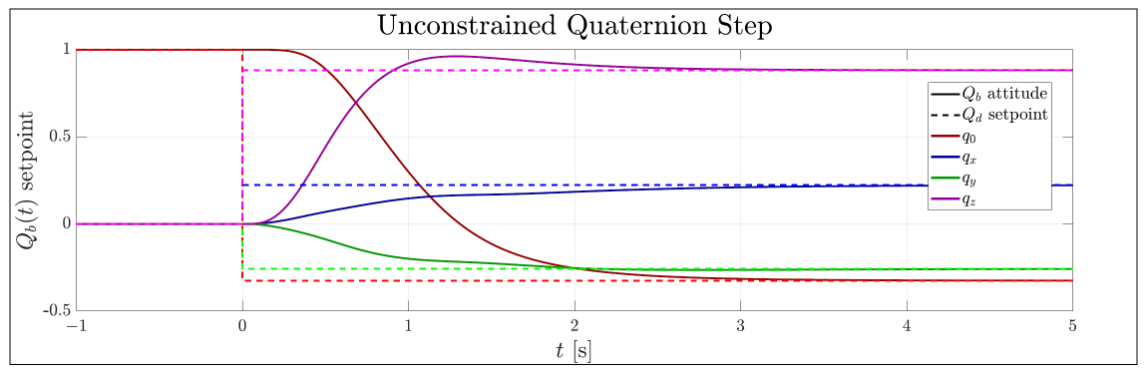
graphs/PD_Unconstrained_Step.png
