nickvonklemp/Masters-Report/graphs/saturated-attitude-step.jpg

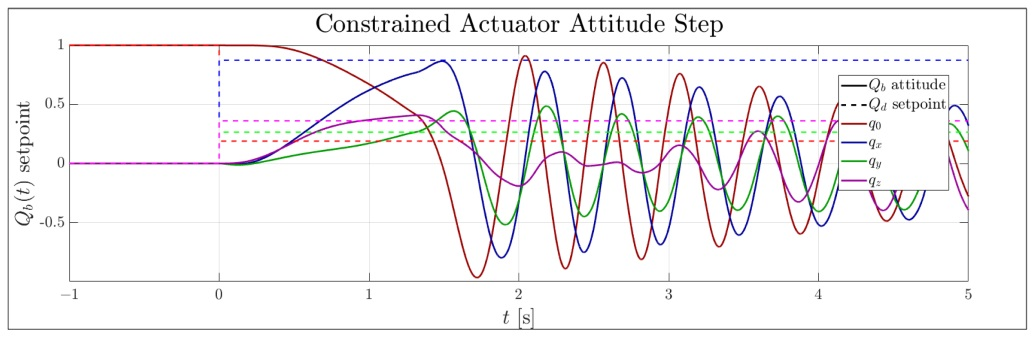
graphs/saturated-attitude-step.jpg
