nickvonklemp/Masters-Report/graphs/saturated-position-step.png

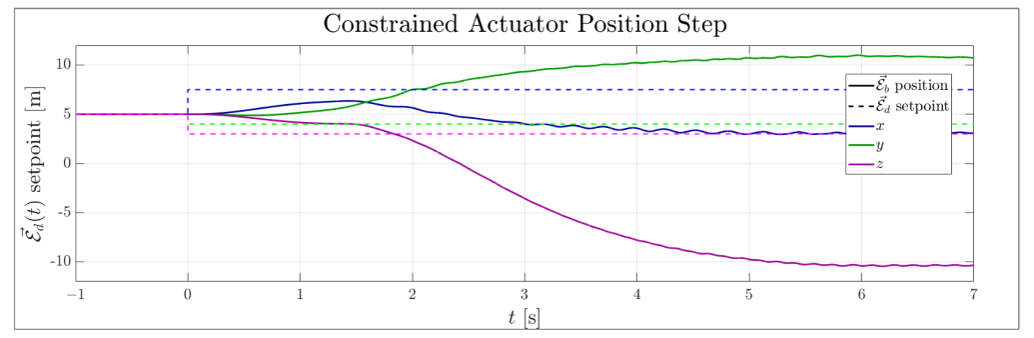
graphs/saturated-position-step.png
