nickvonklemp/Masters-Report/graphs/unsaturated-attitude-step.png

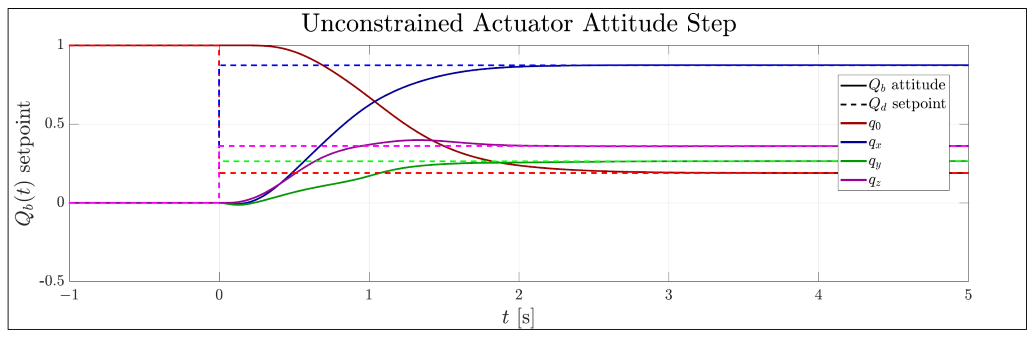
graphs/unsaturated-attitude-step.png
