nickvonklemp/Masters-Report/graphs/unsaturated-position-step.png

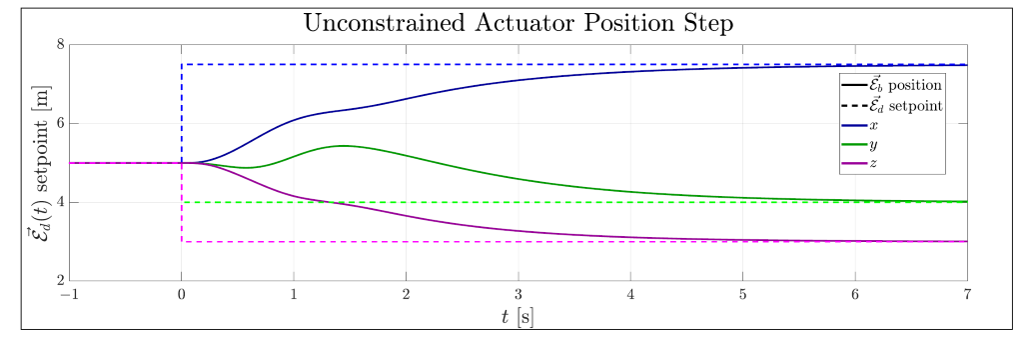
graphs/unsaturated-position-step.png
