nickvonklemp/Masters-Report/graphs/XPD_Step.png

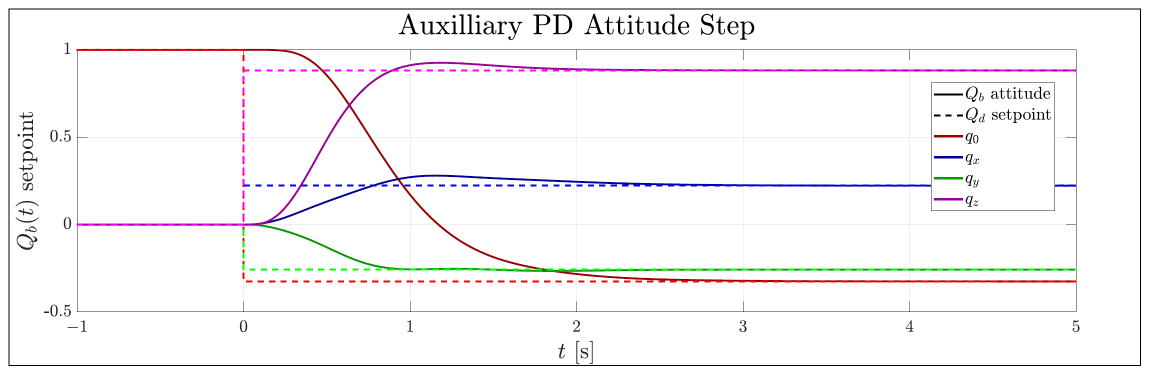
graphs/XPD_Step.png
