nickvonklemp/Masters-Report/pdfpages/electrical-schematic.pdf

20A ESC2 Cobra 2208 2000KV BLDC | S3-PA11/TIM4_CH1 S2-PA7/TIM15_CH1 S1-PA6/TIM16_CH1 S6-PB9/TIM4_CH4 S7-PA2/TIM15_CH1 S8-PA3/TIM15_CH2 | IO2_3-PB11/TIM2_CH4 IO2_4-PB10/TIM2_CH3 IO2_5-PB0/TIM3_CH3 IO2_6-PB1/TIM3_CH4 Corona DS-339MG 6V

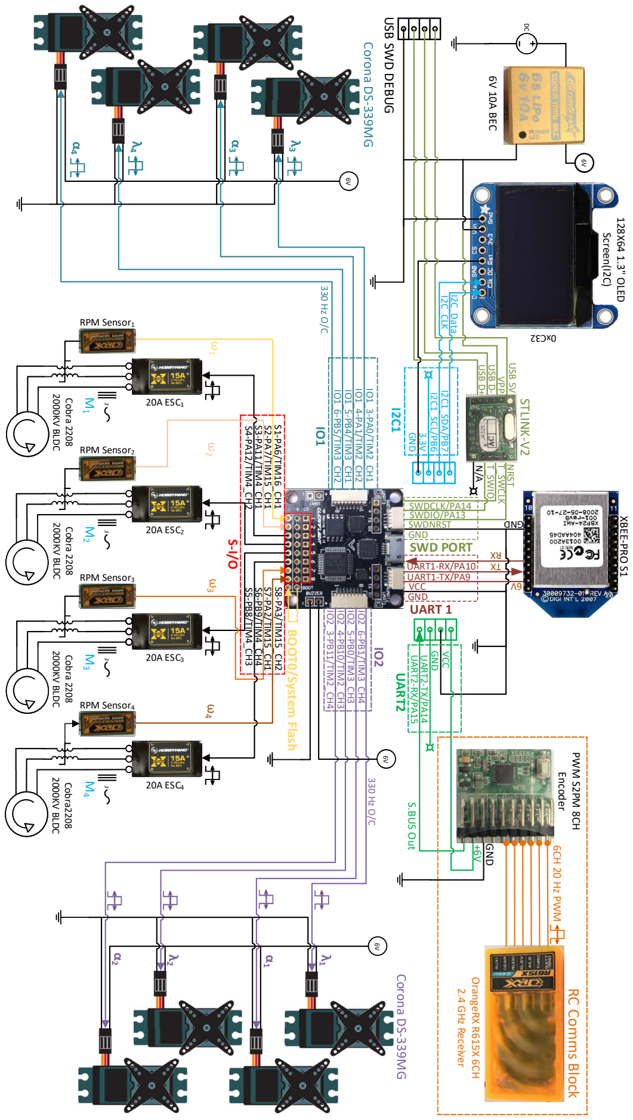
[picture p212: page 1]
4 IO1_6-PB5/TIM3_CH2 IO1_5-PB4/TIM3_CH1 IO1_4-PA1/TIM2_CH2 IO1_3-PA0/TIM2_CH1 DC 6V; GND; SWDNRST; SWDIO/PA13; SWDCLK/PA14 I2C1; I2C1_SCL/PB6 I2C1_SDA/PB7 GND ³.3V; 128X64 1.3" OLED Screen(I2C); VCC GND; UART1-TX/PA9; UART1-RX/PA10; UART 1; SWD PORT UART2; GND VCC UART2-RX/PA15 UART2-TX/PA14; OrangeRX R615X 6CH ².4 GHz Receiver; PWM S2PM 8CH Encoder IO2; RPM Sensor4; 20A ESC4 Cobra2208 2000KV BLDC; RPM Sensor1; 20A ESC1 Cobra 2208 2000KV BLDC; 1 RPM Sensor2 M2; 2 RPM Sensor3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

4 IO1 RC Comms Block I2C_CLK I2C_Data BOOT0/System Flash

1 Corona DS-339MG 330 Hz O/C N/A T_SWIO T_SWCLK NRST STLINK-V2 USB D+ USB D- USB 5V VPP

3 S4-PA12/TIM4_CH2 S5-PB8/TIM4_CH3 S-I/O 6CH 20 Hz PWM S.BUS Out+6V GND 6V
