nickvonklemp/Masters-Report/pdfpages/gimbal-lock.pdf

H

G

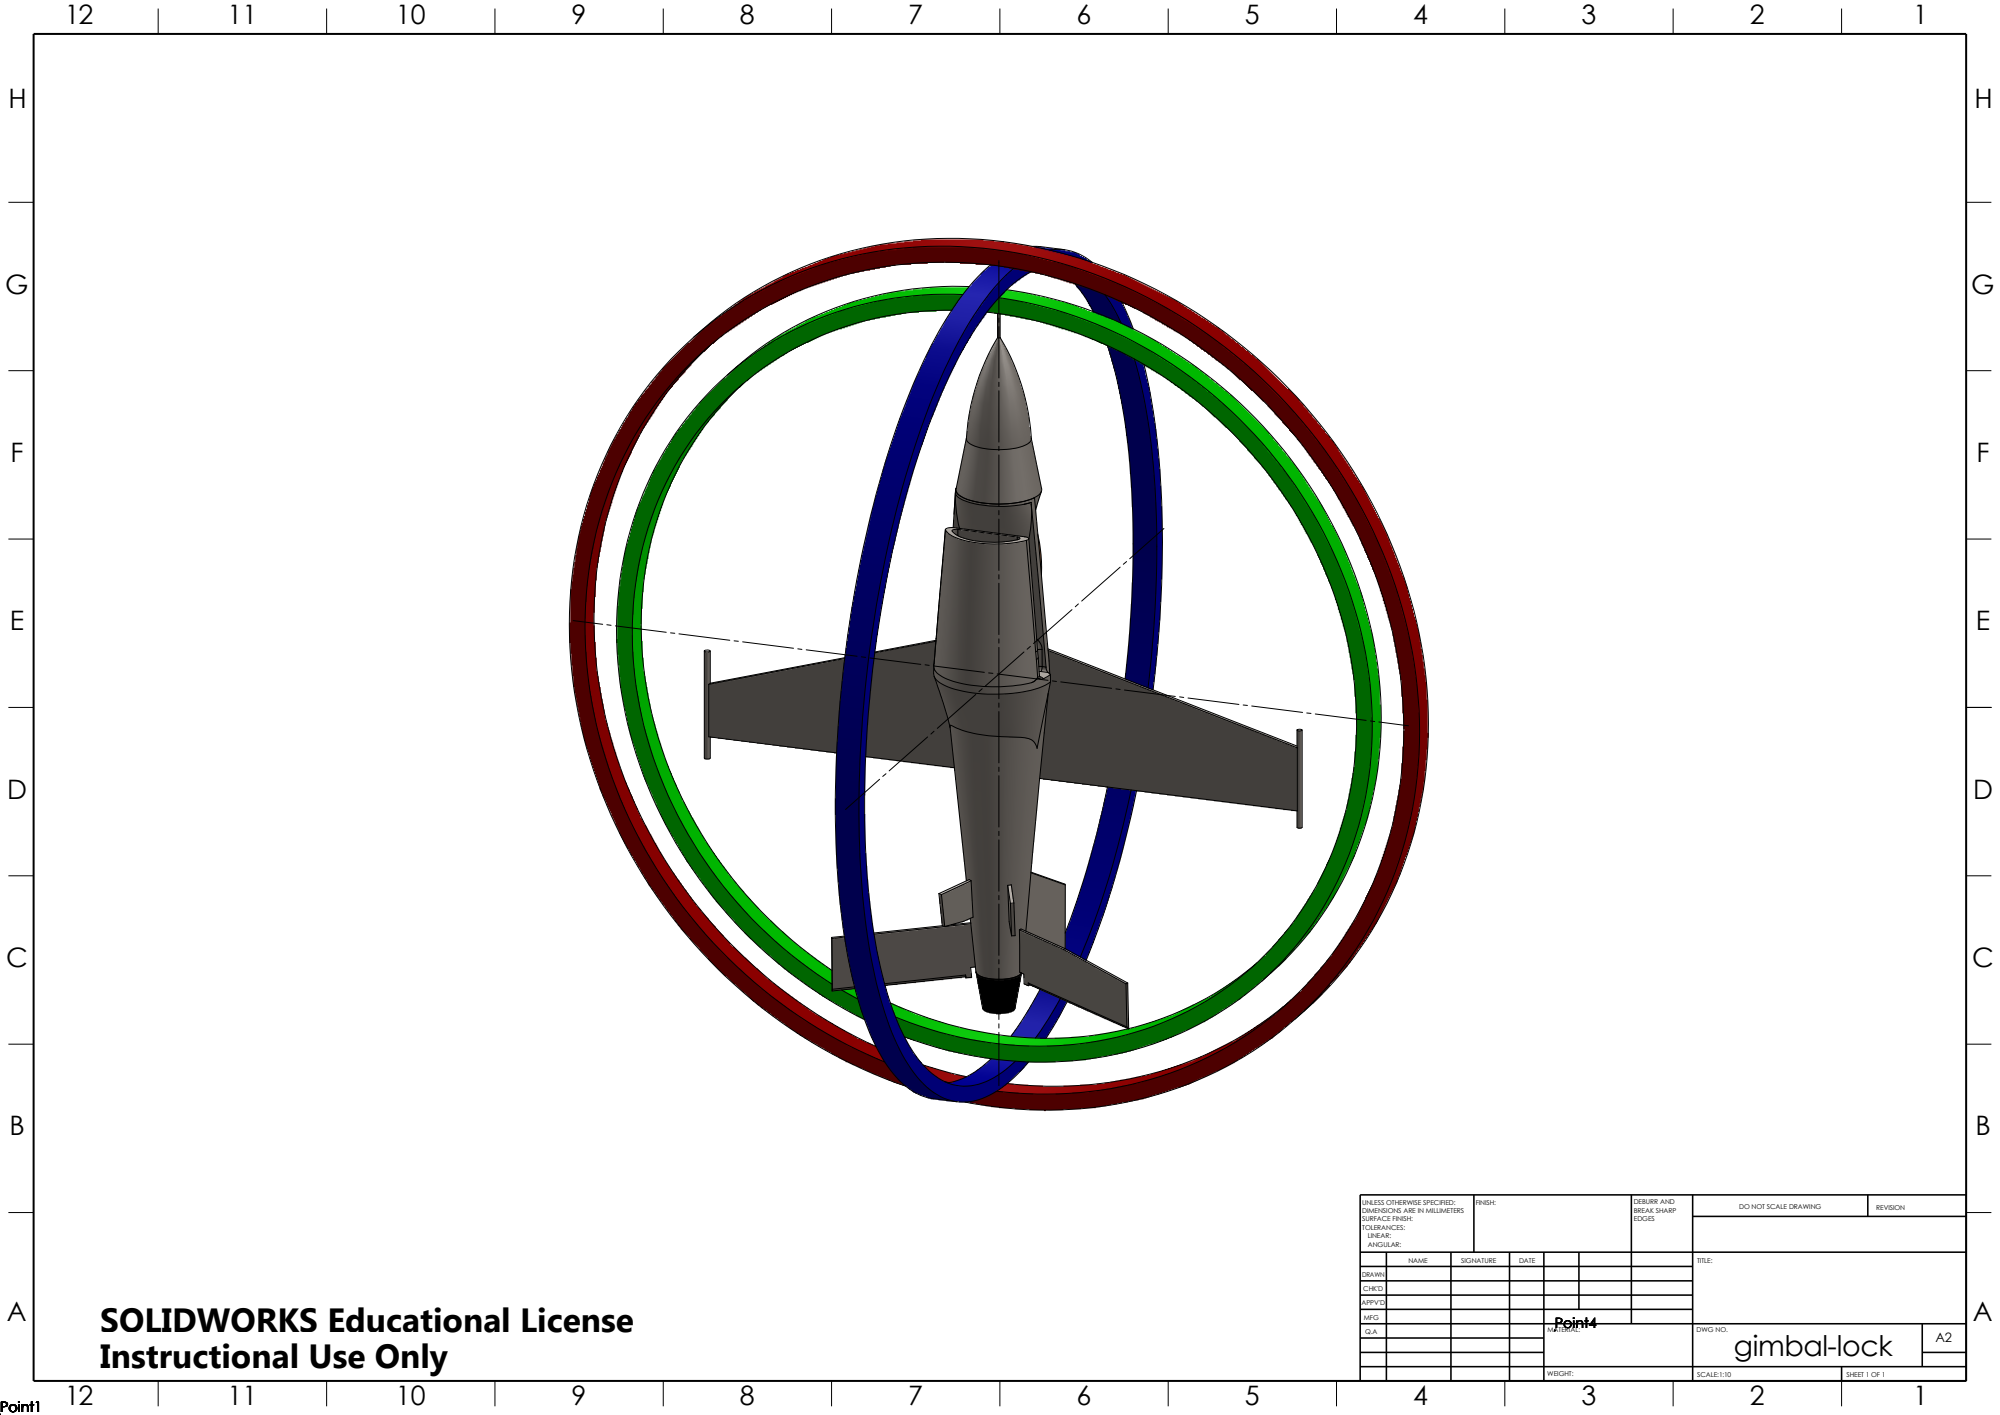
[picture p213: page 1]
SCALE:1:10; SHEET 1 OF 1; WEIGHT:; DO NOT SCALE DRAWING; REVISION; FINISH:; EDGES; DEBURR AND BREAK SHARP; Point4; Point1; SOLIDWORKS Educational License; Instructional Use Only

UNLESS OTHERWISE SPECIFIED:
DIMENSIONS ARE IN MILLIMETERS
SURFACE FINISH:
TOLERANCES:
LINEAR:
ANGULAR:

NAME | SIGNATURE | DATE | | | | TITLE:

DRAWN

CHK'D

APPV'D

MFG

Q.A | | | | MATERIAL: | DWG NO. gimbal-lock | A2
