nickvonklemp/Masters-Report/pdfpages/gimbal.pdf

H

G

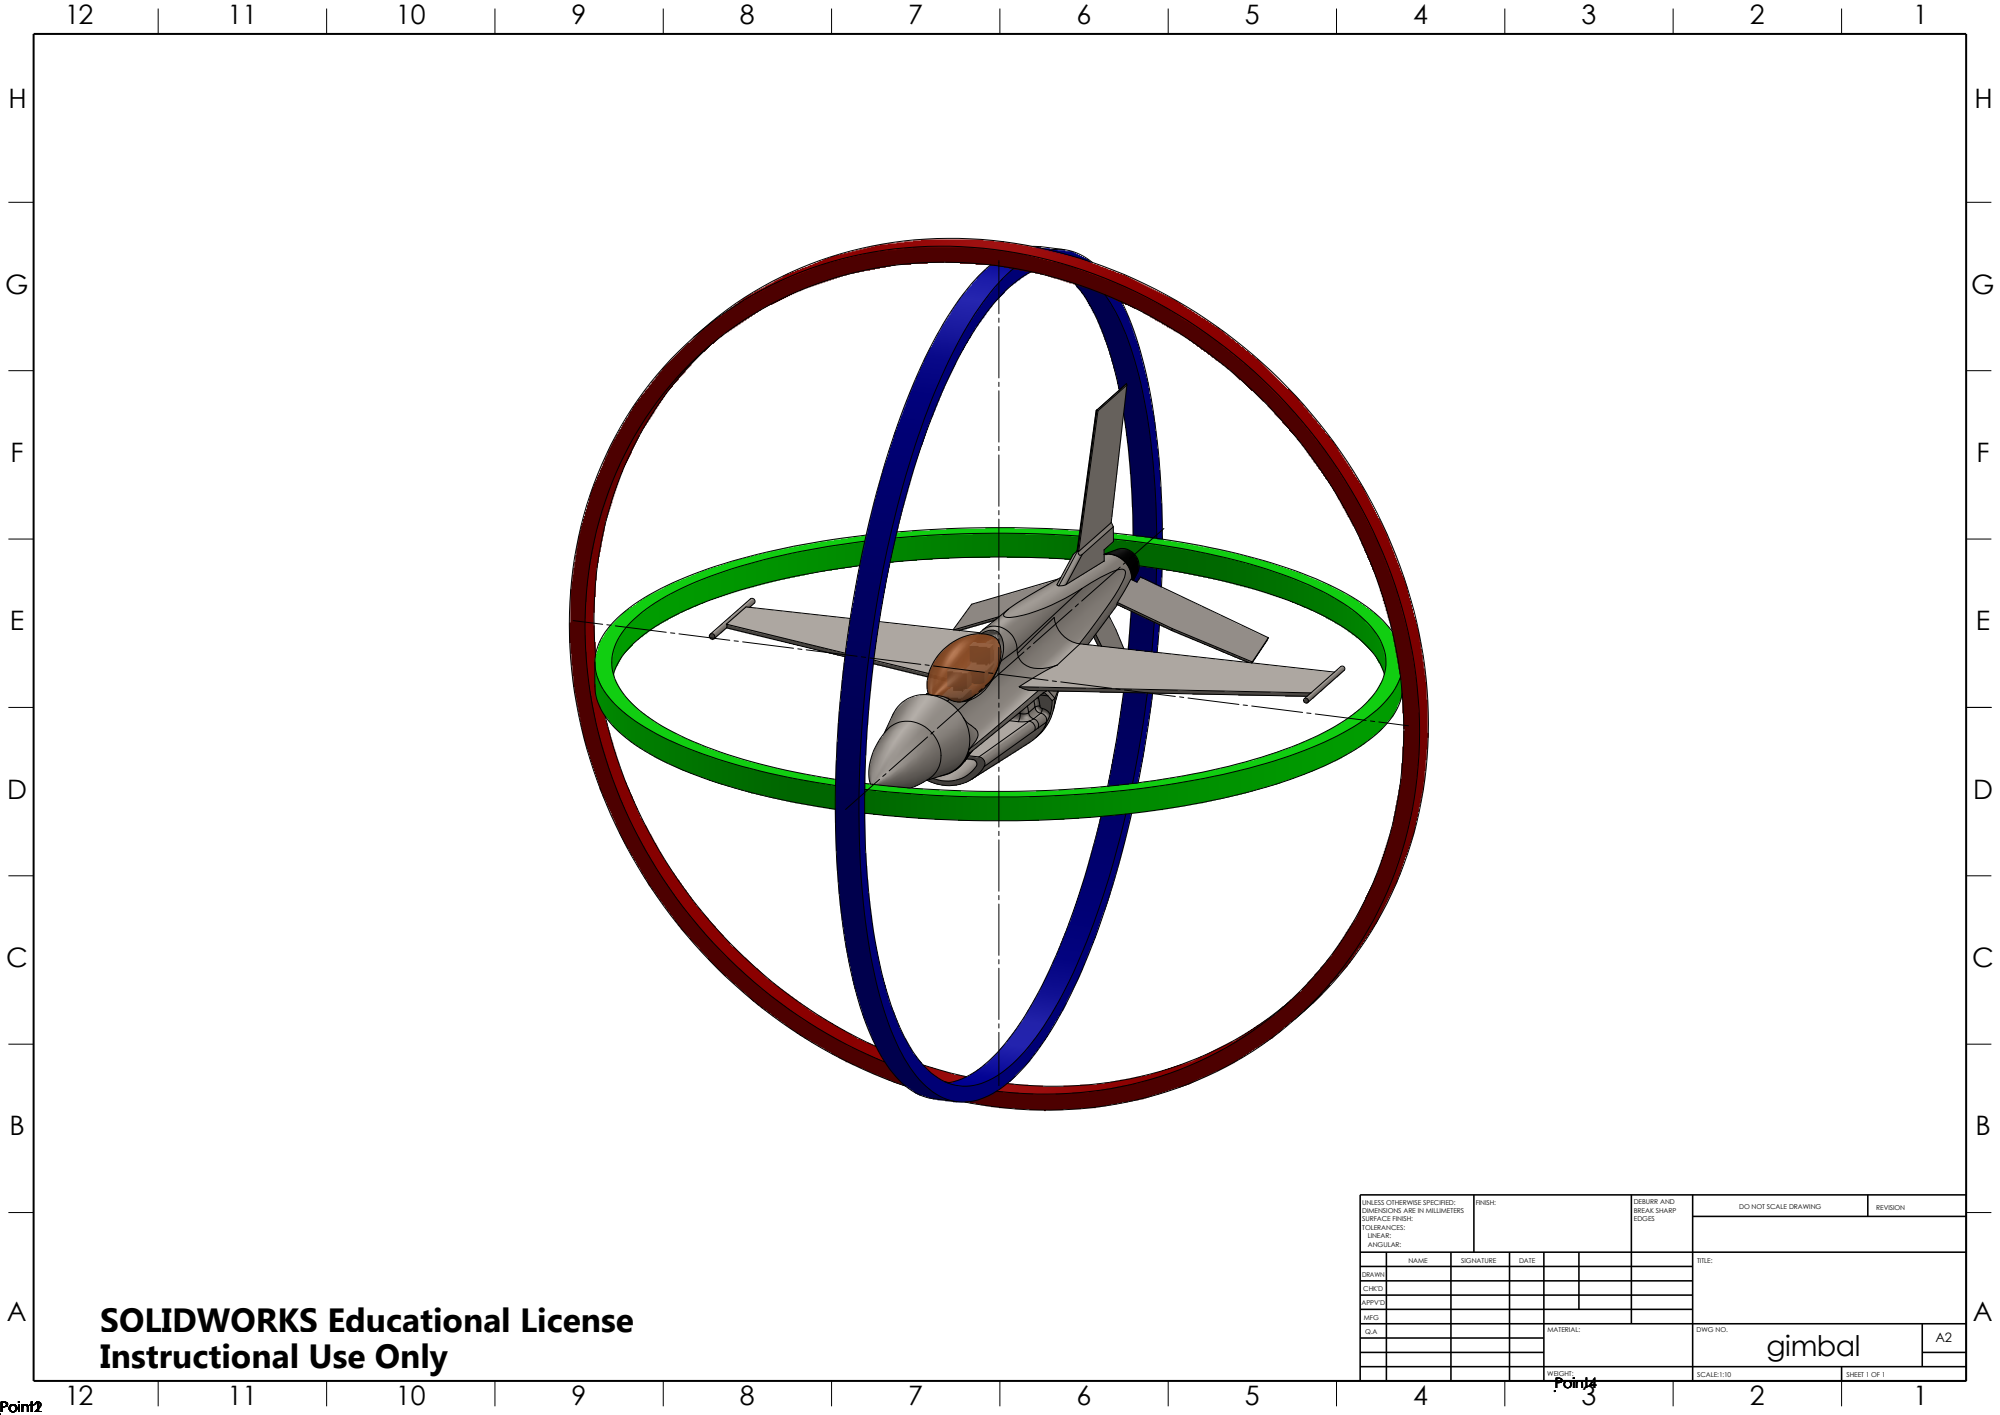
[picture p214: page 1]
WEIGHT:; SCALE:1:10; SHEET 1 OF 1; DO NOT SCALE DRAWING; REVISION UNLESS OTHERWISE SPECIFIED: DIMENSIONS ARE IN MILLIMETERS; Point21; Point4; Point2

SURFACE FINISH: TOLERANCES: LINEAR: ANGULAR: | FINISH: | DEBURR AND BREAK SHARP EDGES

NAME | SIGNATURE | DATE | | | | TITLE:

DRAWN

CHK'D

SOLIDWORKS Educational License
Instructional Use Only

APPV'D

MFG

Q.A | | | | MATERIAL: | DWG NO. gimbal | A2
