nickvonklemp/Masters-Report/pdfpages/working.pdf

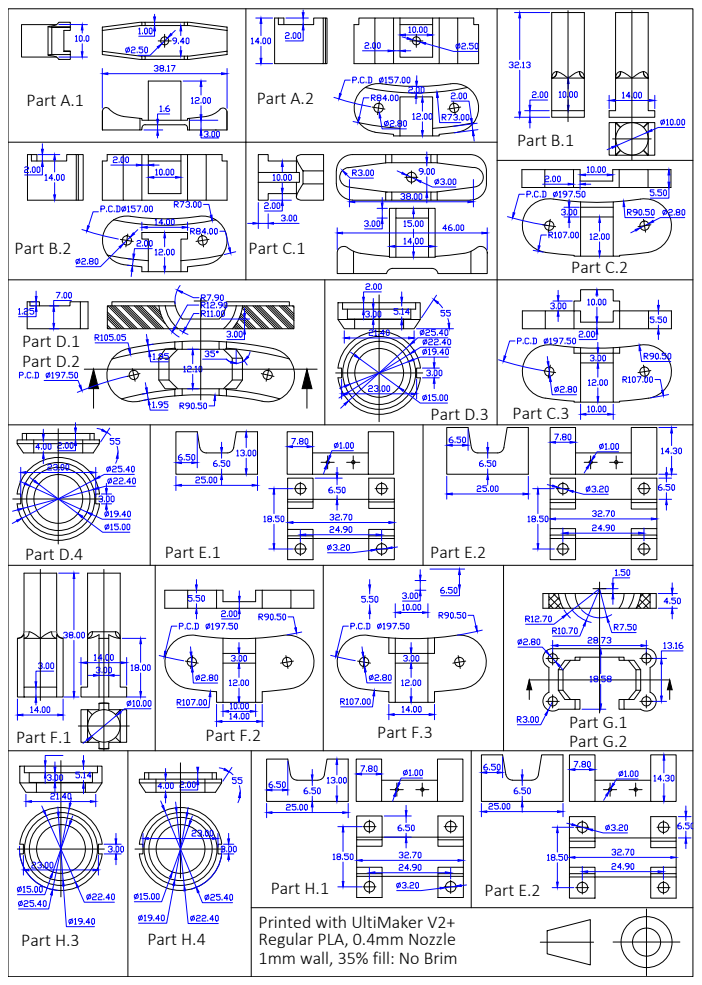
[picture p215: page 1]
Part A.1; Part A.2; Part B.1; Part B.2; Part C.1; Part C.2; Part C.3; Part D.1 Part D.2; Part D.3; Part D.4; Part E.1; Part E.2; Part F.1; Part F.2; Part F.3; Part G.1; Part G.2; Part H.3; Part H.4; Part H.1

Printed with UltiMaker V2+
Regular PLA, 0.4mm Nozzle
1mm wall, 35% fill: No Brim
