nickvonklemp/Masters-Report/pdfpages/rings.pdf

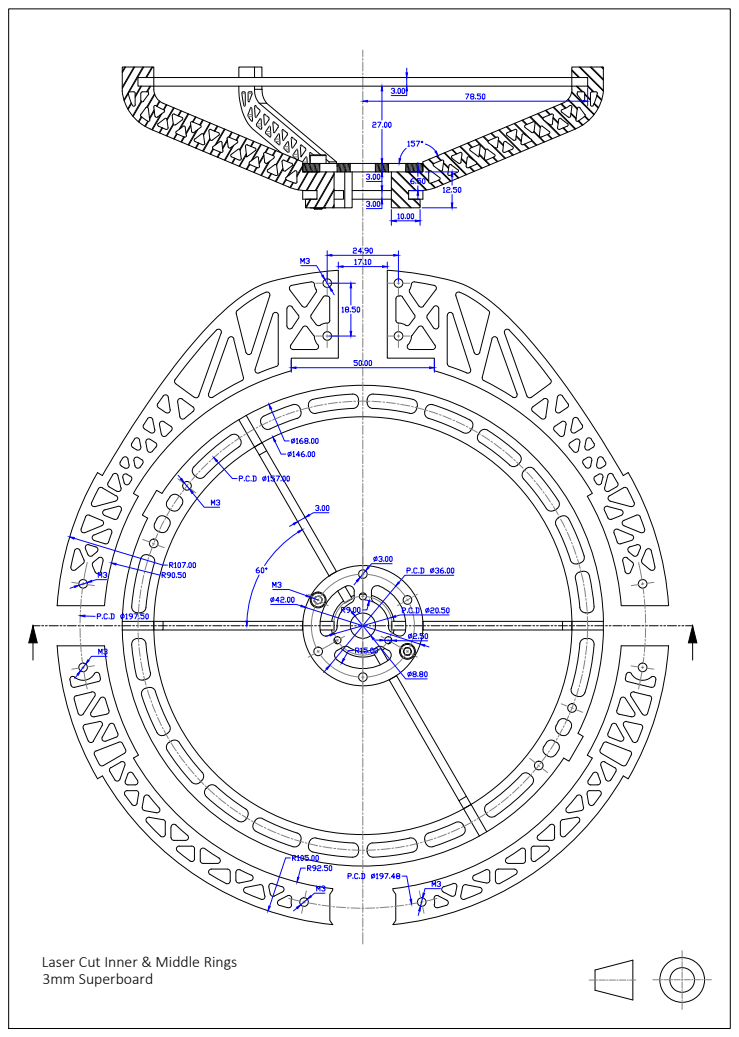
[picture p216: page 1]

Laser Cut Inner & Middle Rings
3mm Superboard
