nickvonklemp/Masters-Report/pdfpages/iso-design.pdf

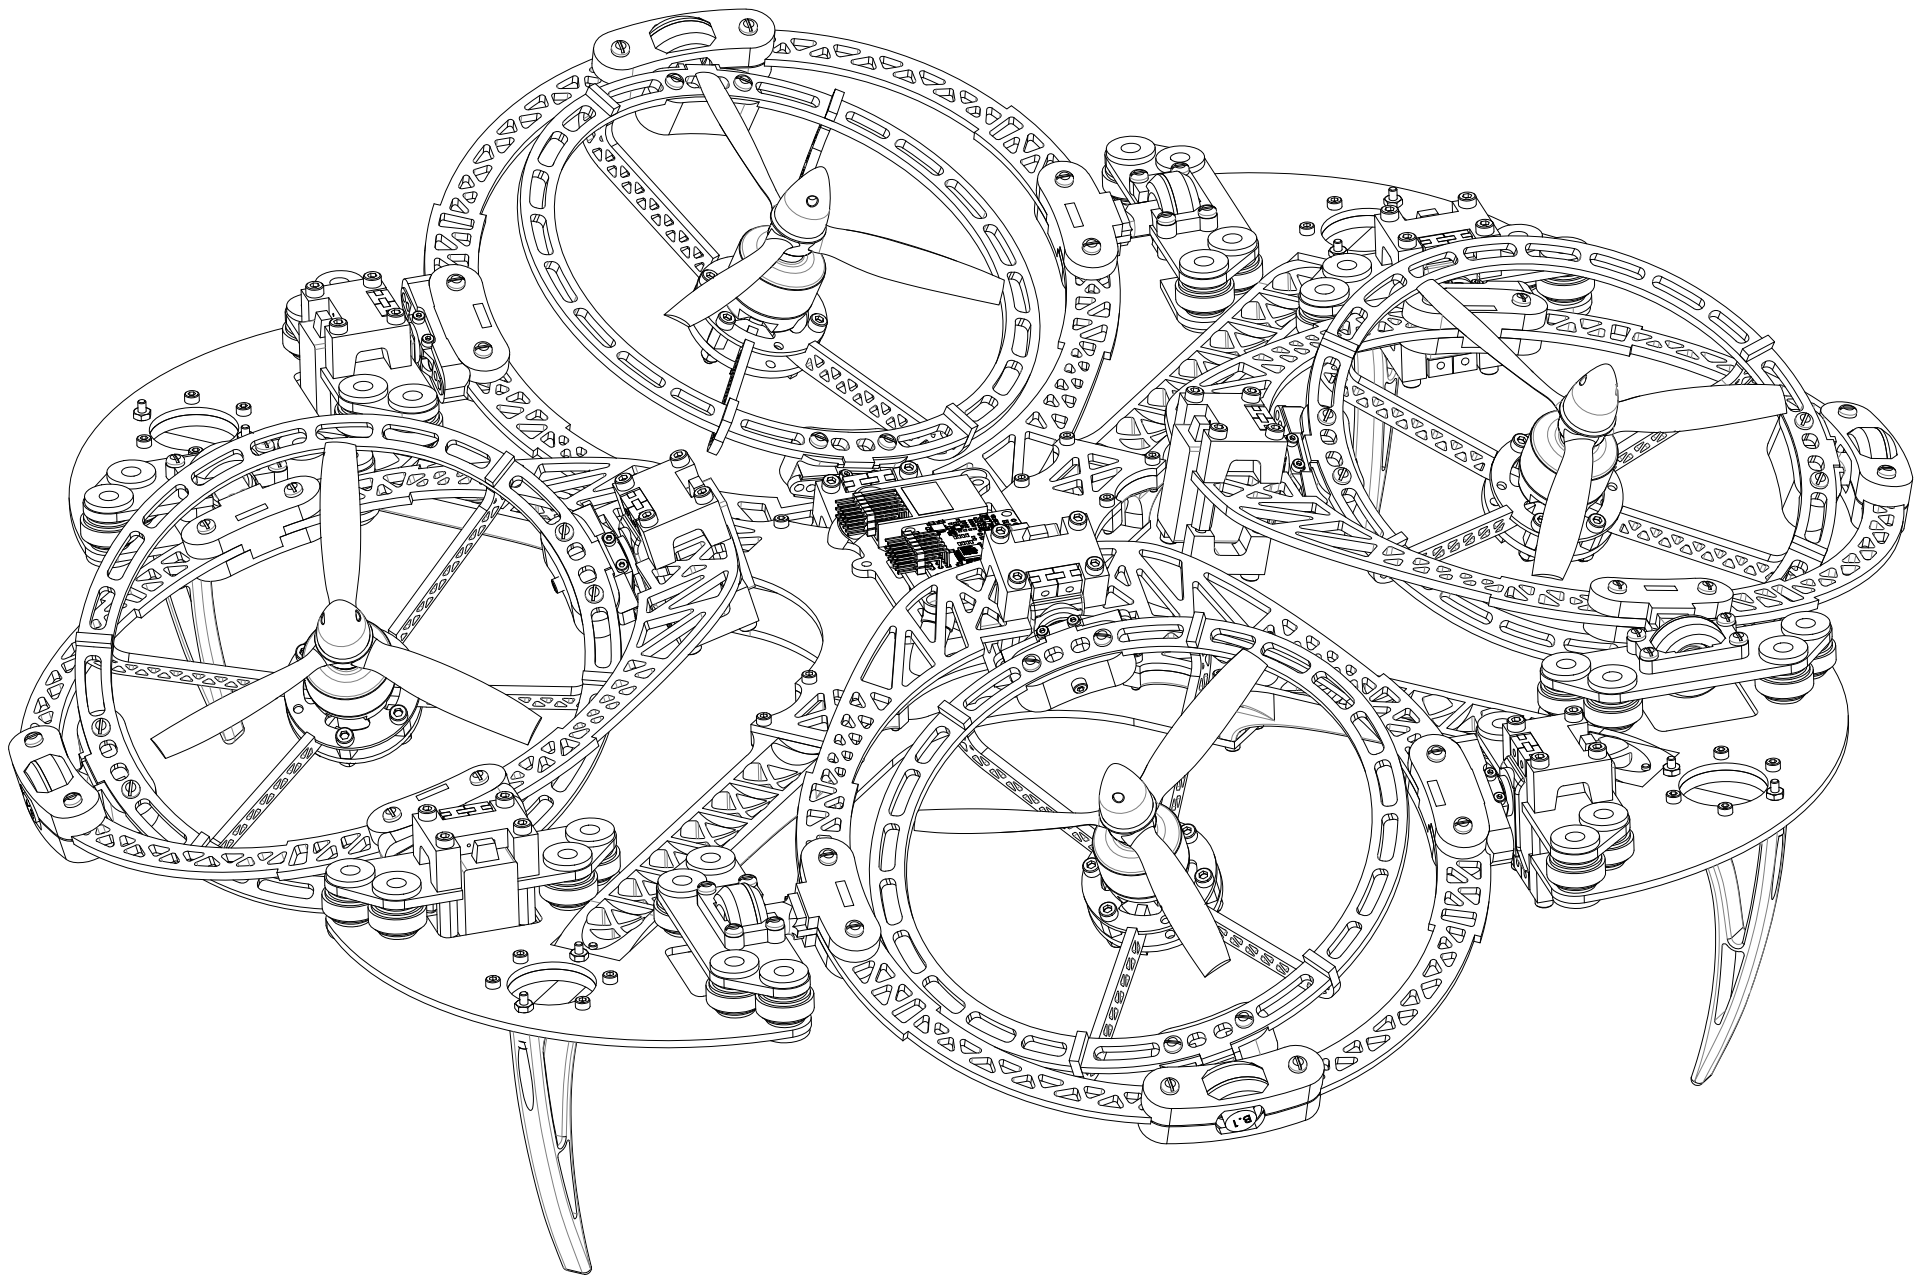
[picture p217: page 1]
