nickvonklemp/Masters-Report/pdfpages/deluxe-schematic.pdf

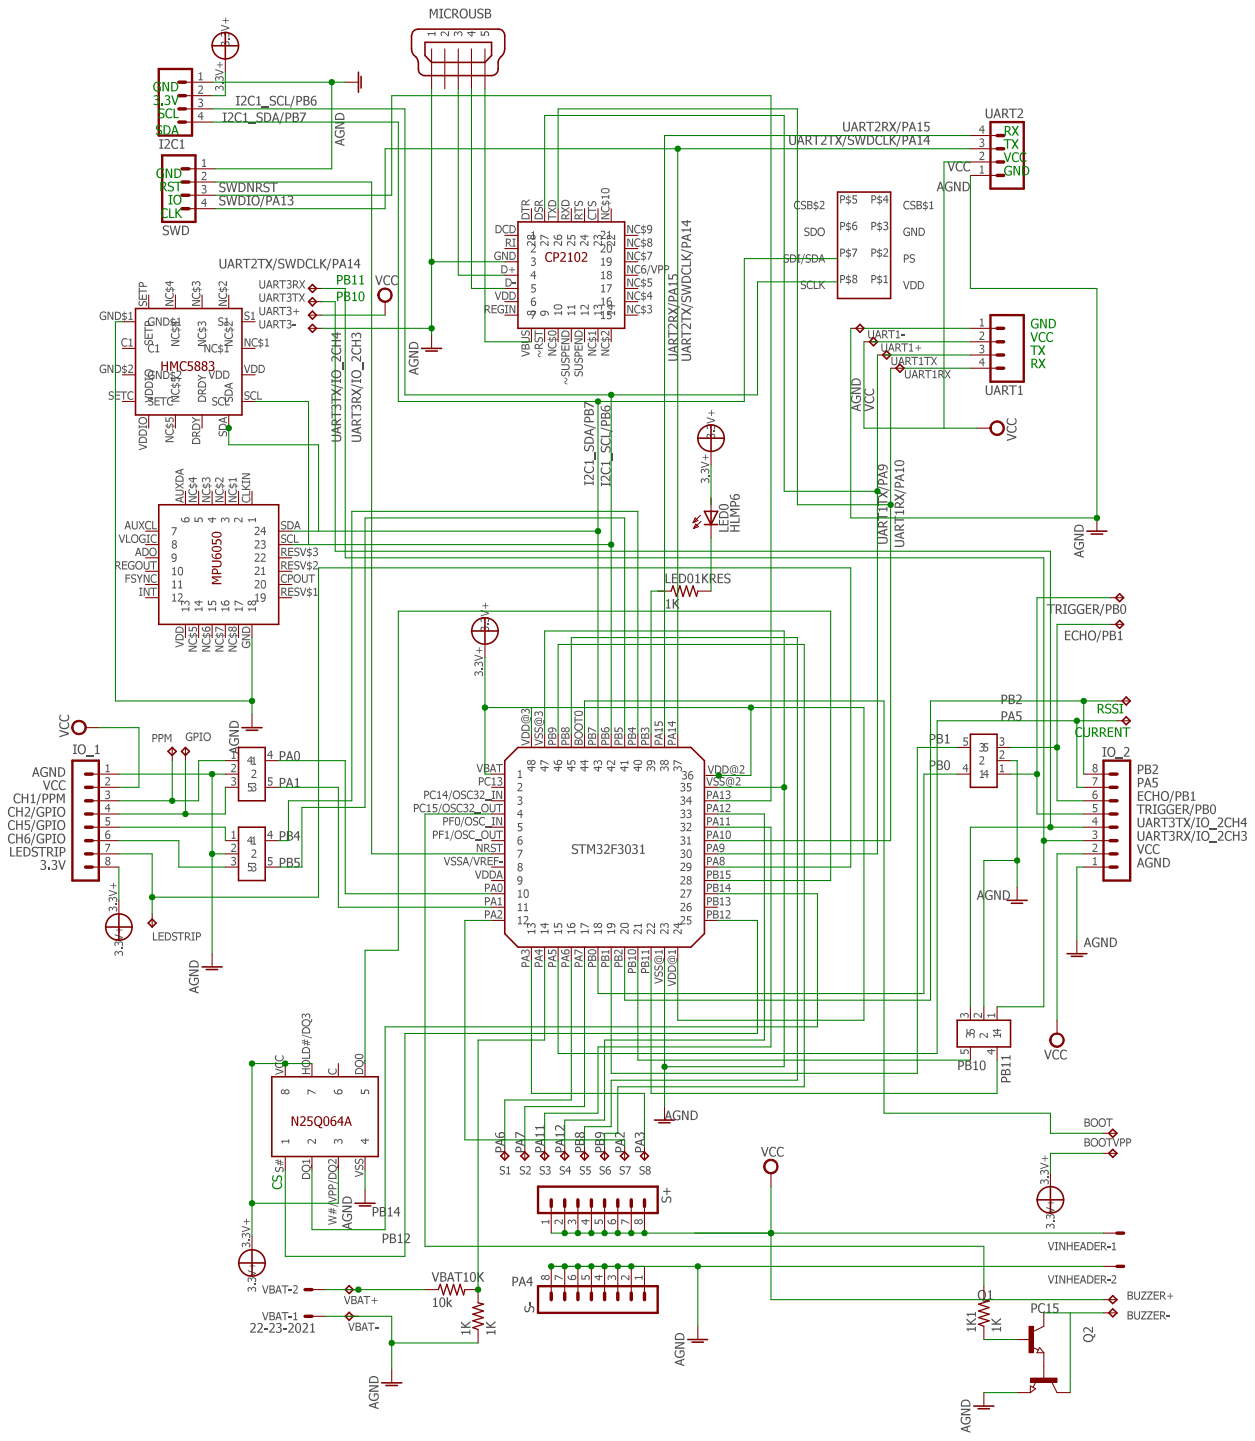
[picture p218: page 1]
