nickvonklemp/Masters-Report/pdfpages/strain.pdf

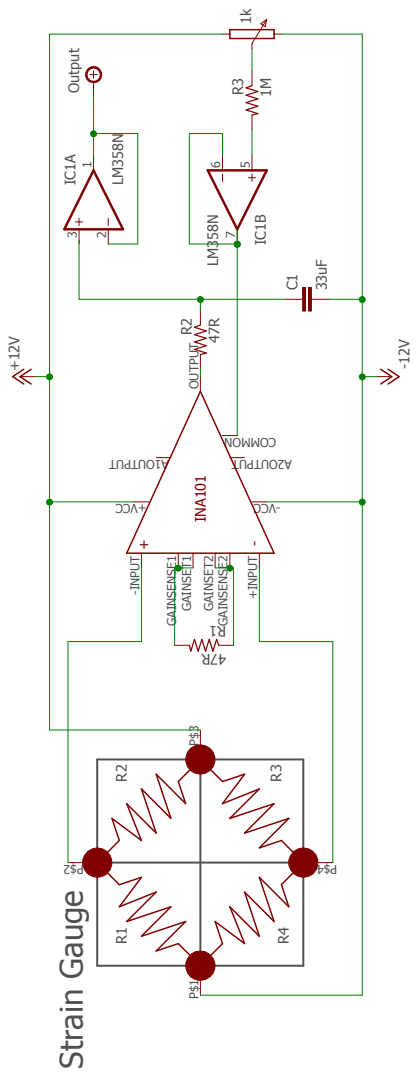
[picture p219: page 1]
Output; GAINSENSE1; GAINSET1; GAINSET2; GAINSENSE2; +INPUT; -INPUT; Strain Gauge; INA101
