nickvonklemp/Masters-Report/(commit log)

2016-08-14 Commit 024
    [Reference Frames.dwg]
2016-08-25 Commit 012
    [Reference Frames.dwg]
2016-08-27 Commit 034
    [ISO Motor Module Assembly.DWG, Motor Module Top View.DWG, Top View.DWG]
2016-08-28 Commit 035
    [Frame.DWG, ISO Motor Module Assembly.DWG, Top View.DWG]
2016-08-29 Commit 036
    [Frame.DWG]
2016-09-06 Commit 042
    [Frame.DWG, ISO Motor Module Assembly.DWG, Motor Module Top View.DWG, Reference Frames.dwg, Top View.DWG]
2016-11-04 Commit 072 Completed inertias w.r.t cobra motors. Still needs new working drawings & transfer functions
